bobc/bobc_hardware/Decapede/Decapede.jpg

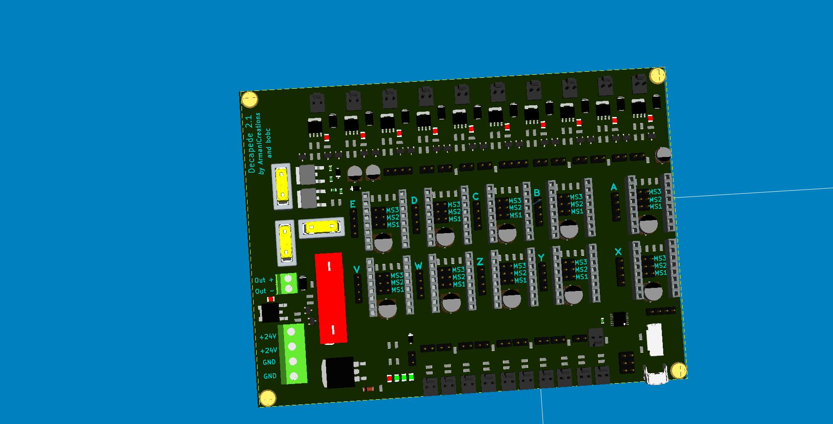
Decapede/Decapede.jpg
