bobc/bobc_hardware/CoreSam3x/CoreSam3x.png

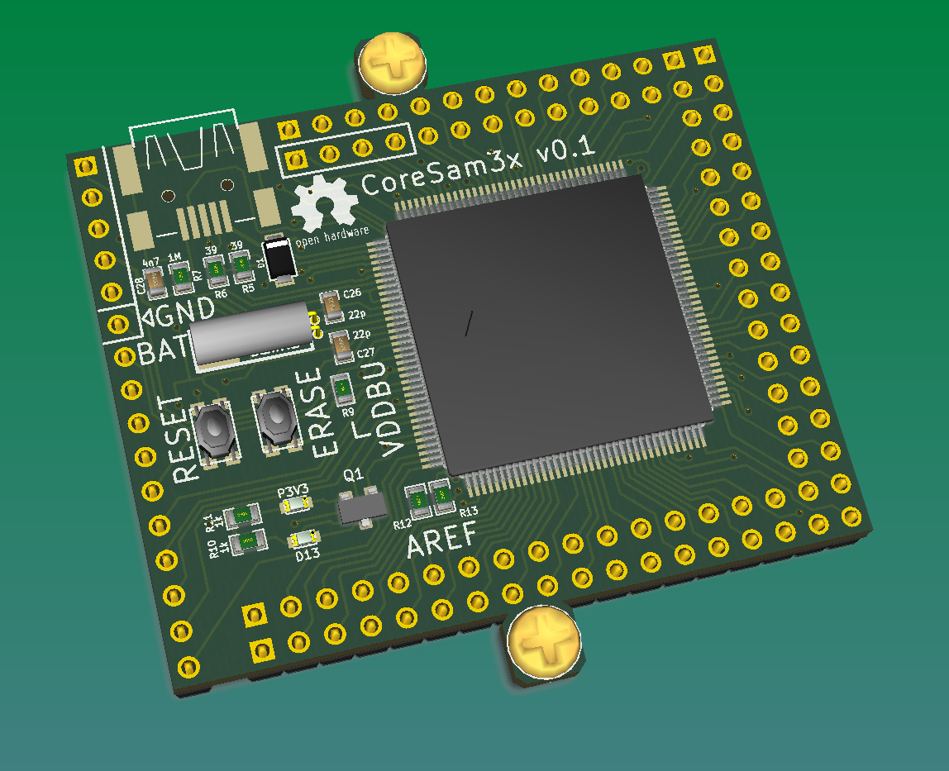
CoreSam3x/CoreSam3x.png
