bobc/bobc_hardware/Control Panel/control_panel.png

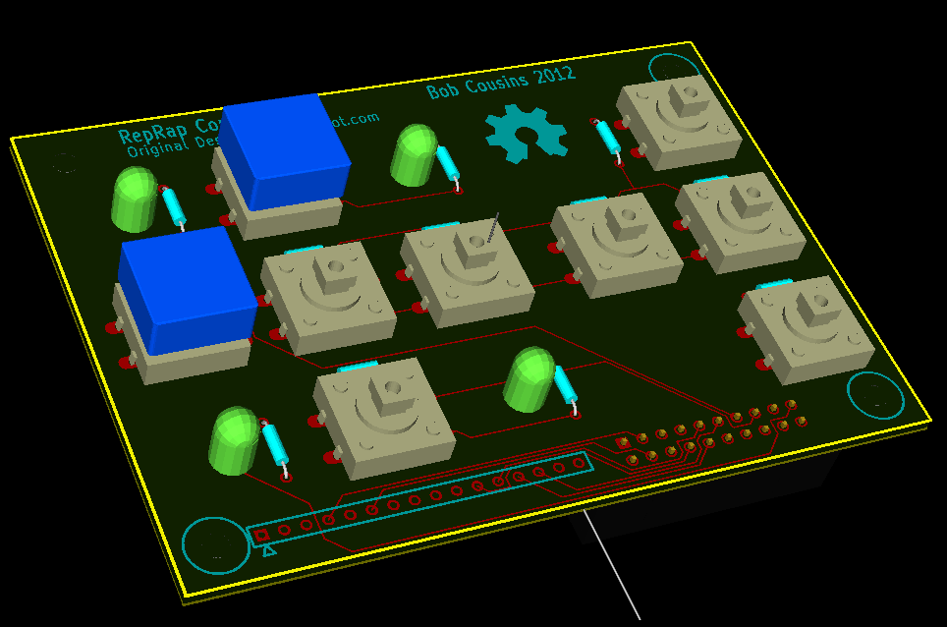
Control Panel/control_panel.png
