bobc/bobc_hardware/CoreSam3x/CoreSam3x_back.png

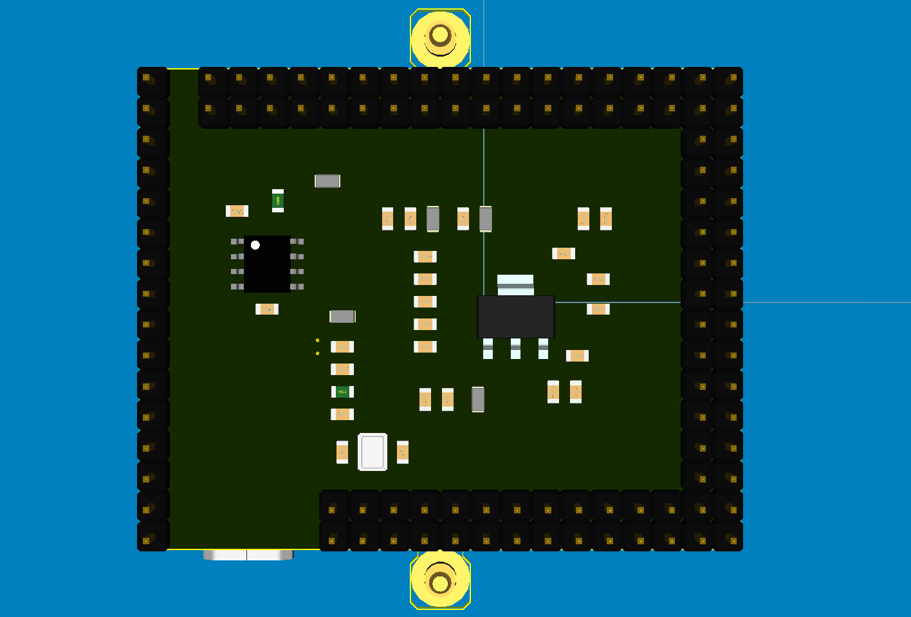
CoreSam3x/CoreSam3x_back.png
