bobc/bobc_hardware/CoreSam3x/CoreSam3x_top.png

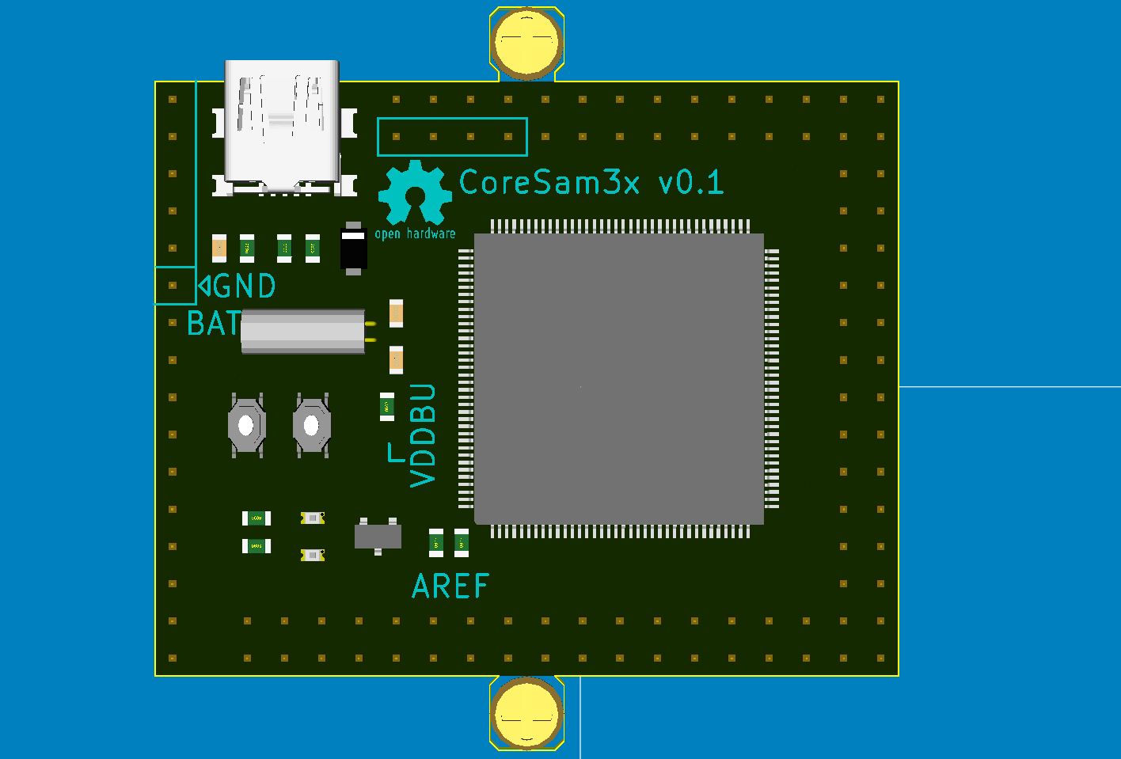
CoreSam3x/CoreSam3x_top.png
