bobc/bobc_hardware/Due-RIB/RIB_concept.png

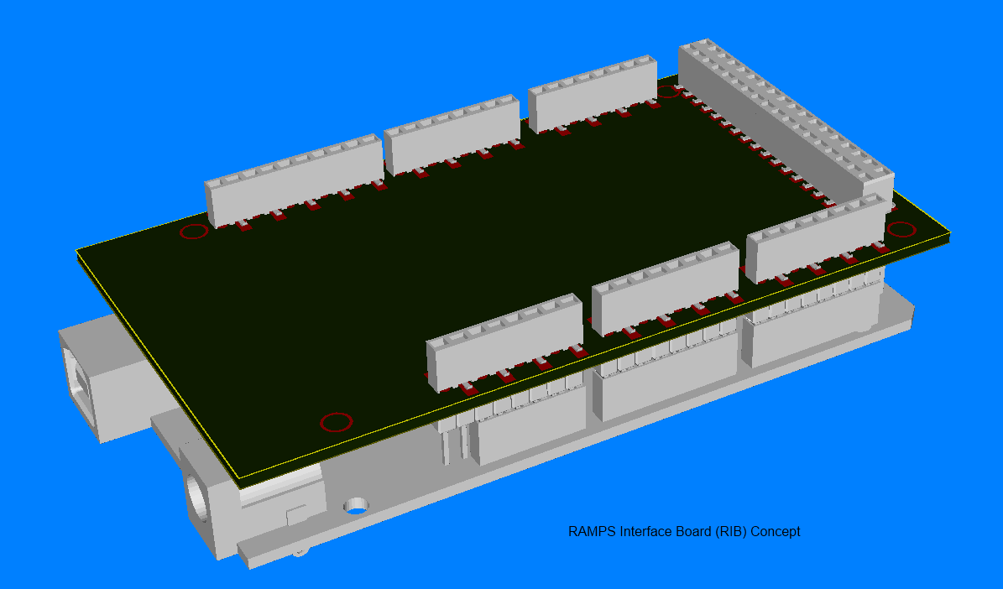
Due-RIB/RIB_concept.png
