bobc/bobc_hardware/matrix_clock_cc_4digit/matrix_clock.png

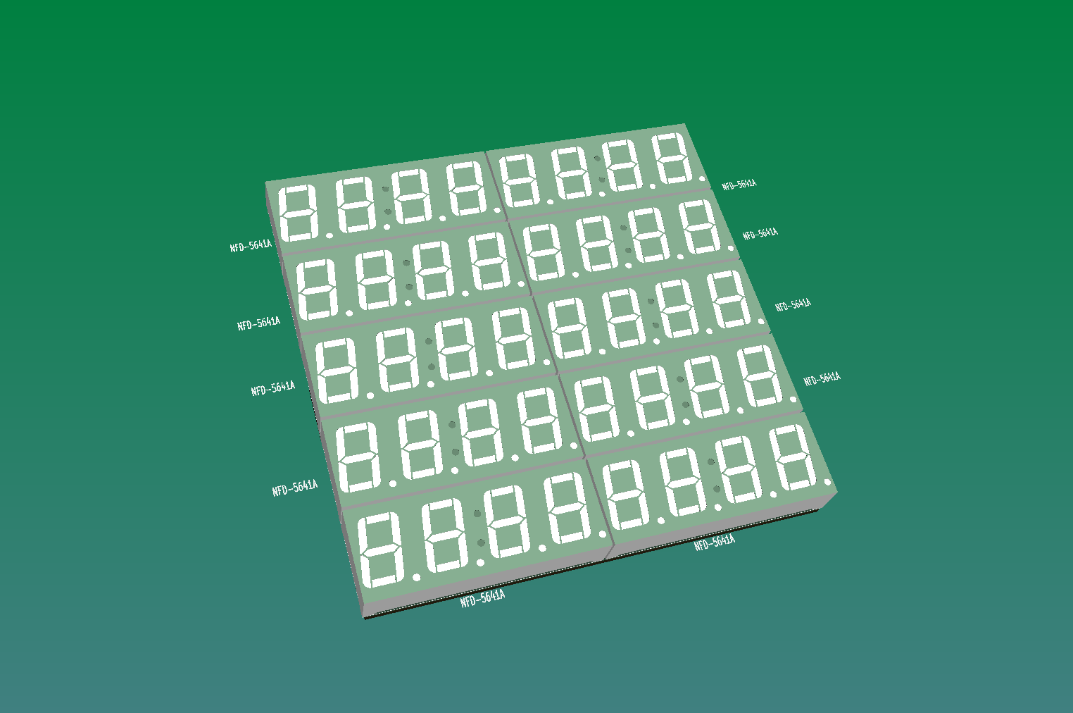
matrix_clock_cc_4digit/matrix_clock.png
