bobc/bobc_hardware/MS-F1/MS-F100-bottom.png

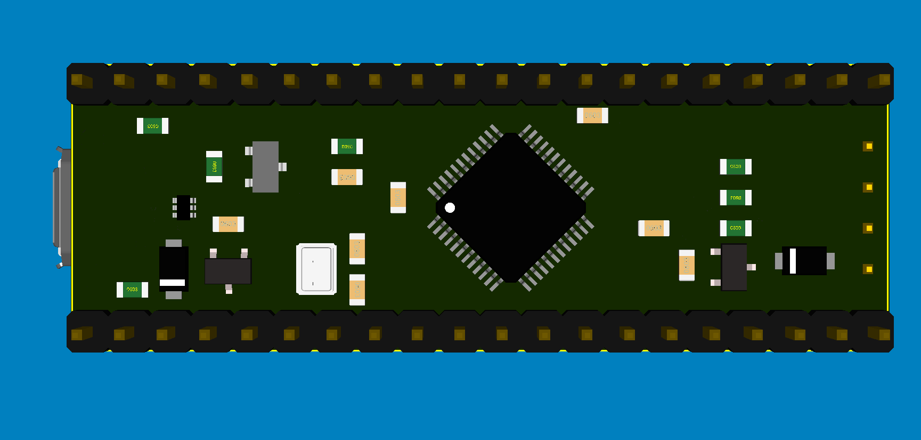
MS-F1/MS-F100-bottom.png
