bobc/bobc_hardware/MS-F1/MS-F100-top.png

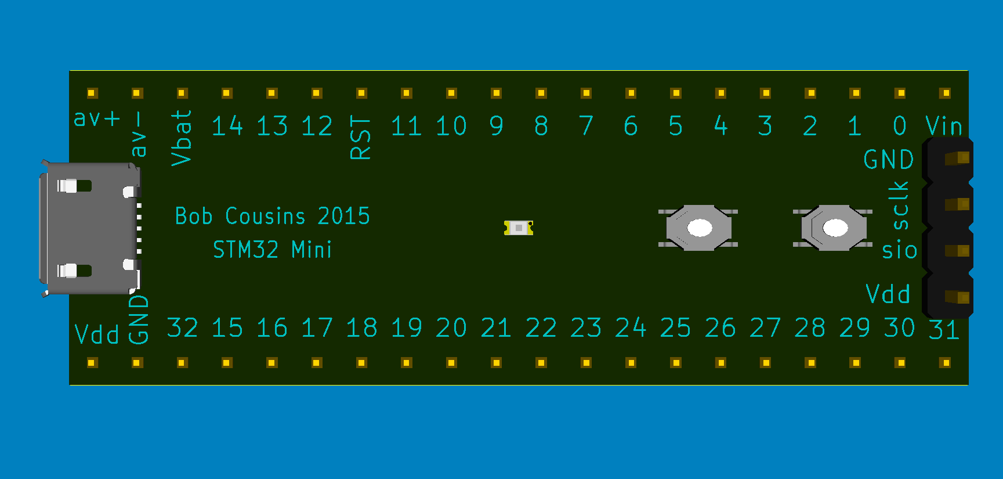
MS-F1/MS-F100-top.png
