bobc/bobc_hardware/RAMPS-FD-EXT/RAMPS-FD-EXT6.png

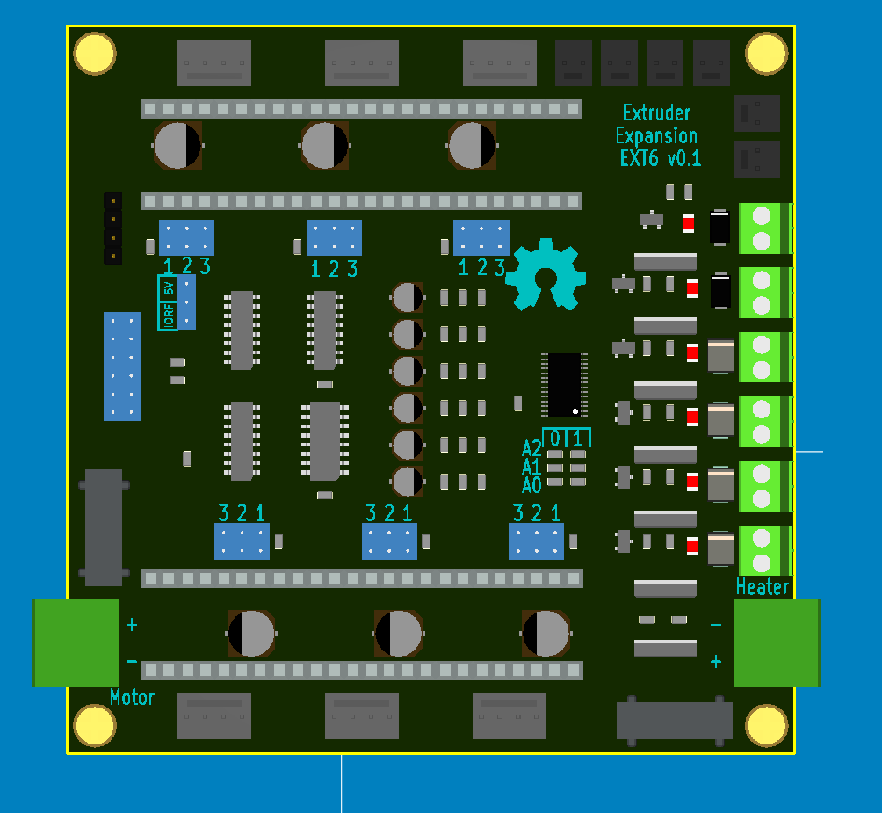
RAMPS-FD-EXT/RAMPS-FD-EXT6.png
