bobc/bobc_hardware/RAMPS-FD-EXT/RAMPS-FD-EXT.png

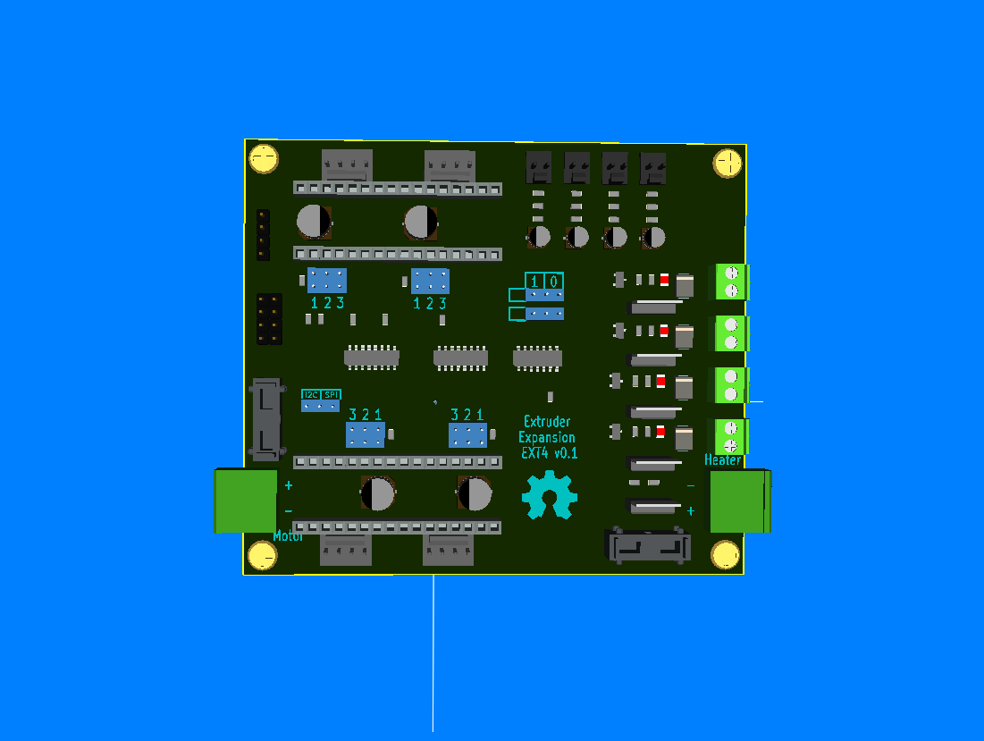
RAMPS-FD-EXT/RAMPS-FD-EXT.png
