bobc/bobc_hardware/RAMPS-FD/RAMPS-FD.png

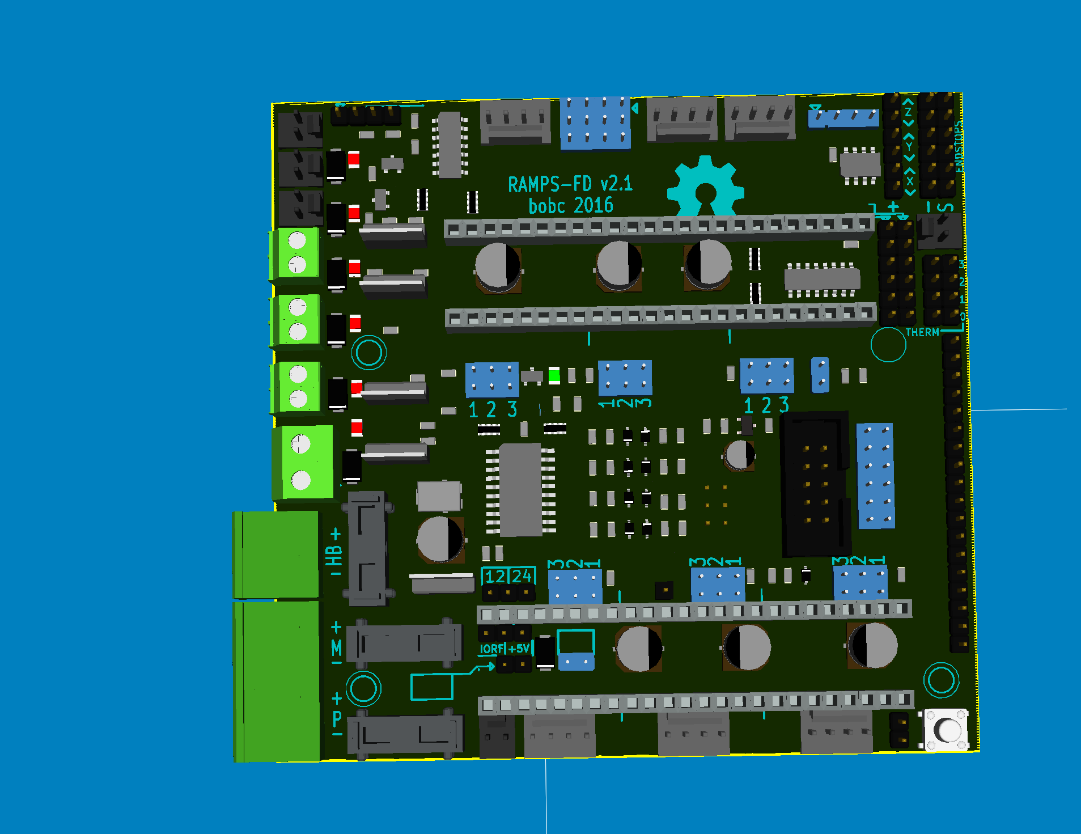
RAMPS-FD/RAMPS-FD.png
