bobc/bobc_hardware/sango-bob/sango-bob.png

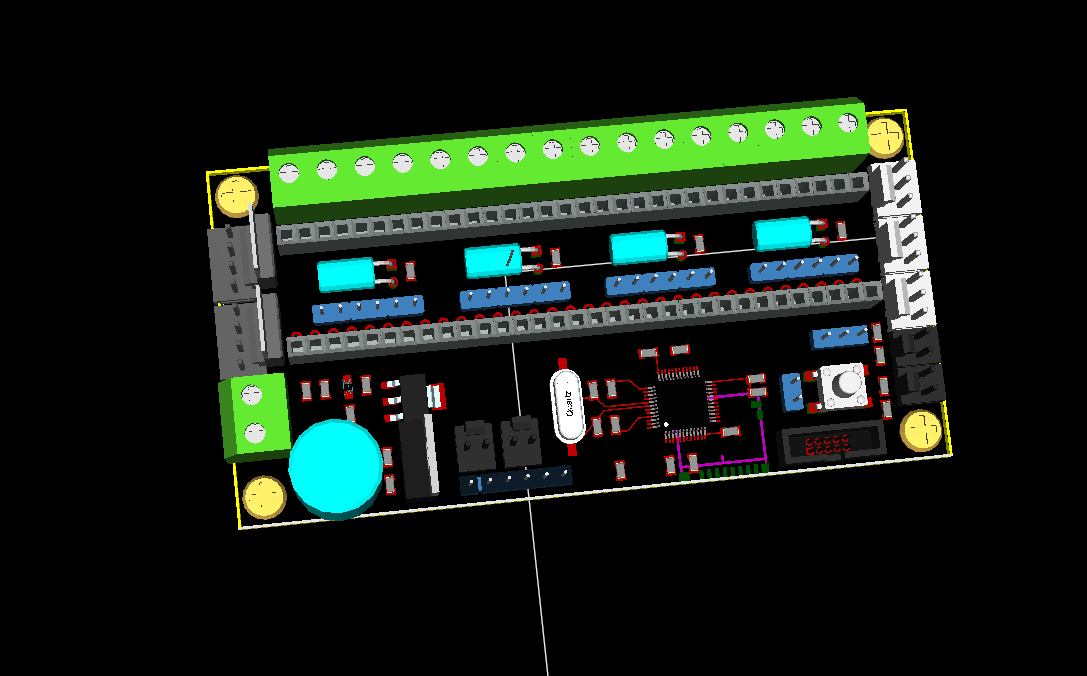
sango-bob/sango-bob.png
