bobc/bobc_hardware/stepstick-bc2/stepstick-bc2.png

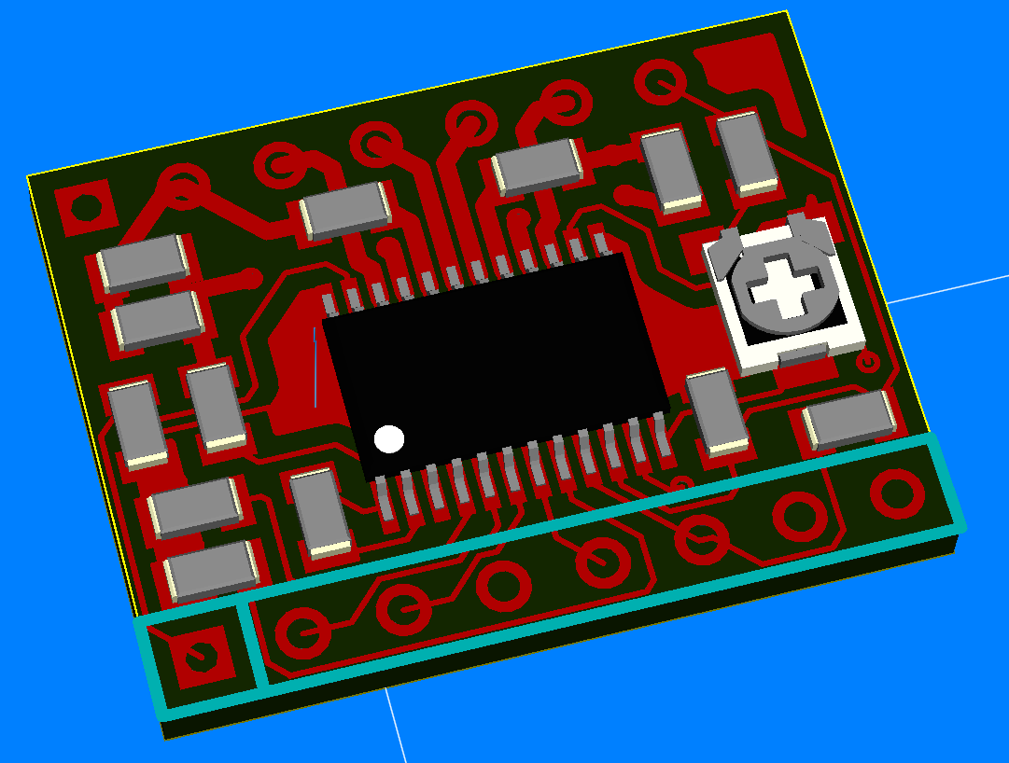
stepstick-bc2/stepstick-bc2.png
