bobc/bobc_hardware/CoreSam3x/CoreSam3x_BOM.ods

Id | Designator | Package | Quantity | Designation | Supplier and ref |  | Farnell | RS | Unit price (£) | Line total (£)
3 | C19,C4,C5,C10,C18,C17,C16,C12,C14,C15,C2,C8,C6,C7,C29 | SM0603_Capa | 15 | 0u1 | Kemet |  |  | 264-4630 | 0.022 | 0.330
5 | C21,C20,C23 | SM0603_Capa | 3 | 10p | Kemet |  |  | 264-4494 | 0.022 | 0.066
25 | C22 | SM0603_Capa | 1 | 0u01 | Kemet |  |  | 264-4595 | 0.022 | 0.022
6 | C24,C25 | SM0603_Capa | 2 | 10u | Murata |  |  | 723-5543 | 0.102 | 0.204
15 | C27,C26 | SM0603_Capa | 2 | 22p | Kemet |  |  | 264-4501 | 0.024 | 0.048
26 | C28 | SM0603_Capa | 1 | 4n7 | Kemet |  |  | 264-4589 | 0.022 | 0.022
4 | C3,C13,C1,C11 | SM0603_Capa | 4 | 4u7 | Kemet |  |  | 691-1164 | 0.048 | 0.192
20 | D1 | DO219AB | 1 | DIODE | Vishay | S07G-GS08 |  | 710-4556 | 0.076 | 0.076
29 | D2 | LED-0603 | 1 | D13 |  |  |  |  | 0.063 | 0.063
28 | D3 | LED-0603 | 1 | P3V3 |  |  |  |  | 0.063 | 0.063
16 | H1,H2 | HOLE_M2.5 | 2 | HOLE_RMC | na |  |  |  | 0.000 | 0.000
10 | L5,L3,L4,L1,L2 | SM0805 | 5 | 100Mhz | TDK | MMZ2012R300AT |  | 741-3157 | 0.033 | 0.165
8 | M1 | PCB_GREEN | 1 | PCB_GREEN_RMC |  |  |  |  | 1.000 | 1.000
32 | M2 | Logo_silk_OSHW_6x6mm | 1 | LOGO_OSHW | na |  |  |  | 0.000 | 0.000
30 | P1,P2 | PIN_ARRAY_12x1_RMC | 1 | PIN_ARRAY_12x2 | ebay |  |  |  | 0.500 | 0.500
27 | P3 | PIN_ARRAY_16x1_RMC | 1 | PIN_ARRAY_16x1 | ebay |  |  |  | 0.500 | 0.500
 | P8,P4,P5,P6 | PIN_ARRAY_16x1_RMC | 2 | PIN_ARRAY_16x2 | ebay |  |  |  | 0.750 | 1.500
22 | Q1 | SOT23GDS | 1 | BSS123 | Fairchild | BSS123 |  | 671-0321 | 0.109 | 0.109
21 | R10,R11 | SM0603_Resistor | 2 | 1k |  |  |  |  | 0.015 | 0.030
31 | R12,R13 | SM0603_Resistor | 2 | 0R |  |  |  |  | 0.015 | 0.030
2 | R4 | SM0603_Resistor | 1 | 6k8 |  |  |  |  | 0.015 | 0.015
14 | R5,R6 | SM0603_Resistor | 2 | 39R |  |  |  |  | 0.015 | 0.030
24 | R7 | SM0603_Resistor | 1 | 1M |  |  |  |  | 0.015 | 0.015
13 | R8 | SM0603_Resistor | 1 | 10k |  |  |  |  | 0.015 | 0.015
18 | R9 | SM0603 | 1 | 0R |  |  |  |  | 0.015 | 0.015
17 | S1 | SW_C&K_KMR4 | 1 | ERASE | C&K | KMR421NGLFS |  | 793-1605 | 0.250 | 0.250
19 | S2 | SW_C&K_KMR4 | 1 | RESET | C&K | KMR421NGLFS |  | 793-1605 | 0.250 | 0.250
9 | U1 | LQFP144 | 1 | ATSAM3X8E | Atmel | ATSAM3X8EA-AU |  | 769-2527 | 6.950 | 6.950
7 | U2 | SOT-223 | 1 | LM1117MP-3.3 | STMicroelectronics | LD1117S33TR |  | 714-0697 | 0.258 | 0.258
11 | U3 | CONN_MiniAB_SMT_RMC | 1 | USBCONN-HOSTCAPABLE | Molex | 67803-8020 |  | 720-6618 | 0.794 | 0.794
12 | U4 | SOIC-8 | 1 | SP2525A-1EN | Exar | SP2525A-1EN |  | 686-5430 | 0.456 | 0.456
1 | X1 | XTAL-3.2x2.5mm | 1 | CRYSTAL_4PIN | TXC | 7V-12.000MAHE-T |  | 753-7186 | 0.512 | 0.512
23 | X2 | crystal_tc-26_horiz | 1 | 32kHz | Fox Electronics | NC26LF-327 |  | 547-6979 | 0.299 | 0.299
 |  |  |  |  |  |  |  |  |  | 14.779
 |  |  |  |  |  | Based on qty 10+
 |  |  |  |  |  | Excludes VAT, shipping
