bobc/bobc_hardware/RAMPS-FD/RAMPS-FD_BOM.ods

Sheet: Sheet1
Designator | Package | Designation | Quantity | Digikey | RS
C204,C101,C205,C203,C202,C201,C206 | c_elec_6.3x7.7 | 100u 35V | 7 | 493-6420-1-ND | 725-8221
C301,C303,C302,C501 | c_elec_4x5.3 | 10u | 4 | 399-6664-1-ND | 537-0742
C102,C207,C305,C502,C503,C504,C505,C2,C1 | SM0805 | 100n 35V | 9 | 587-3364-1-ND | 648-0941
D101 | LED-0805_GREEN | LED GRN | 1 | 475-1410-1-ND | 466-3807
D203,D201,D202,D204,D901,D902 | LED-0805_RED | LED RED | 6 | 475-1415-1-ND | 497-4804
D102 | diode_do41 | 1N4004 | 1 | 1N4004-G | 628-9029
D301 |  | MBR0520 | 1 | MBR0520 | 739-0521
D103,D401,D404,D402,D403,D903,D904 | DO-214AC | ES1F | 7 | ES1FCT-ND | 670-8817
F101,F102,F103 | FUSE-MINI-AUTO |  | 3 | F065-ND | 360-7317
P105,P901,P902 | CONN_KK_2.54_2W |  | 3 | WM4200-ND | 679-5583
P204,P205,P206,P210,P212,P217 | CONN_KK_2.54_4W |  | 6 | WM4204-ND | 679-5596
P404 | mors_2p |  | 1 | 277-1263-ND | 189-5843
P101 | mstba_2,5/2-g-5,08 |  | 1 | 277-1106-ND | 189-6105
P107,P108 | Mstba_2,5/4-g-5,08 |  | 1 | 277-1108-ND | 189-6127
P103 | PIN_ARRAY single row 0.1” |  | 4 | S1012EC-40-ND | 547-3166
JP1 | PIN_ARRAY_X1 | 2
JP801 | PIN_ARRAY_X1 | 2
P302 | PIN_ARRAY_X1 | 2
K201 | PIN_ARRAY_X1 | 3
K202 | PIN_ARRAY_X1 | 3
K203 | PIN_ARRAY_X1 | 3
K204 | PIN_ARRAY_X1 | 3
K301 | PIN_ARRAY_X1 | 3
K302 | PIN_ARRAY_X1 | 3
K303 | PIN_ARRAY_X1 | 3
K304 | PIN_ARRAY_X1 | 3
K305 | PIN_ARRAY_X1 | 3
K306 | PIN_ARRAY_X1 | 3
P211 | PIN_ARRAY_X1 | 4
P213 | PIN_ARRAY_X1 | 18
P102 | PIN_ARRAY_X1 | 2
JP101 | PIN_ARRAY_X1 | 3
JP102 | PIN_ARRAY_X1 | 3
P2 | PIN_ARRAY_X1 | 4
P1 | PIN_ARRAY_X1 | 6
P216 | PIN_ARRAY_X1 | 6
 | PIN_ARRAY dual row 0.1” |  | 2 | 609-3494-ND | 547-3188
P203,P207,P208,P202,P201,P209 | pin_array_x2 | 18
P214 | pin_array_x2 | 5
P215 | pin_array_x2 | 6
P106 | pin_array_x2 | 3
P301 | pin_array_x2 | 4
P218,P403,P405 | RMC-pt_1,5-2-3,5-h |  | 3 | ED10546-ND | 707-5098
U201,U202,U203,U204,U205,U206 | POLOLU |  | 4 | S7022-ND | 767-9833
Q201,Q202,Q203,Q206 | TO-220AB_IRF2804_RMC | IRLB8743PBF | 4 | IRLB8743PBF-ND | 725-9325
Q204,Q205,Q501,Q502,Q901,Q902 | SOT23GDS | DMN2075U | 6 | DMN2075U-7DICT-ND | dmn2075
R101 | SM0805 | 150R | 1 | RMCF0805JT150RCT-ND | 721-6870
R210,R208,R207,R203,R202,R201,R304 | SM0805 | 100k | 7 | RMCF0805JT100KCT-ND | 223-0691
R212,R211,R2,R1 | SM0805 | NF
R214,R218,R510,R511 | SM0805 | 10k | 4 | RMCF0805JT10K0CT-ND | 740-9072
R221,R220,R219,R222,R905,R906 | SM0805 | 1k8 | 6 | RMCF0805JT1K80CT-ND | 223-0461
R303,R302,R301,R501,R305 | SM0805 | 4k7 | 5 | RMCF0805JT4K70CT-ND | 223-0528
R502,R503,R504,R505 | SM0805 | 22R | 4 | RMCF0805JT22R0CT-ND | 223-0203
RP1,RP3,RP2,RP801,RP802 | r_cat16-4 | 10k | 5 | CAT16-103J4LFCT-ND | 522-5412
SW101 | SW_6x6_MULTI | RESET | 1 | 450-1647-ND | 479-1441
U1 | SO14E | 74HC125 | 1 | MC74HC125ADGOS-ND | 113-0528
U2 | SO20L | 74HC244 | 1 | 568-1420-1-ND | 113-0168
U3 | LM78XXV | LM7812 | 1 | LM7812ACT-ND | 516-4834
U801 | SO16E | 74HC4050 | 1 | 568-1453-5-ND | 483-6544
Additional items
 | 2 way KK housing, 2.54mm
 | 4 way KK housing, 2.54mm
 | KK crimps
 | 2 way Molex housing 2.54mm
 | Molex crimps
 | 4 way plug, 5.08mm (optional) |  |  |  | 707-5405
 | 2 way plug, 5.08mm |  |  |  | 707-5391
P218 | 2 way plug, 3.5mm |  | 3 | ED10554-ND | 707-5032
 | 2 way jumpers
F103 | FUSE-MINI-AUTO | FUSE 15A | 1 | F992-ND | 563-570
F101,F102 | FUSE-MINI-AUTO | FUSE 10A | 2 | F991-ND | 563-485
 |  |  | 117 | 35

Sheet: Sheet2
7 | 493-6420-1-ND
4 | 399-6664-1-ND
9 | 587-3364-1-ND
1 | 475-1410-1-ND
6 | 475-1415-1-ND
1 | 1N4004-G
1 | MBR0520
7 | ES1FCT-ND
3 | F065-ND
3 | WM4200-ND
6 | WM4204-ND
1 | 277-1263-ND
1 | 277-1106-ND
1 | 277-1108-ND
4 | S1012EC-40-ND
1 | 609-3494-ND
3 | ED10546-ND
4 | S7022-ND
4 | IRLB8743PBF-ND
6 | DMN2075U-7DICT-ND
1 | RMCF0805JT150RCT-ND
7 | RMCF0805JT100KCT-ND
4 | RMCF0805JT10K0CT-ND
6 | RMCF0805JT1K80CT-ND
5 | RMCF0805JT4K70CT-ND
4 | RMCF0805JT22R0CT-ND
5 | CAT16-103J4LFCT-ND
1 | 450-1647-ND
1 | MC74HC125ADGOS-ND
1 | 568-1420-1-ND
1 | LM7812ACT-ND
1 | 568-1453-5-ND
3 | ED10554-ND
1 | F992-ND
2 | F991-ND
116 | 35
