bobc/bobc_hardware/sango-bob/sango-bom.ods

Sheet: Sheet1
C9 | 1000uF
C4 | 100nF
C13 | 100nF
C14 | 100nF
C15 | 100nF
C16 | 100nF
C17 | 100nF
C5 | 100uF
C6 | 100uF
C10 | 100uF
C11 | 100uF
C7 | 10uF
C8 | 10uF
C12 | 10uF
C18 | 10uF
C1 | 20pF
C2 | 20pF
C3 | 330nF
D1 | LED
JP1 | JUMP_MINI
JP2 | JUMP_MINI
JP3 | JUMP_MINI
JP4 | JUMP_MINI
JP5 | JUMP_MINI
JP6 | JUMP_MINI
JP7 | JUMP_MINI
JP8 | JUMP_MINI
JP9 | JUMP_MINI
JP10 | JUMP_MINI
JP11 | JUMP_MINI
JP12 | JUMP_MINI
JP13 | JUMP_MINI
K1 | CONN_3
K2 | CONN_3
K3 | CONN_3
K4 | CONN_3
P11 | 1PIN_TH
P12 | 1PIN_TH
P13 | 1PIN_TH
P14 | 1PIN_TH
P1 | CONN_2
P4 | CONN_2
P5 | CONN_2
P7 | CONN_2
P8 | CONN_2
P6 | CONN_4
P10 | CONN_4
P20 | CONN_6
P16 | MOT_E1
P2 | MOT_X
P3 | MOT_Y
P15 | MOT_Z
Q1 | MOSFET_N_RMC
Q2 | MOSFET_N_RMC
R13 | 510
R1 | 100k
R2 | 100k
R8 | 100k
R9 | 100k
R5 | 10k
R6 | 10k
R12 | 10k
R11 | 12k
R7 | 1k
R3 | 4k7
R4 | 4k7
R10 | NF
SW1 | RST
U4 | 1117
U1 | 7805
X1 | 8MHz
U8 | CONN_CORTEX_DEBUG
U9 | CONN_MICROSD
U6 | POLOLU-E1
U2 | POLOLU-X
U3 | POLOLU-Y
U5 | POLOLU-Z
U7 | STM32F100_48

Sheet: Sheet2
Id | Designator | Package | Quantity | Designation | Supplier and ref | Cost
23 | C5,C6,C10,C11 | C1V5H | 4 | 100uF | 684-1905 | 0.0800 | 0.320
24 | C9 | C2V10 | 1 | 1000uF | 684-1920 | 0.2320 | 0.232
25 | X1 | HC49-US_Minimized | 1 | 8MHz | 478-9347 | 0.4500 | 0.450
32 | P12,P14,P13,P11 | HOLE_M3 | 4 | 1PIN_TH | n/a | 0.0000 | 0.000
31 | D1 | LED-0805 | 1 | LED | 497-4804 (http://uk.rs-online.com/web/p/visible-led/4974804/) | 0.0700 | 0.070
15 | U1 | LM78XXV | 1 | 7805 | 516-5938 | 0.3960 | 0.396
37 | U9 | MICRO_SD_DM3D | 1 | CONN_MICROSD | 738-8809 (http://uk.rs-online.com/web/p/memory-card/7388809/) | 0.7800 | 0.780 |  | option
30 | P1 | PCB_SCREW_TERM_2 | 1 | CONN_2 | 710-0093 | 0.2700 | 0.270
28 | P16 | PCB_SCREW_TERM_4 | 4 | MOT_E1 | 710-0374 | 0.1250 | 0.500
26 | P2 | PCB_SCREW_TERM_4 | 1 | MOT_X |  |  | 0.000
27 | P3 | PCB_SCREW_TERM_4 | 1 | MOT_Y |  |  | 0.000
29 | P15 | PCB_SCREW_TERM_4 | 1 | MOT_Z |  |  | 0.000
12 | P5,P8,P4,P7 | PIN_ARRAY_2X1 | 4 | CONN_2 | 679-5583 | 0.0660 | 0.264
13 | JP1,JP2,JP3,JP4,JP5,JP6,JP7,JP8,JP9,JP10,JP12,JP11,JP13 | PIN_ARRAY_2X1 | 13 | JUMP_MINI | 547-3166 | 0.0244 | 0.317
11 | K4,K3,K2,K1 | PIN_ARRAY_3X1 | 4 | CONN_3 | 679-5587 (http://uk.rs-online.com/web/p/headers-pcb-receptacles/6795587/) | 0.0890 | 0.356
10 | P10,P6 | PIN_ARRAY_4x1 | 2 | CONN_4 | 679-5596 (http://uk.rs-online.com/web/p/headers-pcb-receptacles/6795596/) | 0.1250 | 0.250
22 | U8 | Pin_Array_5x2_1.27mm_RMC | 1 | CONN_CORTEX_DEBUG | 681-1184 (http://uk.rs-online.com/web/p/headers-pcb-receptacles/6811184/) | 0.6700 | 0.670 |  | option
14 | P20 | PIN_ARRAY-6X1 | 1 | CONN_6 |  | 0.0733 | 0.073
33 | U6 | POLOLU | 4 | POLOLU-E1 |  | 4.7300 |  | 18.92
36 | U2 | POLOLU | 1 | POLOLU-X |  |  |  | 0
35 | U3 | POLOLU | 1 | POLOLU-Y |  |  |  | 0
34 | U5 | POLOLU | 1 | POLOLU-Z |  |  |  | 0
 |  |  | 8 | 8 way 0.1” header | 488-1724 (http://uk.rs-online.com/web/p/headers-pcb-receptacles/4881724/) | 0.3830 | 3.064
16 | U7 | QFP48_0.5mm_7x7mm_SOT313_LPC1343 | 1 | STM32F051C8T6 | 761-8658 (http://uk.rs-online.com/web/p/microcontrollers/7618658/) | 1.7800 | 1.780
4 | R9,R2,R1,R8 | SM0805 | 4 | 100k | 721-7094 (http://uk.rs-online.com/web/p/surface-mount-fixed-resistors/7217094/) | 0.0900 | 0.360
8 | C4,C13,C14,C15,C16,C17 | SM0805 | 6 | 100nF | 648-0957 (http://uk.rs-online.com/web/p/ceramic-multilayer-capacitors/6480957/) | 0.1100 | 0.660
3 | R5,R6,R12 | SM0805 | 3 | 10k | 740-9072 | 0.0200 | 0.060
18 | C12,C7,C8,C18 | SM0805 | 4 | 10uF | 723-6017 (http://uk.rs-online.com/web/p/ceramic-multilayer-capacitors/7236017/) | 0.1020 | 0.408
20 | R11 | SM0805 | 1 | 12k | 223-0578 (http://uk.rs-online.com/web/p/surface-mount-fixed-resistors/2230578/) | 0.0200 | 0.020
7 | R7 | SM0805 | 1 | 1k | 223-0427 (http://uk.rs-online.com/web/p/surface-mount-fixed-resistors/2230427/) | 0.0200 | 0.020
6 | C1,C2 | SM0805 | 2 | 20pF | 698-3358 (http://uk.rs-online.com/web/p/ceramic-multilayer-capacitors/6983358/) | 0.1800 | 0.360
9 | C3 | SM0805 | 1 | 330nF | 723-6079 (http://uk.rs-online.com/web/p/ceramic-multilayer-capacitors/7236079/) | 0.1200 | 0.120
5 | R4,R3 | SM0805 | 2 | 4k7 | 223-0528 (http://uk.rs-online.com/web/p/surface-mount-fixed-resistors/2230528/) | 0.0200 | 0.040
21 | R13 | SM0805 | 1 | 510 | 679-1519 (http://uk.rs-online.com/web/p/surface-mount-fixed-resistors/6791519/) | 0.0200 | 0.020
19 | R10 | SM0805 | 1 | NF |  |  | 0.000
2 | U4 | SOT223 | 1 | 1117 | 661-6257 (http://uk.rs-online.com/web/p/low-dropout-voltage-regulators/6616257/) | 0.2100 | 0.210
17 | SW1 | SW_6x6_MULTI | 1 | RST | 686-6907 (http://uk.rs-online.com/web/p/tactile-switches/6866907/) | 0.2300 | 0.230
1 | Q1,Q2 | TO-220AB_IRF2804_RMC | 2 | STP36NF06 (http://uk.rs-online.com/web/p/mosfet-transistors/4862262/) | 486-2262 (http://uk.rs-online.com/web/p/mosfet-transistors/4862262/) | 0.6600 | 1.320
 |  |  | 1 | PCB |  |  | 1.600
 |  |  |  |  |  | £ | 15.2205 | 18.92 | 34.1405
 |  |  |  |  |  | $ | 24.46 | 30.40 | 54.86
 |  | 1.60689
 |  |  |  |  | 679-5596 | 0.125

Sheet: Sheet3
1 | "RV1" | "TRIM-EVM3Y-RMC" | 1 | "10k" | 731-2883 (http://uk.rs-online.com/web/p/trimmer-resistors/7312883/) | 0.416 | 0.416
2 | "C1,C2" | "SM0805" | 2 | "0.22uF" | 648-0884 (http://uk.rs-online.com/web/p/ceramic-multilayer-capacitors/6480884/) | 0.135 | 0.270
3 | "R6,R5" | "SM0805" | 2 | "0.2" | 721-5577 | 0.144 | 0.288
4 | "R4" | "SM0805" | 1 | "10k" | 740-9224 (http://uk.rs-online.com/web/p/surface-mount-fixed-resistors/7409224/) | 0.030 | 0.030
5 | "R3,R2" | "SM0805" | 2 | "100k" | 740-9075 (http://uk.rs-online.com/web/p/surface-mount-fixed-resistors/7409075/) | 0.030 | 0.060
6 | "R1" | "SM0805" | 1 | "20k" | 721-7047 (http://uk.rs-online.com/web/p/surface-mount-fixed-resistors/7217047/) | 0.030 | 0.030
7 | "C7,C6,C5,C4" | "SM0805" | 4 | "0.1uF" | 264-4416 (http://uk.rs-online.com/web/p/ceramic-multilayer-capacitors/2644416/) | 0.090 | 0.360 | 264-4416
8 | "C3" | "SM0805" | 1 | "4.7uF" | 749-2153 (http://uk.rs-online.com/web/p/ceramic-multilayer-capacitors/7492153/) | 0.098 | 0.098 | 723-6041 (http://uk.rs-online.com/web/p/ceramic-multilayer-capacitors/7236041/)
9 | "P2,P1" | "SIL-8" | 2 | "CONN_8" | 488-1724 (http://uk.rs-online.com/web/p/headers-pcb-receptacles/4881724/) | 0.383 | 0.766
10 | "U1" | "tssop-24-pad" | 1 | "A4985-LP" | 724-8713 | 2.410 | 2.410 | A4982 = 2.86
11 | "R7" | "JUMP_MINI_RMC" | 1 | "0R"
 |  |  | For quantity = 10 |  |  |  | 4.728
 |  |  |  |  | 721-5394 (http://uk.rs-online.com/web/p/surface-mount-fixed-resistors/7215394/)
 |  |  |  |  | 740-9145 (http://uk.rs-online.com/web/p/surface-mount-fixed-resistors/7409145/)

Sheet: Sheet4
Id | Designator | Package | Quantity | Designation | Supplier and ref
1 | R1,R4,R7 | SM0805 | 3 | 4k7 |  | 0.090 | 0.270
2 | C1,C10,C9,C8,C7 | SM0805 | 5 | 100nF | 264-4416 (http://uk.rs-online.com/web/p/ceramic-multilayer-capacitors/2644416/) | 0.030 | 0.150
3 | R2,R3 | SM0805 | 2 | 2k2 |  | 0.090 | 0.180
4 | P1 | SIL-8 | 1 | CONN_8 |  |  | 0.000
5 | P3 | SIL-6 | 1 | ICSP |  |  | 0.000
6 | P4 | SIL-6 | 1 | CONN_6 |  |  | 0.000
7 | U4 | Multiwatt15 | 1 | L298 | 403295 | 1.700 | 1.700 | 2.66
8 | P5,P6,P7,P2 | SIL-2 | 4 | CONN_2 |  |  | 0.000
9 | R8 | SM0402 | 1 | 0R |  | 0.000 | 0.000
10 | U1 | SO20L | 1 | 16F1507 |  | 0.740 | 0.740
11 | D1,D2,D3,D4,D5,D6,D7,D8 | SM0805 | 8 | DIODESCH | 698-7029 | 0.077 | 0.616
12 | JP1 | PIN_ARRAY_2X1 | 1 | JUMP_MINI |  |  | 0.000
13 | R5,R6 | SM2512 | 2 | 0R24 | 683-6603 | 0.438 | 0.876
14 | R9 | SM0805 | 1 | 1k |  | 0.090 | 0.090
15 | D9 | sod123 | 1 | 3V | 751-3733 | 0.029 | 0.029
 | Heatsink |  |  |  |  | 0.500
 |  |  |  |  |  |  | 4.651
 |  |  |  |  | 721-5577
 |  |  |  |  | 724-0309 | 0.261
