bobc/bobc_hardware/(threads)

Thread 28 (2015-10-28):

DXF file for RAMPS-FD board

YasuoSuto, 2015-10-28:
Hi,
I'm Yasuo Suto.
I'll try to use RAMPS-FD for delta type 3D printer.
So, my mechanic colleague request the DXF file of RAMPS-FD in order to design the box of the board set (Aruduino due + RAMPS-FD).
I had gotten the garbar data, but I don't have DXF exchage tool which this garber data format.
If you have DXF file, please send it to me or upload the site.
My e-mail address is below.
y-sutou@techno7.co.jp

Best regards,
Yas

YasuoSuto, 2015-10-28:
If you don't have DXF file, can i have the drawing of this board which can see the board size and hight.
Best regards,
Yas

bobc, 2016-04-24:
I don't have DXF files for previous versions, but I will try to add a DXF in future.

mkeyno, 2016-05-12:
hi @bobc , I saw your activities on Due board modification is long ago , I was wondering whether have any plan to pursuit what you started on Due shield for CNC

Thread 29 (2017-01-16):

Ramps-FD: I like buy empty pcb

pityuka3d, 2017-01-16:
It would like to be built up one 3d printer using your panel (REMPS-FD) this will be the third machine what I prepare. Unfortunately home manufacturing too thin the lines on the mucus sheet. I can buy an empty pcb from you possibly, or a full-fledged one?
I'm sorry, but my English not the best one.
Thanks
Istvan

boelle, 2018-05-30:
one year late answer, but the best i think is to ask a place like oshpark to make a board from the files published

Thread 30 (2017-02-03):

RAMPS-FD: LM7812 gets very hot

fullTalgoRythm, 2017-02-03:
When running @24v with JP102 -VSEL pins 1-2 selected I found that the 7812 is getting very hot. I could actually smell it even with a fan running. I believe this would be a fairly typical problem when trying to drop 12v over a linear regulator like this one. I know there are a number of workarounds and personally I replaced mine with a cheap buck converter (LM2596). I can see it is still spec'd so I thought maybe you could investigate some alternatives. Myself I wouldn't mind a separate input for board power / hotend & fans and then just supply my own power (I did briefly feed 12v in via pin 2 of JP102 but it was a messy solution). It's probably not what most others would want but would make a nice option.

vido89, 2017-11-02:
The only safe version of Ramps-FD is the V2.A, issued in February 2014 so Im assuming that you are using V1 REV A

Thread 32 (2018-03-11):

GERBER, Schematic and BOM do not match

Kondziol, 2018-03-11:
Hello,

I'm trying to do the RAMPS FD board for myself from scratch, and I encountered incompatibilities in the files. e.g the diagram has 220 ohm resistors that are not in the BOM. Please inform me if schematic and garber are correct and only BOM is not complete?

I already have a ready board and I do not know whether to solder it.

Best regards

blacslam, 2018-04-12:
Hi,
I`m not bobc, but from what i now (photos from the internet from other people who made ramps-fd) schematic and gerbers are ok, and only BOM file is obsolete. So you need to use something like Eagle software and generate a new bom. main difference is resistors, schottky diode, series of IC (now its ACT not HC).
So i hope you didnt buy all components from BOM.

Thread 33 (2018-05-30):

5V drivers logic

rafaljot, 2018-05-30:
I have S109 drivers based on TB67S109AFTG. They need vcc=5V.
May I set VLOG JP101 to 3-2, (FD_5V) with Due ?

bobc, 2018-05-30:
> May I set VLOG JP101 to 3-2, (FD_5V) with Due ?

No, do not do that, it may damage your Due. Only use JP101 pins 2-3 if you have a 5V baseboard like Arduino Mega AND the Mega is an old version that does not supply 5V on IOREF.

> They need vcc=5V.

Really? According to the TB67S109A datasheet, VCC is an output from the TB67S109A's internal regulator.

I don't know what modules you have, but according to https://www.aliexpress.com/store/product/4pcs-Lot-3D-Printer-Stepstick-S109-Stepper-Motor-Driver-Compatible-with-57-Stepper-Motor/1757194_32809825741.html the modules will work with 3.3V logic.

If you have those modules, they should work with Due at 3.3V.

rafaljot, 2018-05-30:
Thank you!
Yes I have this one. It works with 5V,  with Mega. in my Velleman Vertex K8400. With FD it looks like only EN works and ignores STEP/DIR.
BTW: not bed solutions for 2.5amps motors, for extruder.

bobc, 2018-05-30:
The usual problem with Due is the pulse width is much shorter than AVR, because of the faster CPU. Allegro A4988 etc drivers can cope with short (1us) pulse width, but other drivers need a longer pulse, According to data sheet for 'S109 the minimum pulse is 10us. With whatever firmware you are using, try increasing the pulse width on the STEP signal.

Thread 34 (2018-05-30):

Update... would it make sense?

boelle, 2018-05-30:
as per subject would it make sense to update Ramps FD ? are there any improvements that could be made?

boelle, 2018-05-30:
Well the problem with RADDS is that that its not open source so you cant check it yourself and it cost an arm+leg as only the people behind them sell it. So i would not count it.... of course its an option and then again my toes are making knots on themselfes

There are of course boards like duet and smoothie, one has onboard stuff and the other has not been updated in a while, and so far firmware like marlin and repetier have not been ported to run with it

I think the negative feedback is due to china took the first versions and just made a pile of them without reading the warnings, as a results there are still a big amount in circulation that only gives the board a bad name.  I still think that ramps-fd has its place but due to the above there is a lot to fight against

btw... when i opened the files in kicad it said that the special lib was missing. is that one you made up or can i download that somewhere?

boelle, 2018-05-30:
just had a look around and yeah most sellers are still selling rev 1 a and we can thank geeetech for all the negative press :-(

i also looked if any of the forks have been updated and that was not the case

i want to see if i can make improve it, but that missing lib (special) is bugging me.

if i ignore it there are quite a bit on the schematic that are not connected. not sure if that is related to the missing lib

any chance you have the lib and maybe also a BOM ?

bobc, 2018-05-30:
It's a no win situation, retain control like RADDS but without FOSS, or go FOSS and lose control to Chinese cloners like RAMPS-FD, Smoothieboard etc. Meanwhile users just buy the cheapest and then complain about lack of support...

From the little feedback I get, there are not many pressing updates to make (apart from add loads of features for zero cost :) ) I guess the two things are the temperature inputs and power supplies. If I had the knowledge, I would add buffers to protect the ADCs, and switched mode power supplies. I think there would also need to be an officially supported LCD control board, that seems pretty standard now.

special.lib is a standard KiCad library that was removed, it is not needed by RAMPS-FD so you can ignore the error. You will need to "rescue" components, because the standard libraries changed.

The two forks were being sold on OSHPark etc, I had to prod them to publish source files... kinda sad that even FOSS supporters don't follow the GPL! Hard to complain about the Chinese not following the rules if we don't ...

boelle, 2018-05-30:
oki thanks for the explaination... will try and see if i can manage the rescue after some sleep :-D

But yeah, GPL goes both ways and you cant blame others if you dont comply yourself

Do you have a BOM also ? no rush but it would help if i go ahead and want to make a board for my next printer. sourcing parts  can be a pain :-)

rafaljot, 2018-05-31:
I have several boards, Duet wifi, RAMPSs 1.4, 1.5, 1.6, MKS, vellman boards,  RAMPS-FD v1 and 2.1
I like the RAMS-FD 2.1 the most. The best versatile shield for Due in my opinion.

What I could want more?
- support for steppers with SPI control, sensorless homing
- better support for 2 x PTC100 instead terminators. and just simple 4.7K for bed.

boelle, 2018-05-31:
but i guess we can sum up to this so far:

add buffers to protect the ADCs, and switched mode power supplies
if not on board allready an SPI connector
CS pins for the stepper drivers
either PT100 addon or on board

rafaljot, 2018-05-31:
Yes, it easy to add SPI but some modern board has more elegant solutions. BTW: Its time to design new stepstick standard....

one guy from Poland has an interesting idea for 12V section. Standard, chip DC-DC step-down mounted over on board.
https://reprapy.pl/download/file.php?id=8036&mode=view
https://reprapy.pl/download/file.php?id=8081&mode=view

src: https://reprapy.pl/viewtopic.php?f=19&t=2533&hilit=due3dom

boelle, 2018-05-31:
"one guy from Poland has an interesting idea for 12V section. Standard, chip DC-DC step-down mounted over on board."

that is what @bobc suggested, but yeah maybe modules are more easy to integrate

yes where did you buy the ramps fd 2.1?

rafaljot, 2018-05-31:
I answered above
https://reprapy.pl/download/file.php?id=8082&mode=view

look at MS1,MS2,MS3,MS4/SPI configuration

bobc, 2018-05-31:
Just for info, RAMPS-FD moved to its own repo, https://github.com/bobc/RAMPS-FD/tree/dev
I think I didn't update the BOM because I didn't really finalise the design.

The reason for having 12V and 24V was because some people wanted to run motors at 24V, but also  and fans, LED strips at 12V. There are lots of combinations, it would be a lot simpler to have all 12V or 24V.
I did think about using a separate DC-DC module, but there is no standard.

boelle, 2018-05-31:
hehehe, @rafaljot game me think link on facebook and i just finished adjust all the 3d stuff. its nice to have some eyecandy :-D

the 2.2 version had far less rescue to do

a partial BOM would also be usefull

if you dont mind i could make a google sheet with shop links etc.

how it looks without any mods.... if anything i would change the 3d model for the shield connectors so it  does not include the mega/due board but just the pin headers

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

Antscran, 2018-05-31:
Hi, Juts been following this thread and this current discussion, so hope you don't mind me adding a comment.  It would be great to see the RAMPS-FD revisited and couldn't agree more with your comment Boelle.
> Well the problem with RADDS is that that its not open source so you cant check it yourself and it cost an arm+leg as only the people behind them sell it.

I have done some design work before and would also help with any prototyping costs if there is enough support for the idea.
Cheers,Ant

boelle, 2018-05-31:
Q... how do i edit a WRL file? i want to edit the wrl for the due shield so it only have the pins under the rams fd board...

i tried freecad but failed

bobc, 2018-05-31:
Hmm, it seems I have several local changes that I haven't pushed to github. I can probably find time tomorrow to push the latest changes.

I tried getting a quote from Macrofab for 10 off assembled boards, it was around $1200 for 10 boards, which is about 4x the price RAMPS-FD found on ebay. There are some cheaper services based in China, but I didn't get any quotes.

boelle, 2018-05-31:
i could imagine that getting them made outside china will cost quite a bit more

No rush on the last changes, i think the biggest job if anything would be to convince people that the board has a place.

if you have a partial BOM that would be usefull too

boelle, 2018-05-31:
i have started the "painfull" process of making a BOM. I decided to split it up in small chunks that follows the schematic

https://docs.google.com/spreadsheets/d/1RLnmdB46gqgr1EFkkU6c9ktHnhKonsIwyvMgGwauXlQ/edit?usp=sharing

for now everyone can comment on the sheet but no edits

should we be so damm lucky that people gets interested and we need to get more organized etc those permissions can be changed :-D

rafaljot, 2018-06-01:
@bobc ask  this men from China ( @yyf2009,  sylyyf2009 at hotmail com ) as I understand he was interested in producing RAMPS-FD 2.2 and final list price I got was much lower then $1200 per 10.
They talked about it in this thread https://github.com/MarlinFirmware/Marlin/issues/9484
I have two pieces FD2.1 from him, they look better then average China production, definitely better terminals for instance.

boelle, 2018-06-01:
Ideal it should be us telling the man from china precise what parts we want on the board and what brand each part should have so we know 100% that its the right parts for the job

and there might be small changes to the board also

would say its a bit to early for big production runs.

for that kind of thing we still need to convince many people that Ramps FD is not "junk" etc.

yyf2009, 2018-06-01:
@boelle @bobc  I already have V2.2 pcb, but I haven't assembled yet. I don't know who needs it. For the V2.1 board, I want to say that I have produced a batch. If you need, you can contact me. Can also produce any board

boelle, 2018-06-01:
@yyf2009 since V2.2 is alsmost the same as V2.1 we can compare prices... what did the assembled V2.1 cost?

i started up this thread as i think Ramps FD has its place, its just a shame that Geetech took the first versions that where not safe and flooded the market. Everyone things Ramps FD is a BAD board.

We need to do this right and use time to go over every little detail so that everything is checked and rechecked

I have nothing against if the boards are made in china, as long we have  some control over what parts goes on the board. Of course that will also dictate the price

boelle, 2018-06-01:
and also remember that V2.2 is not 100% complete yet

@bobc still wants some features added to it

- add buffers to protect the ADCs, and switched mode power supplies
- if  not on board allready an SPI connector
- CS  pins for the stepper drivers
- either PT100 addon or on board

no 2 and 3 is for Trinamic Drivers. if its to much trouble we just need to make sure that there are SPI pins there. it could be the SPI connector in the middle that connects to the DUE. We simply just use a stacking header so that we have a socket on the back side and pins on the top side

rafaljot, 2018-06-01:
I wonder if CFG1-3 jumpers are still needed.

boelle, 2018-06-01:
we could make them an optional, ie. we dont solder them but we leave the holes in the board

so if end user want to use old steppers they can do that

but i should have a BOM ready by the end of day... or at least a partial one so we can start to fill in the important thing like maker and model of parts

rafaljot, 2018-06-01:
but if you want to remove jumpers you need to add solderjumpers

boelle, 2018-06-01:
not in this case,

user just buy the jumpers and solder them on to the board

i guess what you mean with solderjumpers is that we change the holes to pads so user can make a bridge between pads with a blob of solder

but if we change holes to pads the user cant solder in normal jumpers

i think its best to just leave CFG1-3 as they are. and i think @bobc will say i'm correct when he gets back

boelle, 2018-06-01:
What component supplier woulld be the best?

Mouser? RS Components?

We need one that is world wide and that also sells to private individual. Both Mouser and RS Components do that

boelle, 2018-06-01:
Benefit with mouser is that we can create a shopping list and share that public so if some people want to solder themselfes we can just give them the board and the link...

bobc, 2018-06-01:
For the BOM, I think https://github.com/bobc/bobc_hardware/blob/master/RAMPS-FD/RAMPS-FD_BOM.ods would be a good start.
Resistor values are not critical, except those in the thermistor circuit. SMD resistors are mostly 1% anyway.
LEDs current is not important.
In theory, RAMPS-FD could run with 5V logic, so to be fully compliant EEPROM should be 3.3V-5V.

Generally, Digikey part numbers are quite universal.

boelle, 2018-06-01:
Thanks :-D

i did go with mouser and would say i'm 75% through if not more

think i will get the BOM done tonight and would be good to get as many as possible to look at it

bobc, 2018-06-01:
For the switching 12V power, I was thinking of a module like https://uk.rs-online.com/web/p/switching-regulators/1619073/. It's pin compatible with LM7812, and only requires a little more board space.

I have no problem building my own boards, but I couldn't build boards for other people. So I was looking at assembly houses for making prototypes or small runs for interested people. It turns out I did get a quote from Itead, $957 for 10 boards assembled. I would need to add shipping, import duties and VAT (20%) just to get them to me.

boelle, 2018-06-01:
i also thought of those modules, i saw a guy use them to replace the voltage reg's in an old C64, worked fine for him and not even an scope could tell much difference

that price is crazy, that is why i'm messing arround with a BOM to see where the price for parts will end, if to high it would impossible to get others interest...

dinner time here, will get the BOM done and then repost link for review. i might have picked stupid expensive parts or the wrong ones

Antscran, 2018-06-01:
@bobc just curious the price you were quoted was that just for the SMD components on 1 side of the PCB?  Figure costs could be reduced if any through hole components, headers etc were soldered on by the user.

For me buying it in a semi complete kit form like this would be an option, some SMD components would not be an issue but this is not for all.

bobc, 2018-06-01:
> that price is crazy

Not really, but of course "it depends". For small q's, an SMPS would probably cost me near £2, so actually a module like that is much simpler and smaller, unless I am making 1000 quantity. But then if I was in Shenzen, I could make it for maybe 50p and still sell on ebay for £1 incl shipping.

>  if to high it would impossible to get others interest...

That is #1 problem I face (and Smoothie, RepRapPro etc). I can make it good, or cheap , but not both. People always prefer cheap. In fact they will buy the cheap board from China then expect I give them free lifetime support because I designed it :) I've kinda moved to the position where if people want cheap, I don't care about them because I could only do that if I lived in Shenzen.

bobc, 2018-06-01:
>  just curious the price you were quoted was that just for the SMD components on 1 side of the PCB? Figure costs could be reduced if any through hole components, headers etc were soldered on by the user.

All components. Unfortunately there is an infinite range of users requests from part kit to built and tested. Horrible logistics. Kits would actually cost more because of the time to kit out parts.

Oh yeah, I forgot to add cost of testing to sale price :)

bobc, 2018-06-01:
So what type of Trinamic modules are people using? There are these on ebay https://www.ebay.co.uk/itm/TMC-2130-2100-2208-Stepstick-Stepper-Motor-Driver-Module-Heat-Sink-fr-3D-Printer/282760855753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, originally designed by Waterott I think.
It looks like it would be quite easy to support those with just a few extra resistors and still be compatible with classic Pololus.

bobc, 2018-06-01:
> Is it problem to make additional/optional pads for capacitors on opposite side?

It's not easy, because the routing of power tracks is quite cramped.

A possibility is to increase board size, that would generally give more room and improve the layout.

bobc, 2018-06-01:
I've modified the stepper circuit to allow for Trinamic modules, it adds 2 resistors

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

However, to make it work, I also need to add 3 jumpers to optionally connect SPI bus to all the modules, or add 3 resistors to each stepper module. Otherwise, adding a microstep jumper will stop the SPI working...

boelle, 2018-06-01:
> So what type of Trinamic modules are people using
I think its mostly 2130 and 2208, the latter can handle more current and have a new version of stealthchop

boelle, 2018-06-01:
> However, to make it work, I also need to add 3 jumpers to optionally connect SPI bus to all the modules,

and each modules also would need a CS line, it would require a person that is good at routing tracks :-)

boelle, 2018-06-01:
>  In fact they will buy the cheap board from China then expect I give them free lifetime support because I designed it

hmm.... that is not fair. as i understand it you and the people working on it at the time did put a very clear warning that is was not ready yet.

boelle, 2018-06-01:
Made it to the end of the BOM and have used the one you linked to where i was in doubt

Q's:

- is C4 the same as C3? i assume yes but assumptions can sometimes be fatal :-D
- U4 the 5V regulator is now mentioned anywhere, how many amps should it supply?
- L1 is not mentioned anywhere, from the kicad files i assume its an ferrite bead, will any that fits the footprint do the trick?
- C301 should be a c_elec_4x5.3 according to the BOM, but the board say 0603, voltage is not mentioned, should it be a 16v ?
- c1001 is not mentioned in the BOM but from the board i found that its a c_elec_4x5.3, should it also be a 16V?
- R211 is marked as NF, does the mean not fitted?
- C601 is a 0603 on the board, is that also a 16V?

boelle, 2018-06-01:
My version of the BOM with only parts from mouser and only just the numbers that is needed for one board comes out to 65€

The screw terminals is not included as they where only rated for 12A and the bed do 16A
Fuse holders are spec'ed at 15A so might just do the trick

boelle, 2018-06-01:
The BOM:

https://docs.google.com/spreadsheets/d/1RLnmdB46gqgr1EFkkU6c9ktHnhKonsIwyvMgGwauXlQ/edit?usp=sharing

hope it makes sense

will recheck to see if i screwed up on a footprint etc, what could be interesting is if we can get it cheaper and still only buy just what is needed for one board

bobc, 2018-06-01:
I got €328 for complete BOM quantity 10 at mouser(uk) ... there is a decent price break at x10 but that is quite a difference.

The EEPROM should be < €1, e.g. https://www.mouser.co.uk/ProductDetail/511-M24512-RMN6TP

OSHPark is shockingly expensive compared to Chinese sources. I usually get boards from Itead.

boelle, 2018-06-01:
hehe, i agree on oshpark, but they where the only i knew could take the kicad pcb file directly like they do with eagle files

Do you think we can get the parts much cheaper if only going for 1 board at a time? and just the usual crazy thought, how many boards do you think would be needed in a batch before it can compete with the  unsafe version allready on sale?

bobc, 2018-06-01:
> Do you think we can get the parts much cheaper if only going for 1 board at a time?

For things like pin strips/header I buy them in bulk off ebay then cut to size. That's ok for DIY, but not for volume manufacture. I also buy smaller connectors off ebay, the quality is good enough. For the main high current power connectors I get from RS, Digikey etc. For resistors,caps,LEDs etc I buy 50 or 100 but I use them in other projects.

There are basically two ways to reduce the unit cost; build a LOT of units or build it in China. At about x1000 the volume discount reduces the BOM cost to about 50%. Manufacturers like Geetech will be buying full reels from local market at wholesale prices, plus they have cheap labor costs. The company I worked for prices parts in x10,000 quantity, and they weren't really a high volume manufacturer. They get parts from distributors like Arrow or direct from manufacturer.
To get near to ebay/aliexpress RAMPS-FD prices is basically impossible if manufactured in small quantity, or in the West. I guess a company like Olimex could make it for about 2x ebay price.

bobc, 2018-06-01:
I changed the fuse holders to https://www.mouser.co.uk/ProductDetail/Keystone-Electronics/3568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, they are slightly cheaper than the Littelfuse.

boelle, 2018-06-01:
and most important they are better rated, i was a bit worried that the 12A was not enough for things like the bed

bobc, 2018-06-01:
I looked into the current ratings quite a lot. Current ratings are a little fuzzy. e.g. for the fuse holder it has 3 ratings, UL;20A, UR;15A, CSA:10A. They use different test scenarios and come up with different ratings. Those will have some margin built in. Current ratings are thermal ratings, if the component has free movement of air around it will have a higher effective rating than if packed next to others in a closed box.
The advantage of branded parts is that you can be sure the part really is made to that rating, so provided you stay within 20% or so it should be fine. OTOH, the chinese knockoffs will rate parts at 15A but they are only good for half that.
Note though that Molex etc do the same type of connector with different ratings (due to the type of plastic used). It is tempting to pick a cheaper version but it might have a lower rating.

For those type of connectors, 15A is around the max, to go higher would need a larger connector. 16A seems high for heat bed, thats nearly 200W. At that point it's a whole lot better to use 24V.

yyf2009, 2018-06-02:
@boelle  FD V2.1 about  $21/pcs

boelle, 2018-06-02:
@bobc about the amps, it was me that messed up a bit, the mk42 heat bed is only 12V but ~0.8 ohms so its ~180W, i just remembered it as more than that. Not sure if it would be ok to drive the same bed with 24V

strange enough orballoprinting.com also do a clone of the mk52 bed ( the one with magnetic steel sheets ) and that one should be a 24v one, but their picture say 12V, not sure why

well time for me to get my printer running... getting close to where i want things

final thought, would a V2.2 at arrund the 22 $ mark be more a competitor ? of course we would still need to retain control of the parts used etc

boelle, 2018-06-04:
@yyf2009 would it make sense for you to sell the V2.2 instead once the design is finalised? or do you have to many boards in stock

rafaljot, 2018-06-04:
Does it make sense to reconnect power source for heaters and join with the bed ?
It is easy tu buy 24V heat bed, 24V 30,40W cartridges. Good fans are 12V only, like Sunon Maglev MF50151VX-A99, Noctua NF-A4x20.

Using 24V Power Supply + Step-down 12V 2-2Amp I can make this configuration.
Or 24V bed and heaters, 12 step-down, 30+ step-up for motors. etc.

yyf2009, 2018-06-04:
@boelle    There are 10 pcb v2.2, I have not yet started to assemble, if you complete the design, I can produce, and sell them

boelle, 2018-06-04:
@yyf2009 please dont start to assemble them. @bobc have not finished the pcb design

yyf2009, 2018-06-04:
@boelle Do I need to wait for a new design file? , how long it will take?

boelle, 2018-06-04:
@yyf2009 i dont know how long it will take for @bobc to finish and release V2.2

if you look here: https://github.com/bobc/RAMPS-FD/tree/dev

it clearly says that nothing is ready for release yet, so the 10 boards you have is a waste

where did you get your v2.2 design files from?

yyf2009, 2018-06-04:
@boelle from bobc

boelle, 2018-06-04:
but @bobc has not relased the files yet

do you have a link to where you got them?

yyf2009, 2018-06-04:
https://github.com/bobc/RAMPS-FD/tree/dev/RAMPS-FD

boelle, 2018-06-04:
@yyf2009

you have not read this file: https://github.com/bobc/RAMPS-FD/blob/dev/README.md

bobc, 2018-06-04:
Sorry, I forgot to update the readme when I last worked on the dev version.

I don't have any plan to update 2.2 in the foreseeable future, so the current dev version is as good as any. Of course, now that people are building "2.2" even though it has not been released or even finished (deja vu), I would have to call the next iteration 2.3...

boelle, 2018-06-04:
@bobc i just told our friend from china that updates could happen at that just because the files are there it does not mean they are good for production

ie i wanted to prevent that we have a repeat of what a other well know china company did with the first unsafe version

bobc, 2018-06-06:
What do people think of https://reprap.org/wiki/RD3D/1.0 ?

boelle, 2018-06-06:
looking, it smells a bit like the source is your board

bobc, 2018-06-06:
It's based on RAMPS 1.4.2 which was done by German RepRap. It probably works out cheaper than RAMPS-FD.

boelle, 2018-06-06:
the thing i'm concerned about is if the board layout is done right when it comes to current etc. and that analog stuff is isolated from the digital so noise does not go from one side to the other

and then if the prober parts are used

bobc, 2018-06-06:
There is also https://github.com/dvjcodec/Due3Dom, which is the Polish board mentioned earlier, but it is not Open Source. But there might be some ideas there, the layout is much cleaner but the board is quite big...

tig33r, 2018-06-06:
There is also DUE3DOM mini and DUE3DOM LE. As far as I know all three boards has source on github.

bobc, 2018-06-06:
"Has source" is not the same as "Open Source"! It's only Open Source if it has an open source license, and CC-BY-NC is not Open Source.

I didn't find a DUE3DOM LE on github.

boelle, 2018-06-06:
@bobc what is your own stand on the RD3D board?

bobc, 2018-06-07:
RD3D has a few features more than RAMPS-FD, e.g. onboard SD and support for SPI steppers, otherwise it seems similar. The designer seems to have ignored RAMPS-FD, not sure why. The board was costed at $15/100 (Chinese production), but little activity for a while.

boelle, 2018-06-07:
hmm... i could live without the SD and SPI, but also i'm not scared soldering wires on the adapter for the display etc

but if you at some point add that to v2.2 or 2.3 i would go for that and assemble a board myself

with all the work and experience that have been put in to Ramps FD it would be a shame to throw it out  the window

boelle, 2018-06-11:
Just a thought that hit me last night...

i know there might be a price difference, but would the Teensy 3.6 be a better board than the due?

boelle, 2018-06-11:
have played a bit with the thought on the schematics... since Teensy is 3.3v only a few things can be removed.

I started out with the power schematic, does this look about right?

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

boelle, 2018-06-11:
I wonder for the VCC rail, what is the draw on that? the Teensy have 250 mA on its 3.3V output
if the draw is below that we could simply make the VCC rail use that

boelle, 2018-06-12:
@bobc would it be easy for you to adjust the design to fit on the Teensy? i have given it some more thought and i think it could be an great option.

Sadly i lack the skills to do this 100% on my own

bobc, 2018-06-12:
I wouldn't favour Teensy as they are not Open Source. Anyway, they don't really have enough pins.

boelle, 2018-06-12:
oh well.... the lack of pins makes the difference

do you have any work not pushed to github? i'm going to finish my hybercube next month and want to use Ramps FD and need to plan a bit ahead so i can order parts etc

boelle, 2018-06-14:
@bobc

did you make the changes to allow for tmc2130? if so are they pushed to github so we all can have a look?

i will spend the day going over the BOM i made up and start prep work to order parts. I will order enough parts for at least 3 boards so i have spares, but my plan is to make 2 boards so i can fit them on both my machines

bobc, 2018-06-16:
> do you have any work not pushed to github?

I started a change to make the aux connectors plug directly to an LCD panel instead of needing an adapter board, but I don't have time to finish it.

> did you make the changes to allow for tmc2130? if so are they pushed to github so we all can have a look?

I updated the schematic to add some jumpers and pull up resistors on SLEEP/RESET. I added the resistors to the pcb and routing the traces, but I did not place the jumpers, it would take a complete re-routing to fit them in, probably need to increase board size. I noticed a smarter way to do the jumpers from another project, but again I don't have time to do any of that.

It seems in some places TMC2130 are not regarded highly, I have never used them so couldn't give an opinion.

boelle, 2018-06-16:
The problem with 2130 is that they run more hot. And  they do require 24V to be silent. Some people dont know that they can feed them 24V by removing the Vmot pin and connect it to an 24V source

and then of course there is the lot of misinformation and china knockoff's that dont help it either.

If it was me i would go for the TMC2208 instead, it runs cooler and can handle more current, but it requires 2 serial lines. But maybe 2 serial lines are more easy to do than SPI.

So what you have pushed so far on https://github.com/bobc/RAMPS-FD/tree/dev/RAMPS-FD seems to be ok for me, i dont mind running a few "bodge" wires to make it work as it can be done quite nicely if i take my time

craftoscar, 2018-06-17:
@boelle
@bobc
so to this day is the branch of main (v2.1/V2.2?) or dev (v2.2/2.3?) are ready to use?
I would like to find a pre-build RAMPS-FD v2.1 form @yyf2009, but the shipping cost is too irrational.
so I'm trying to find other alternatives, it's good to see you guys are here thu.

boelle, 2018-06-17:
@craftoscar

no @bobc has not released v 2.2 as ready for production, not sure about v 2.1

craftoscar, 2018-06-17:
I am shure @yyf2009 had some v2.1 ver.B in his hand. and I welling to purchese it excpt for the shipping fees
I notice that a guy in [Poland](https://www.elektroda.pl/rtvforum/topic3455800.html#17184419) are selling? v2.2 PCBs

by pic it caps 6 MOS so that probbly had onbord 5V MOS intergated.
like @bobc mentioned in post years ago in his vision in Ver 2.3

by the soure in [https://github.com/bobc/RAMPS-FD/tree/dev/RAMPS-FD](https://github.com/bobc/RAMPS-FD/tree/dev/RAMPS-FD)
visit in June 18 here (GMT+8) in Taiwan

shows the mark on PCB is v2.3 now

For alternative I like to make one for myself thats a bit confusing

I need to know witch one are clear to go

if any one want to get together to mess produce the PCBs I would like to join!

the reson why took my here is that I just fried my MKS Gen L in test
My intention is
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
