bobc/bobc_hardware/Decapede/schematic-original.pdf

# Jump4

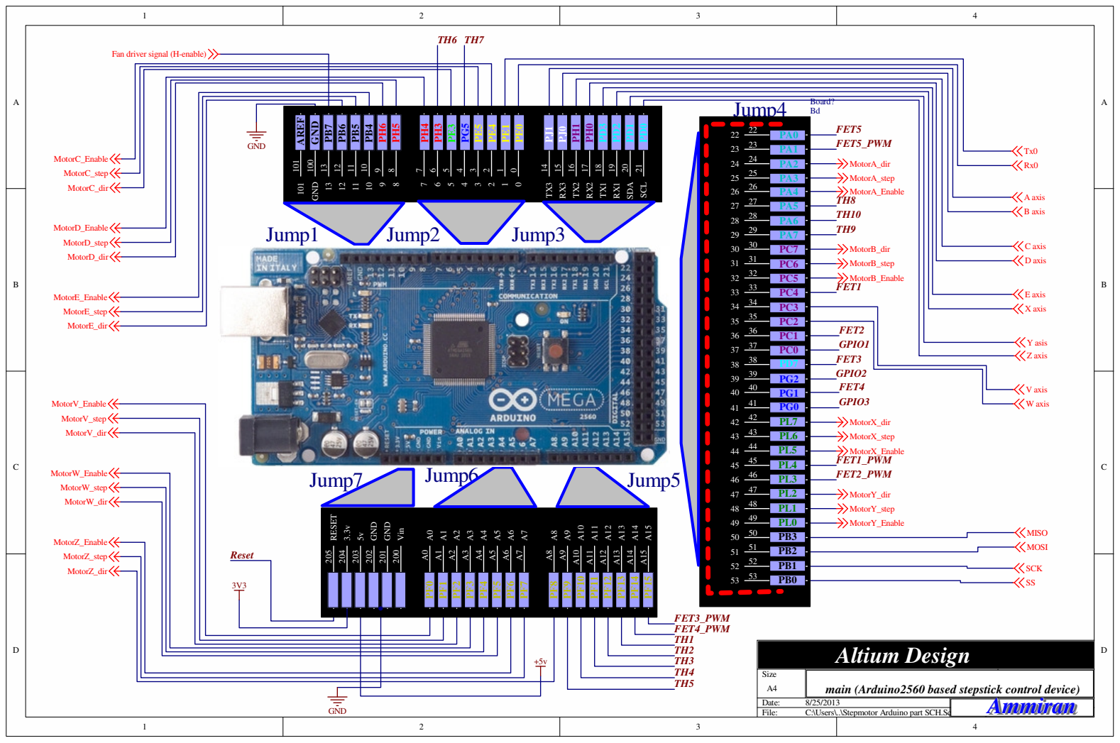
[picture p15: page 1]
Title; Size; Number; Revision; Date:; Sheet of; File:; C:\Users\..\Stepmotor Arduino part SCH.SchDoc Drawn By:; MotorA_Enable; MotorA_dir; MotorA_step; MotorB_Enable; MotorB_dir; MotorB_step; MotorC_Enable; MotorC_dir; MotorC_step; MotorD_Enable; MotorD_dir; MotorD_step; MotorE_Enable; MotorE_dir; MotorE_step; MotorX_Enable; MotorX_dir; MotorX_step; MotorY_Enable; MotorY_dir; MotorY_step; MotorV_Enable; MotorV_dir; MotorV_step; MotorW_Enable; MotorW_dir; MotorW_step; MotorZ_Enable; MotorZ_dir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

Fan driver signal (H-enable)

main (Arduino2560 based stepstick control device)

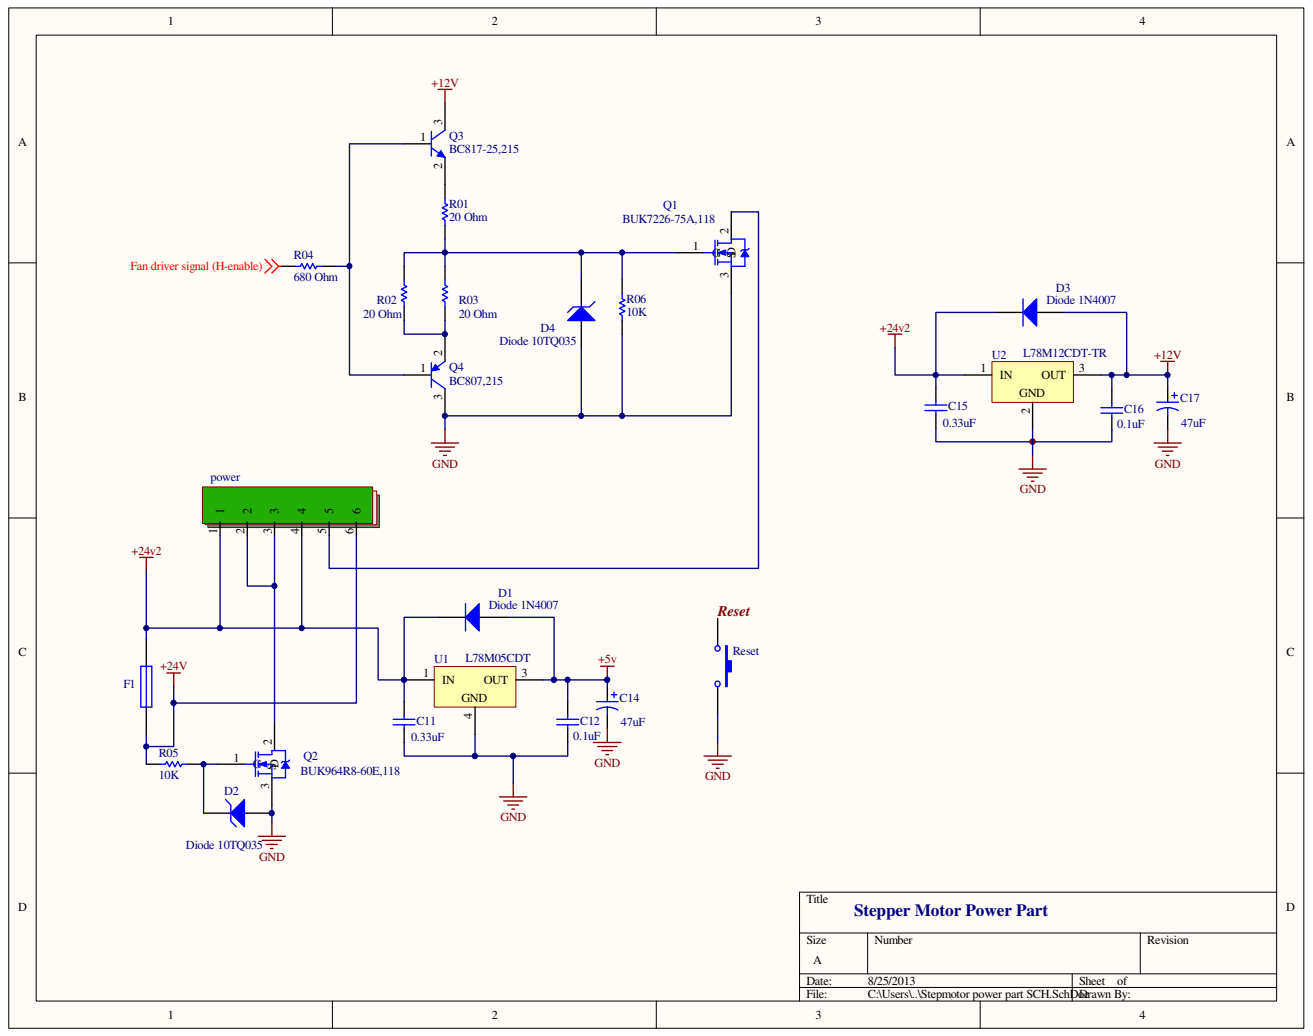
[picture p16: page 2]

Fan driver signal (H-enable)

Stepper Motor Power Part

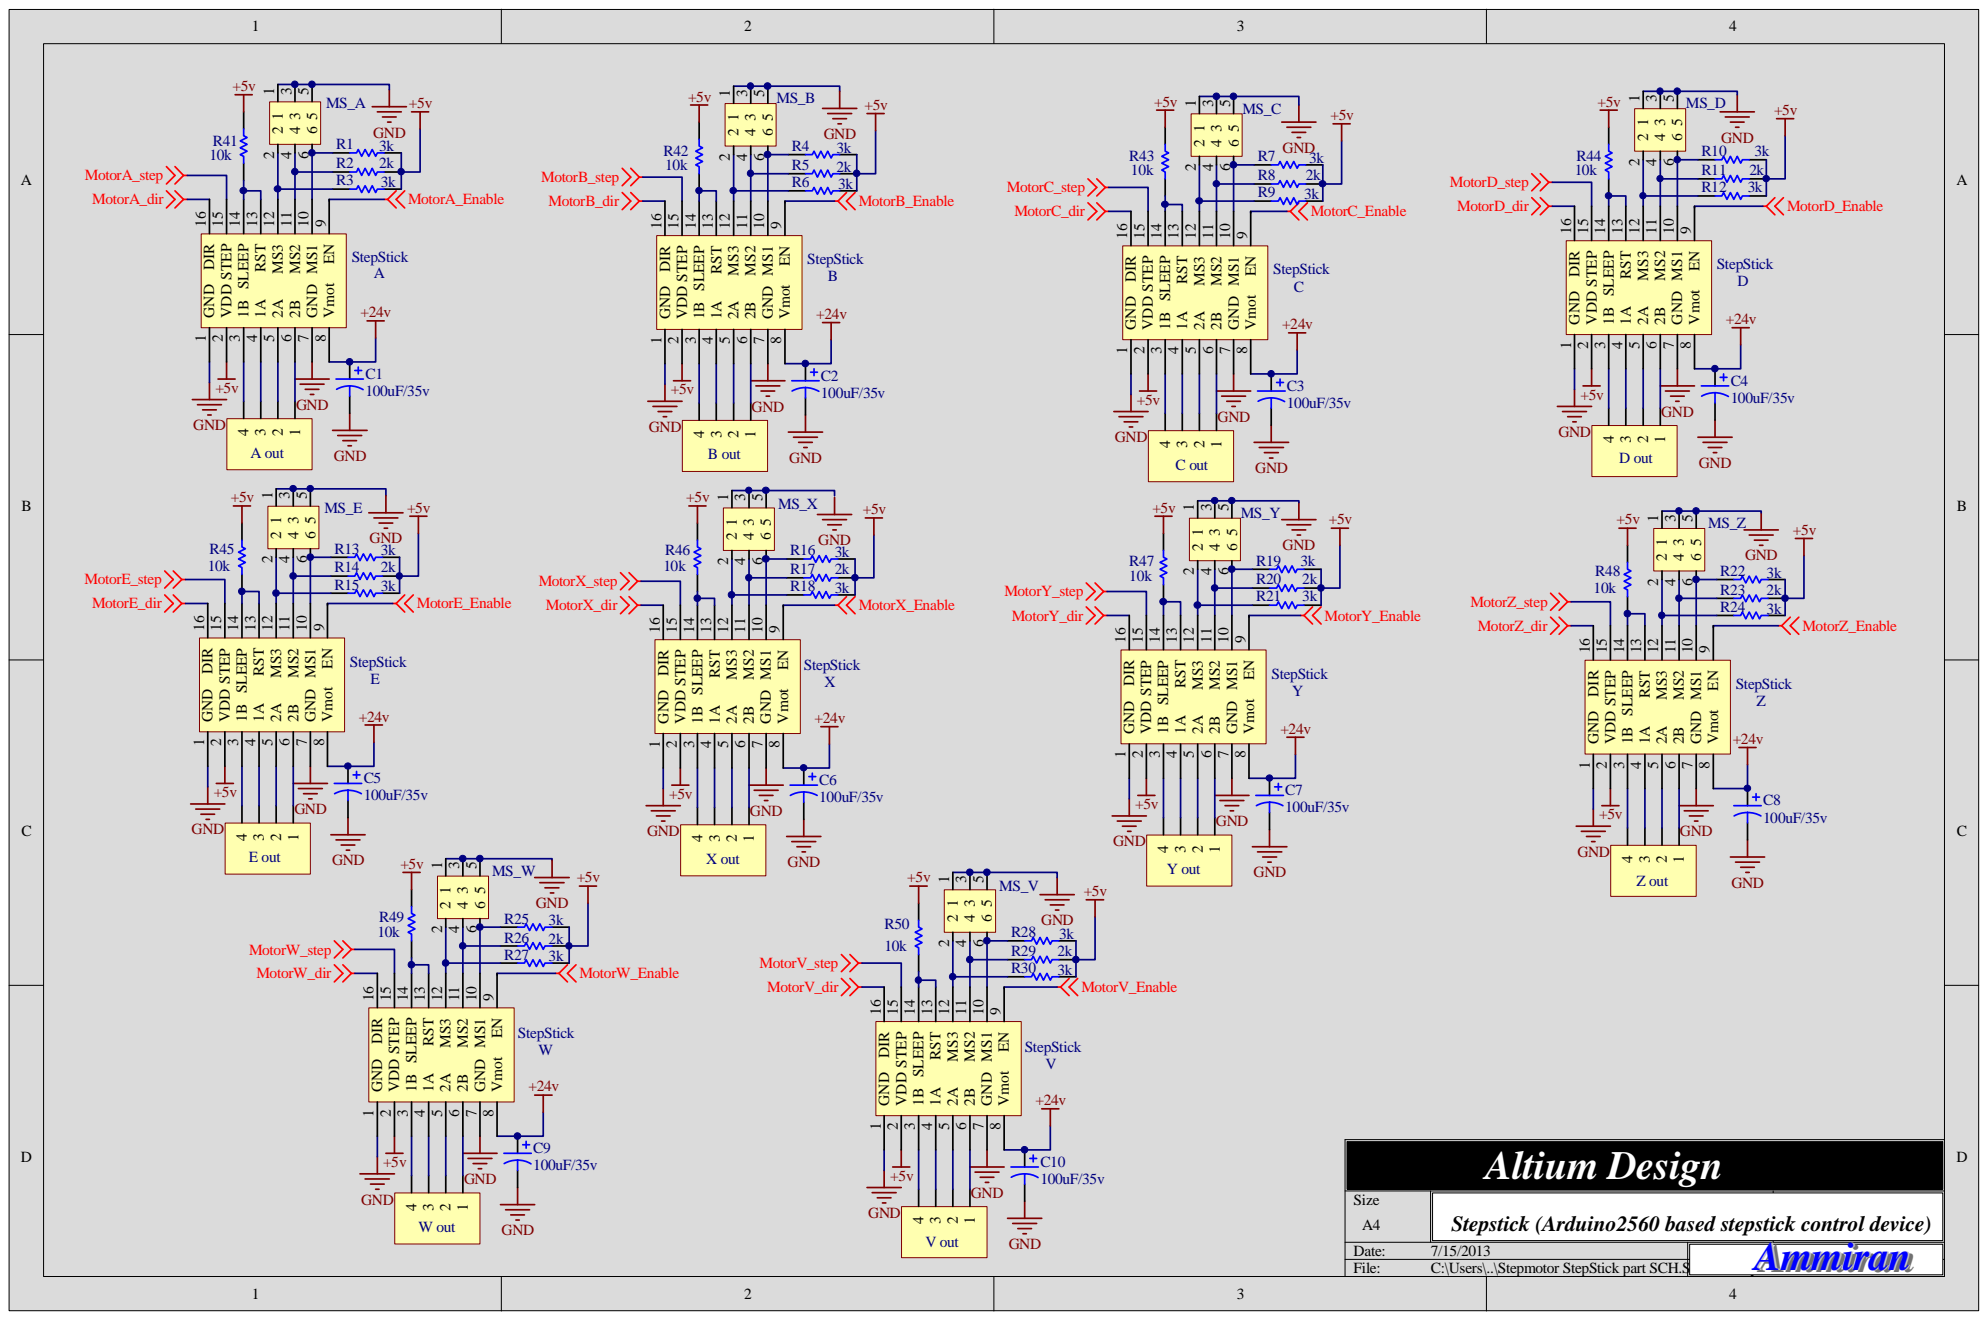
[picture p17: page 3]

Stepstick (Arduino2560 based stepstick control device)

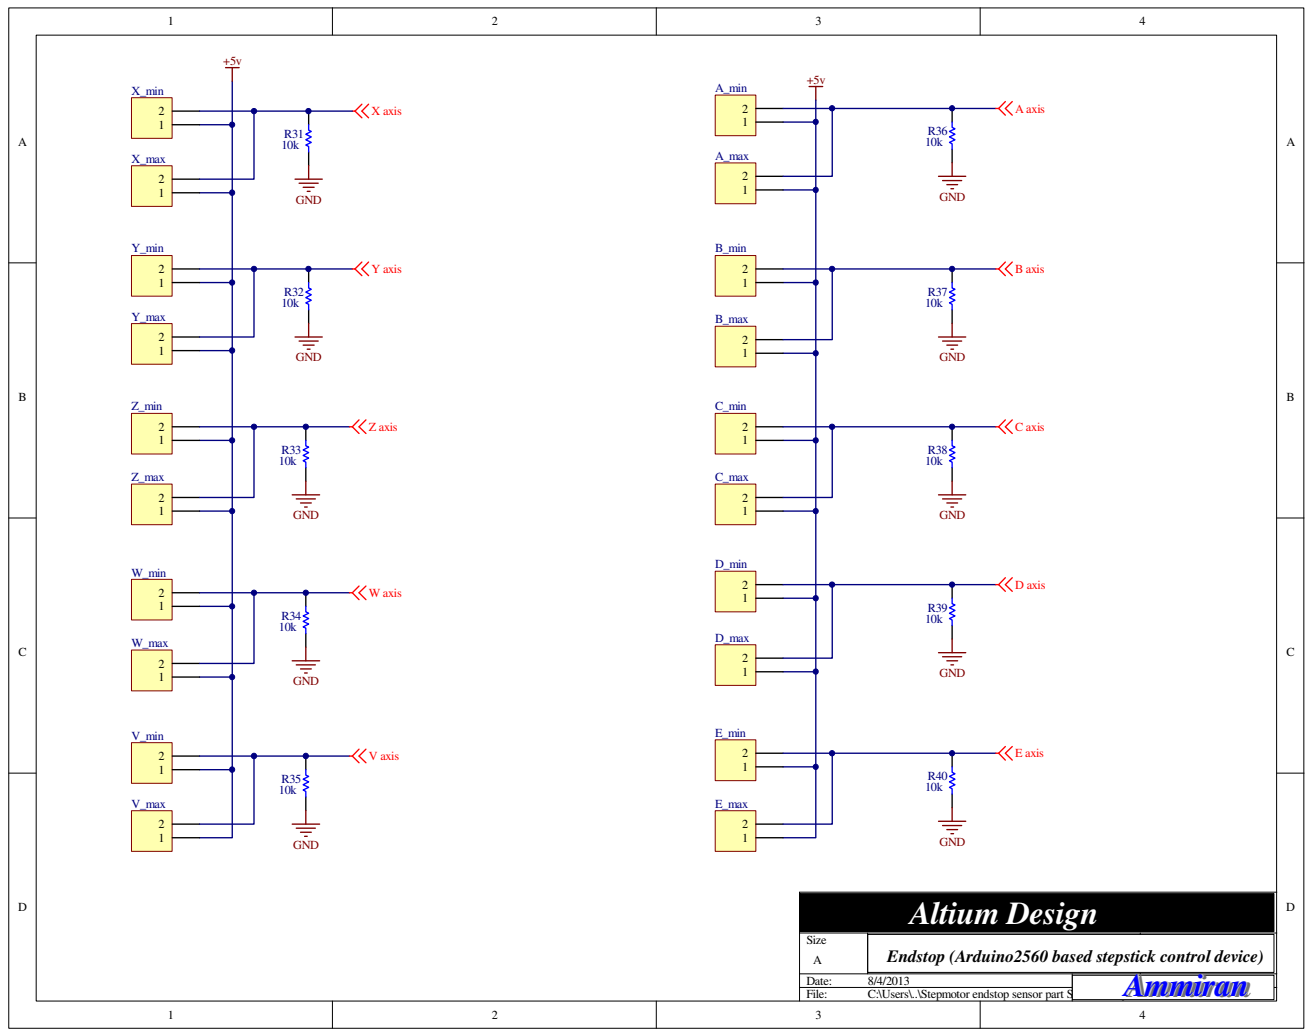
[picture p18: page 4]

Endstop (Arduino2560 based stepstick control device)

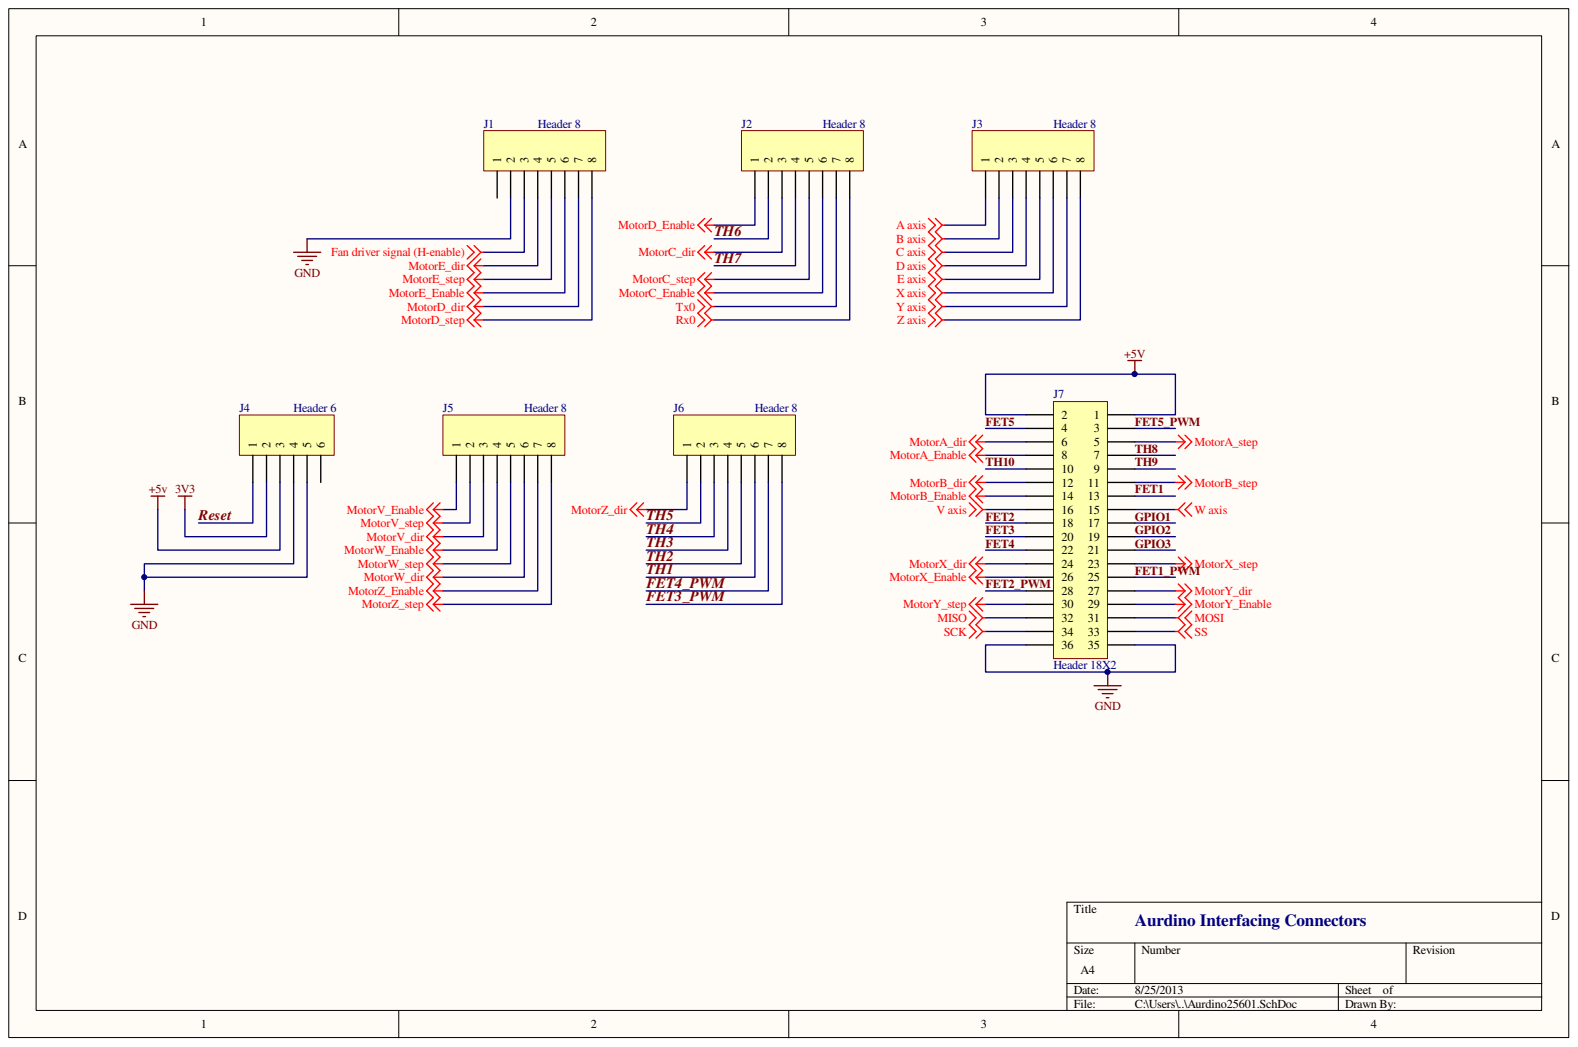
[picture p19: page 5]
Title; Size; Number; Revision; Date:; Sheet of; File:; C:\Users\..\Aurdino25601.SchDoc; Drawn By:; Header 8; MotorD_Enable; MotorD_dir MotorD_step; MotorE_Enable; MotorE_dir MotorE_step GND; MotorC_dir; MotorC_Enable; MotorC_step; B axis; D axis; X axis; Z axis; Y axis; E axis; C axis; A axis; Reset; GND; MotorV_Enable; MotorV_dir; MotorV_step; MotorW_Enable; MotorW_dir; MotorW_step; MotorZ_Enable; MotorZ_dir; MotorZ_step; FET3_PWM; FET4_PWM; MotorA_Enable; MotorA_dir; MotorA_step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

Fan driver signal (H-enable)

Aurdino Interfacing Connectors

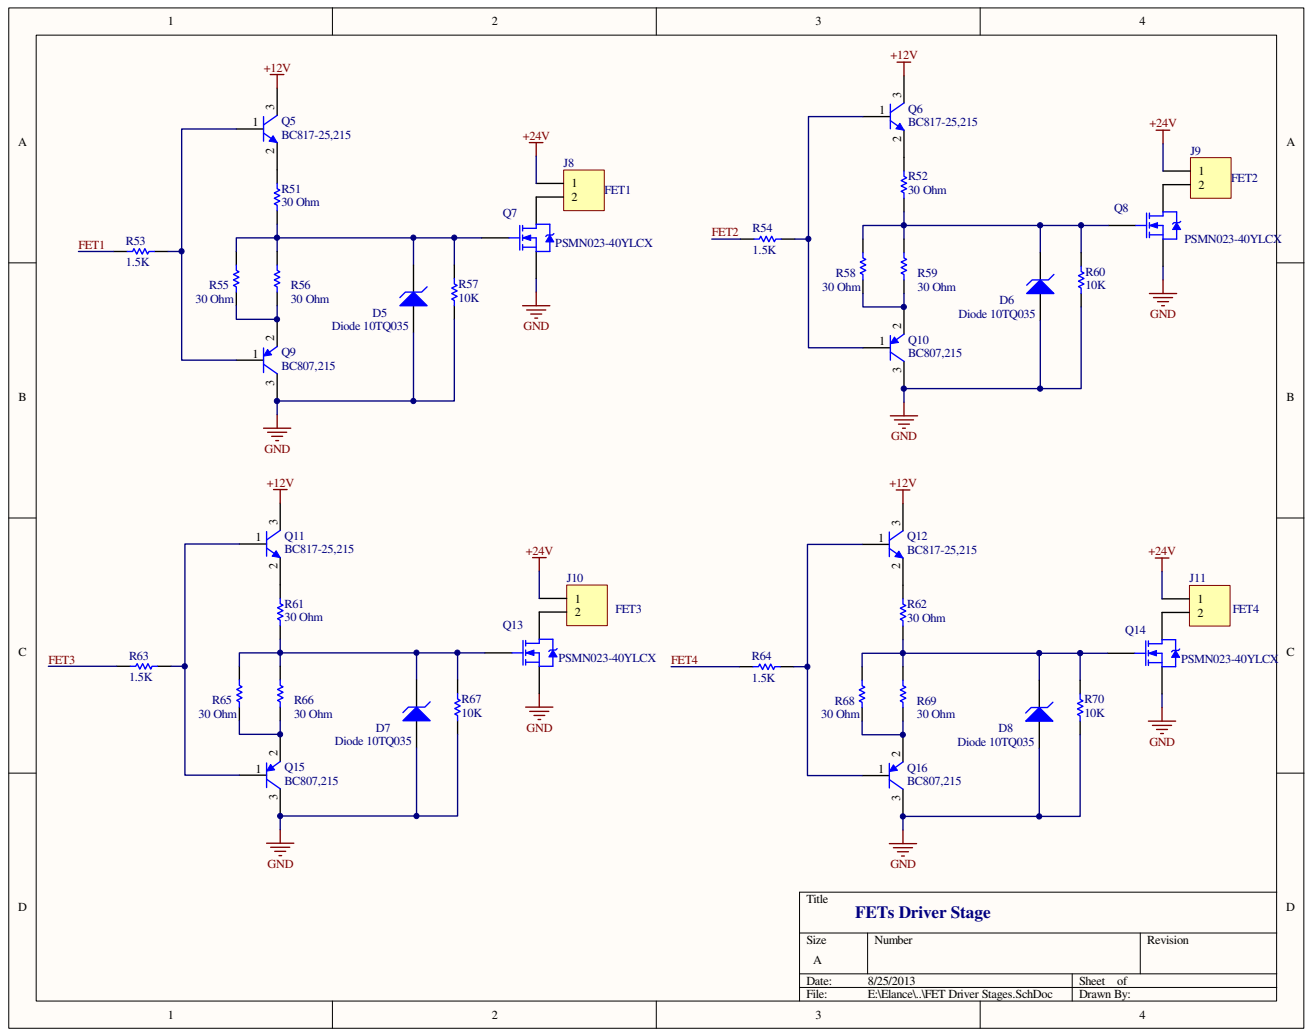
[picture p20: page 6]

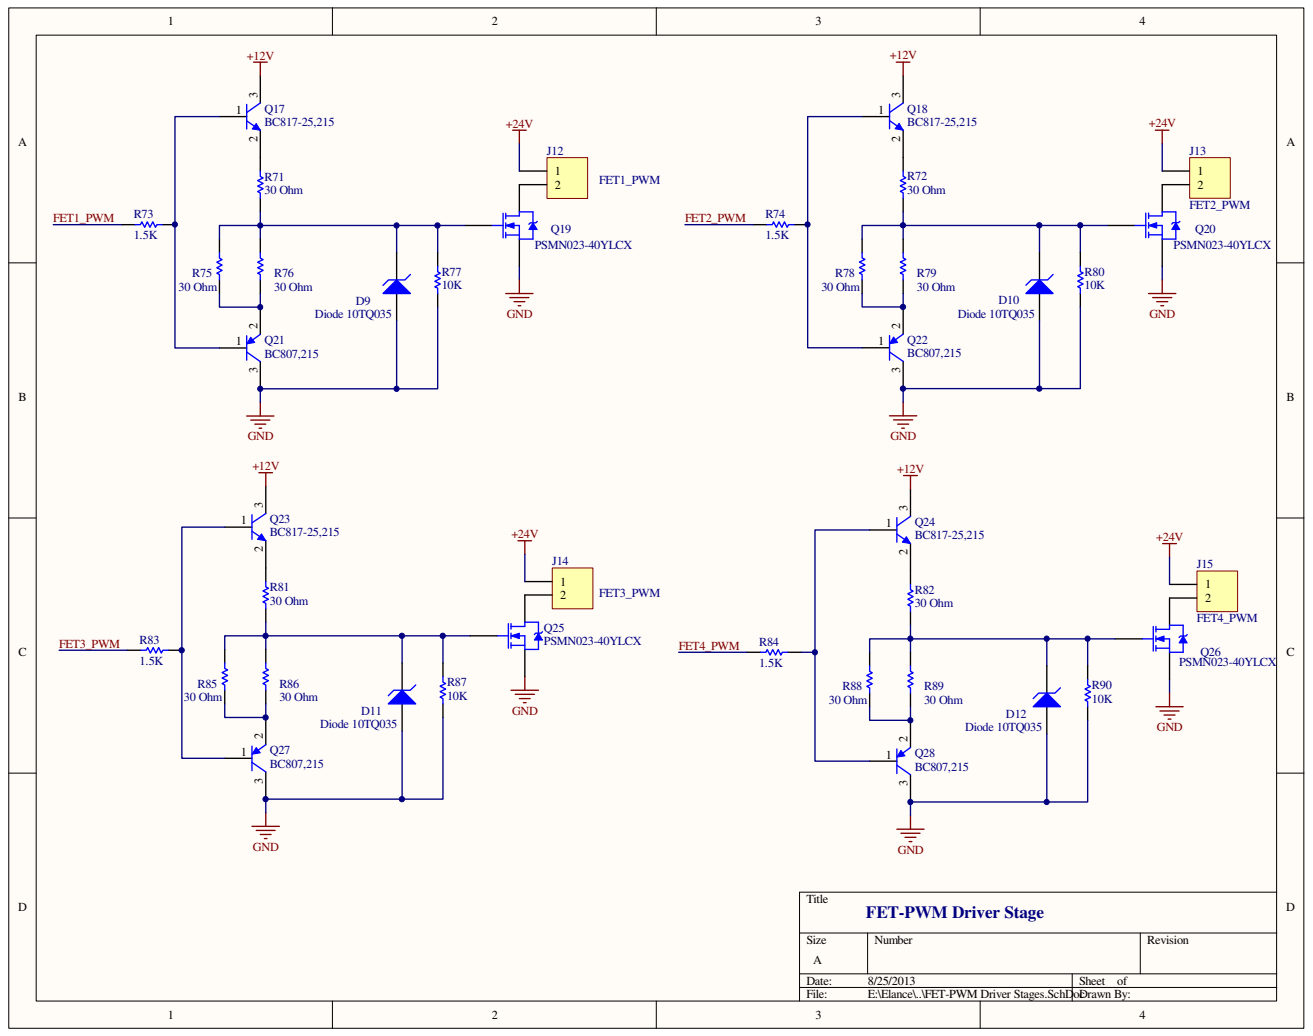
[picture p21: page 7]

FET-PWM Driver Stage

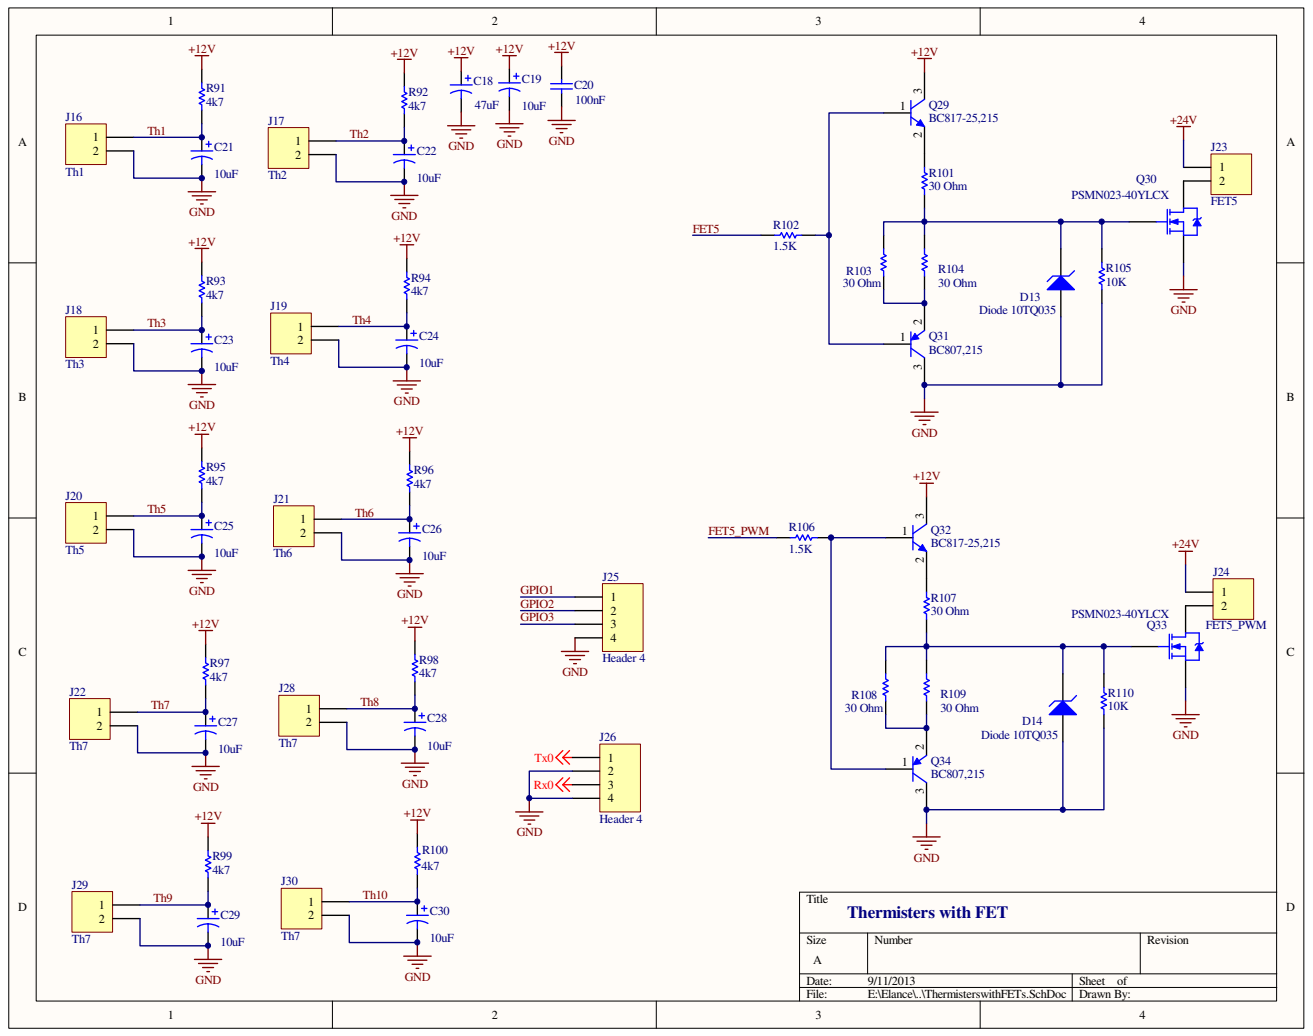
[picture p22: page 8]

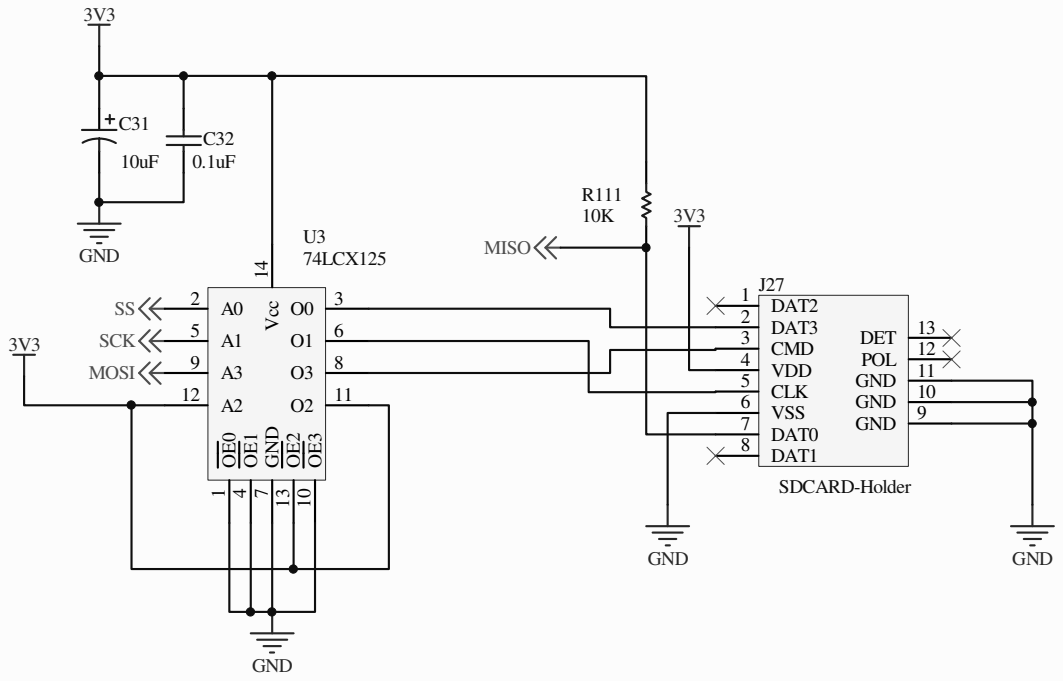
[picture p23: page 9]
Title; Size; Number; Revision; File:; E:\Elance\..\SDCard.SchDoc; Drawn By:; GND; MOSI; MISO; SCK; Vcc; U3 74LCX125; DAT2 1 DAT3 2 CMD 3 VDD 4 CLK 5 VSS 6 DAT0 7 DAT1 8; SDCARD-Holder

GND 9 GND 10 GND 11 POL 12 DET 13

SD CARD Interface
