bobc/bobc_hardware/MS-F1/Schematic.pdf

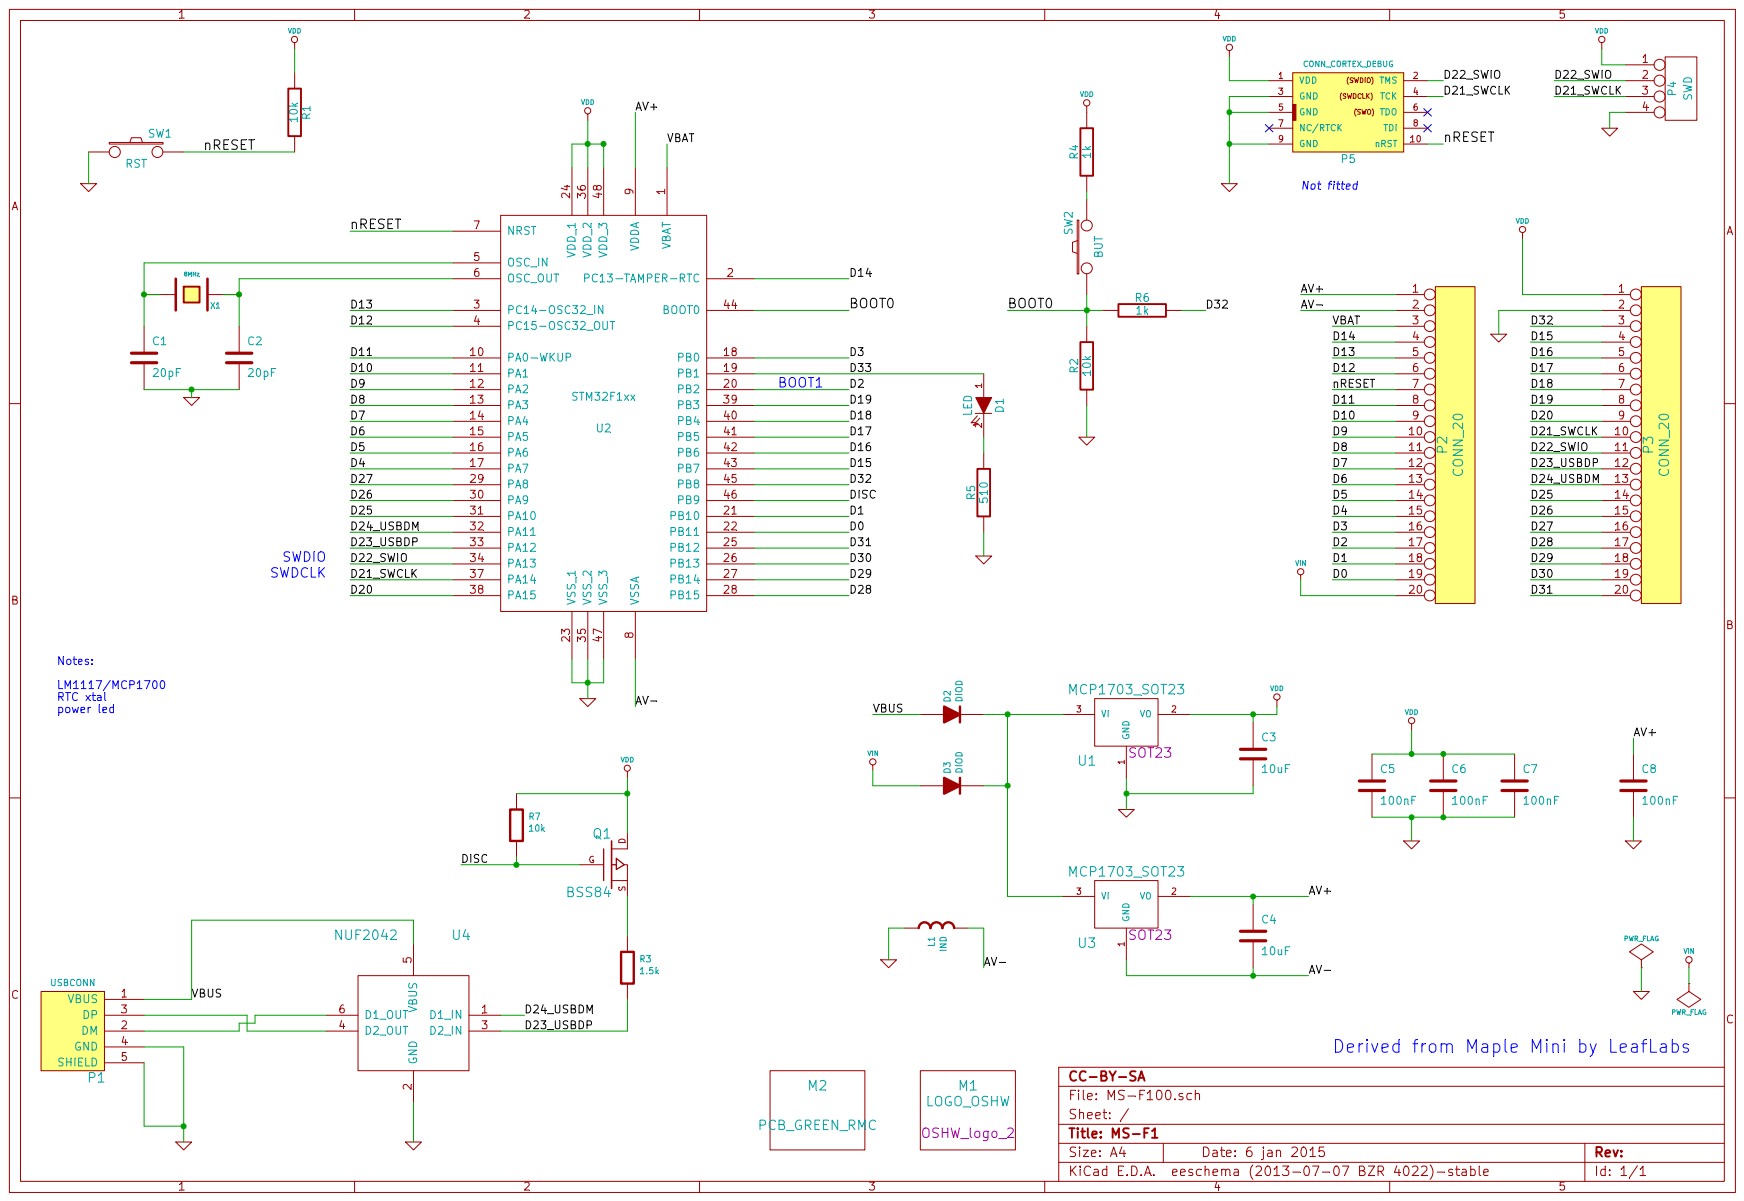
[picture p34: page 1]
