bobc/bobc_hardware/RAMPS-FD-EXT/EXT4-Schematic.pdf

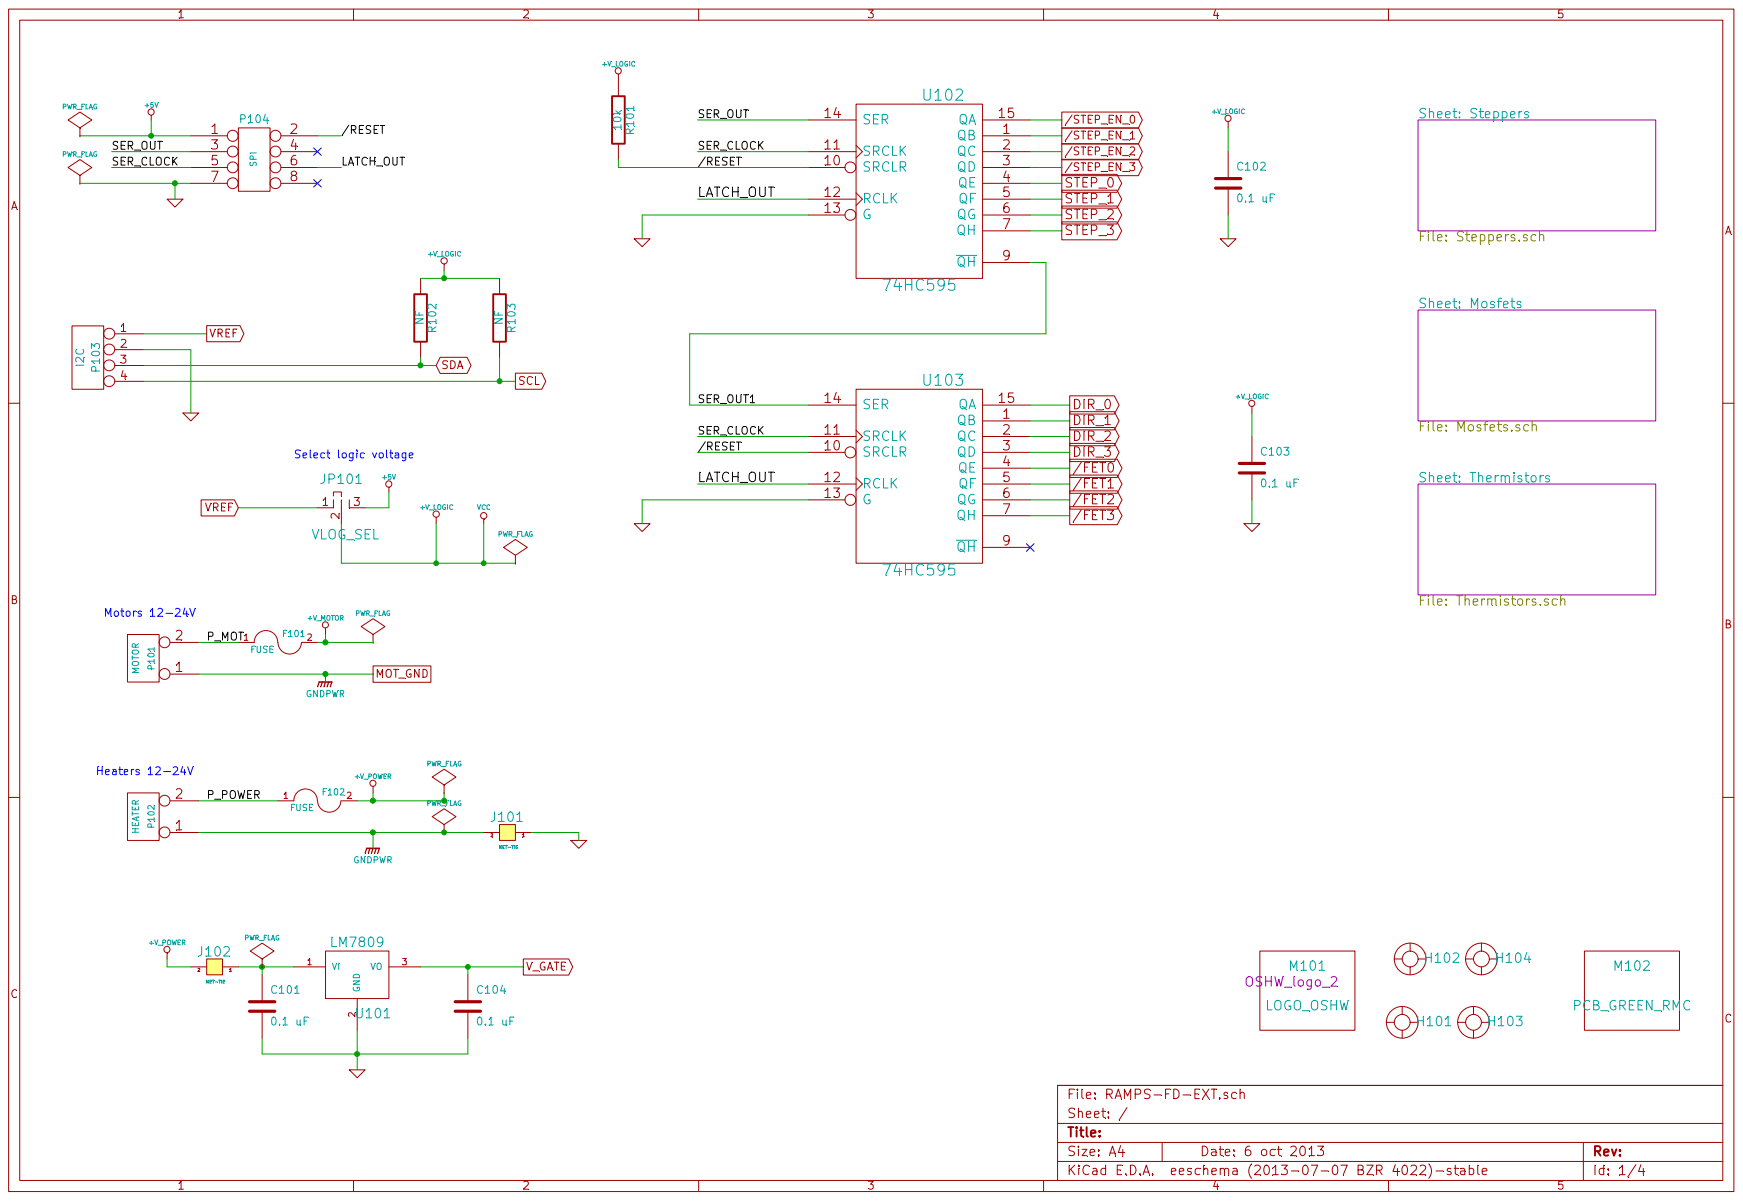
[picture p56: page 1]

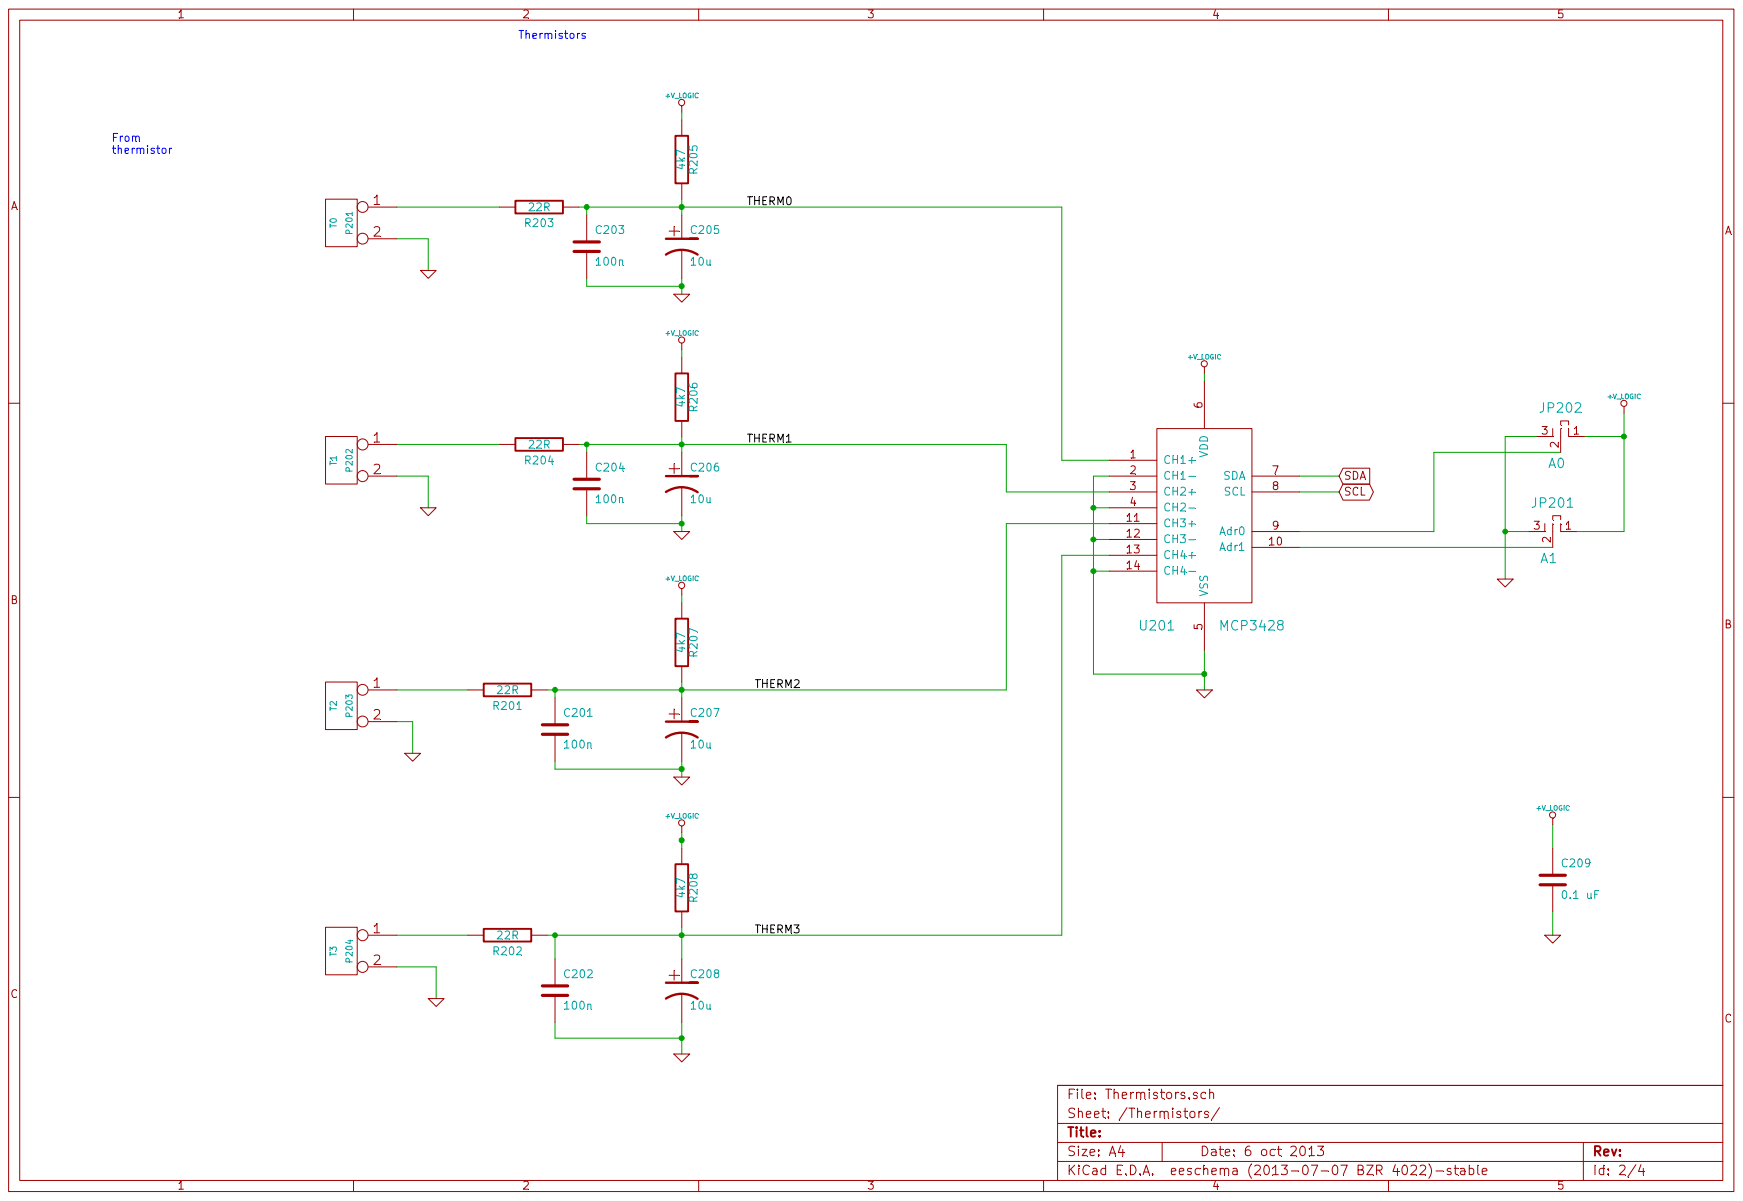
[picture p57: page 2]

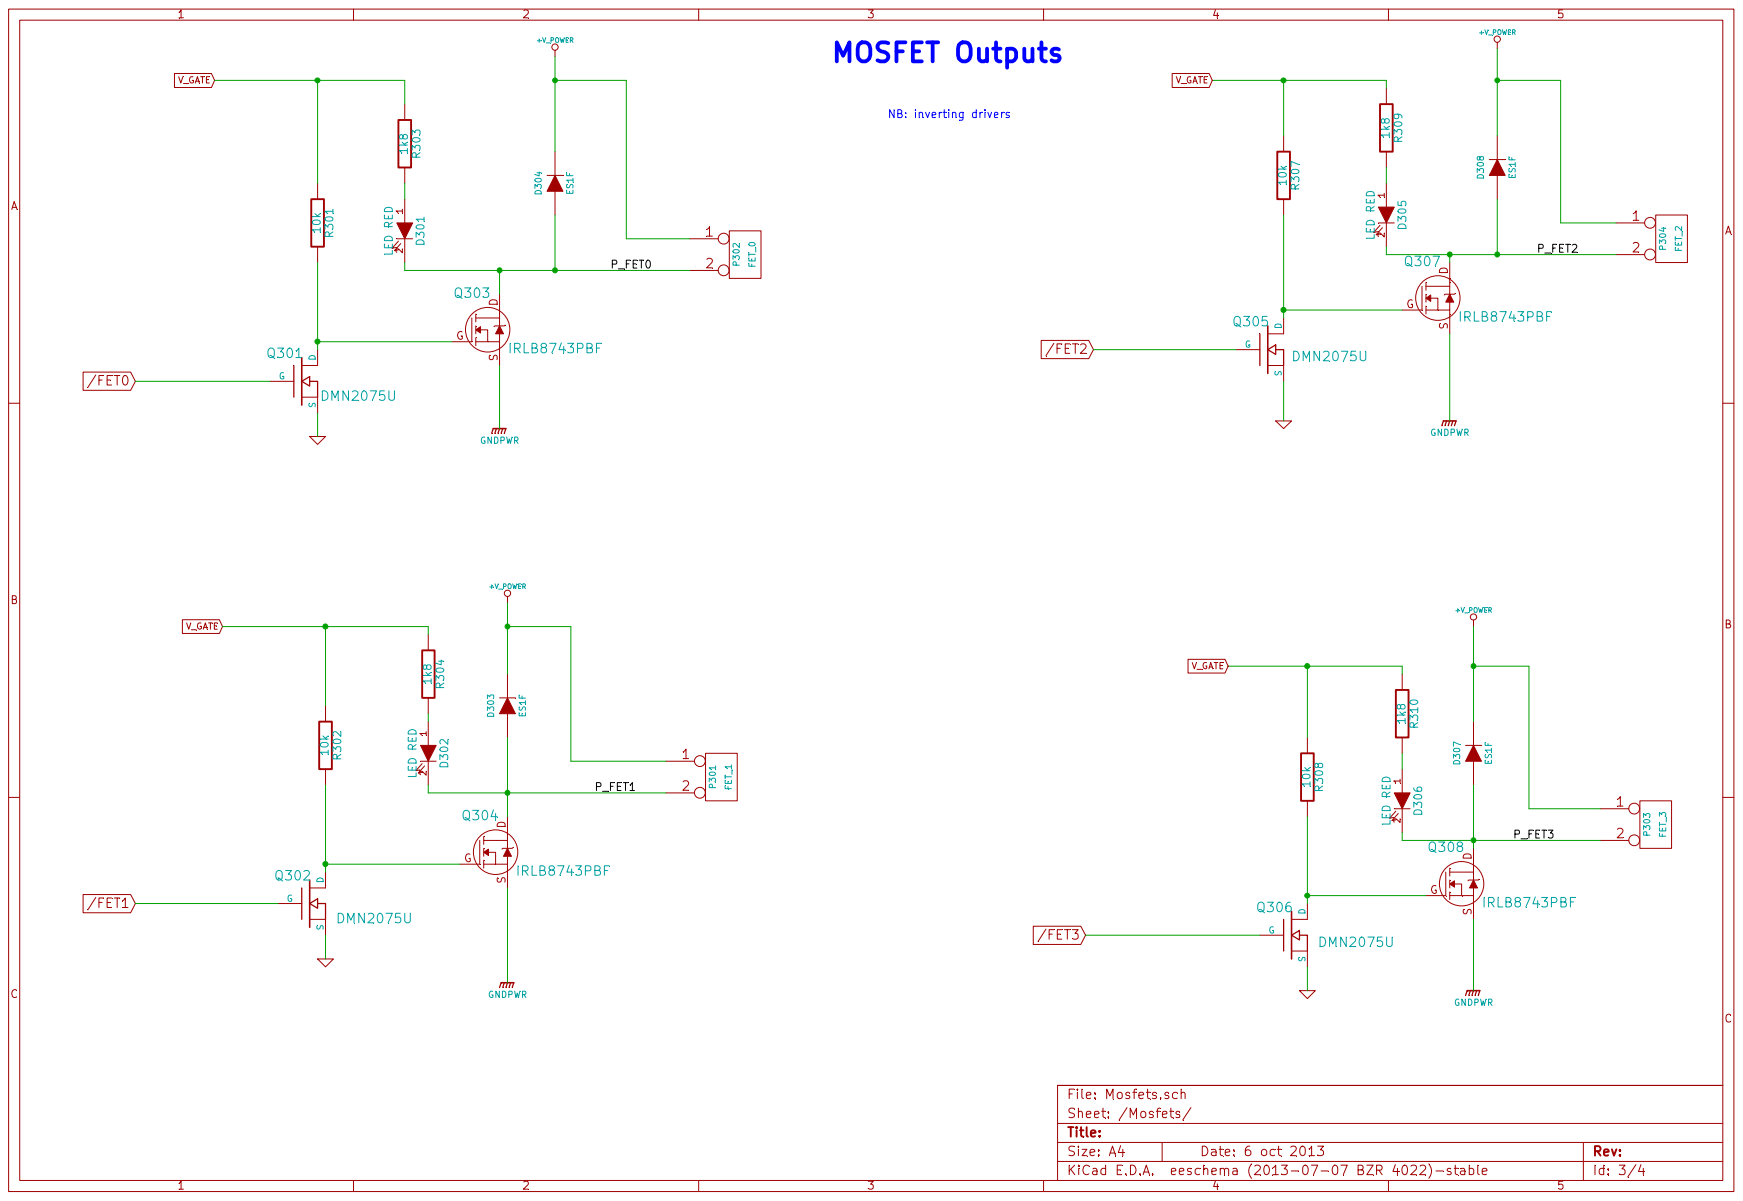
[picture p58: page 3]

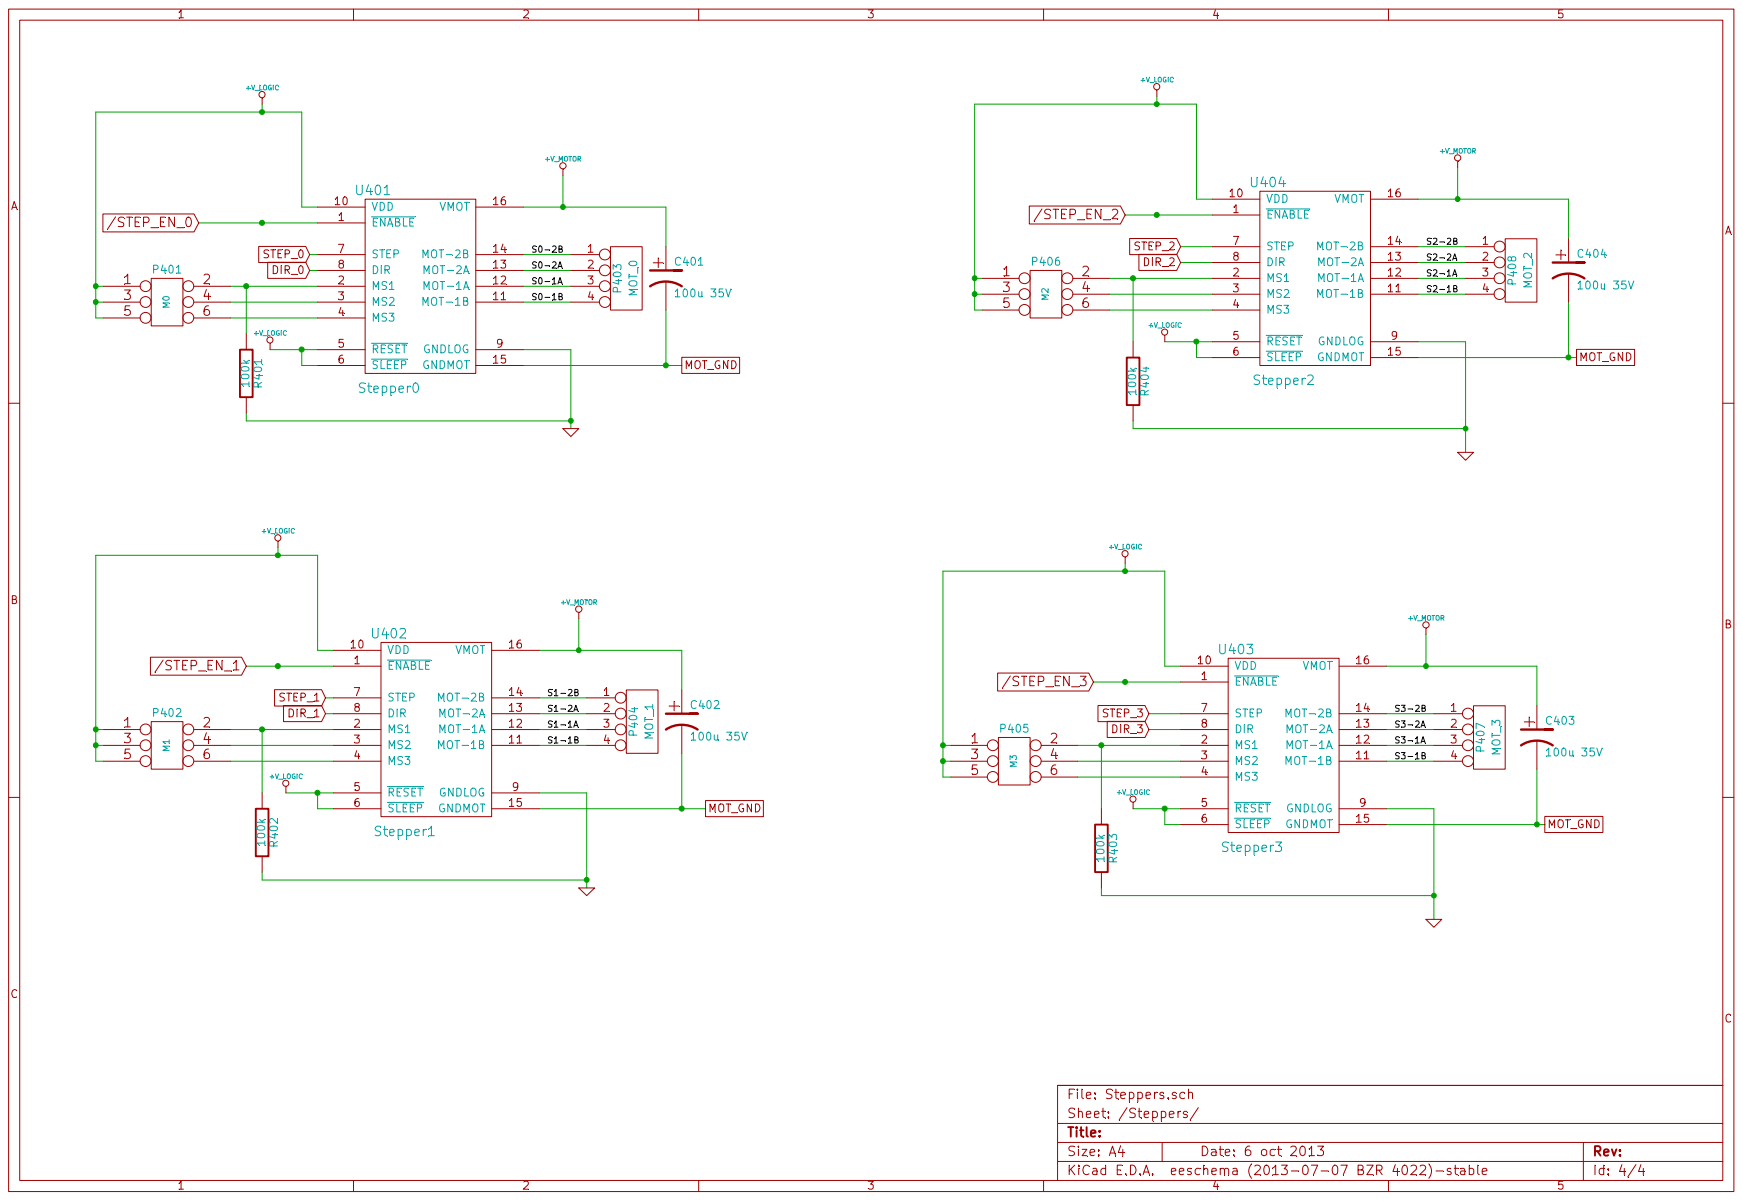
[picture p59: page 4]
