bobc/bobc_hardware/LCD-panel-adapter-FD/LCD-panel-adapter-FD-Schematic.pdf

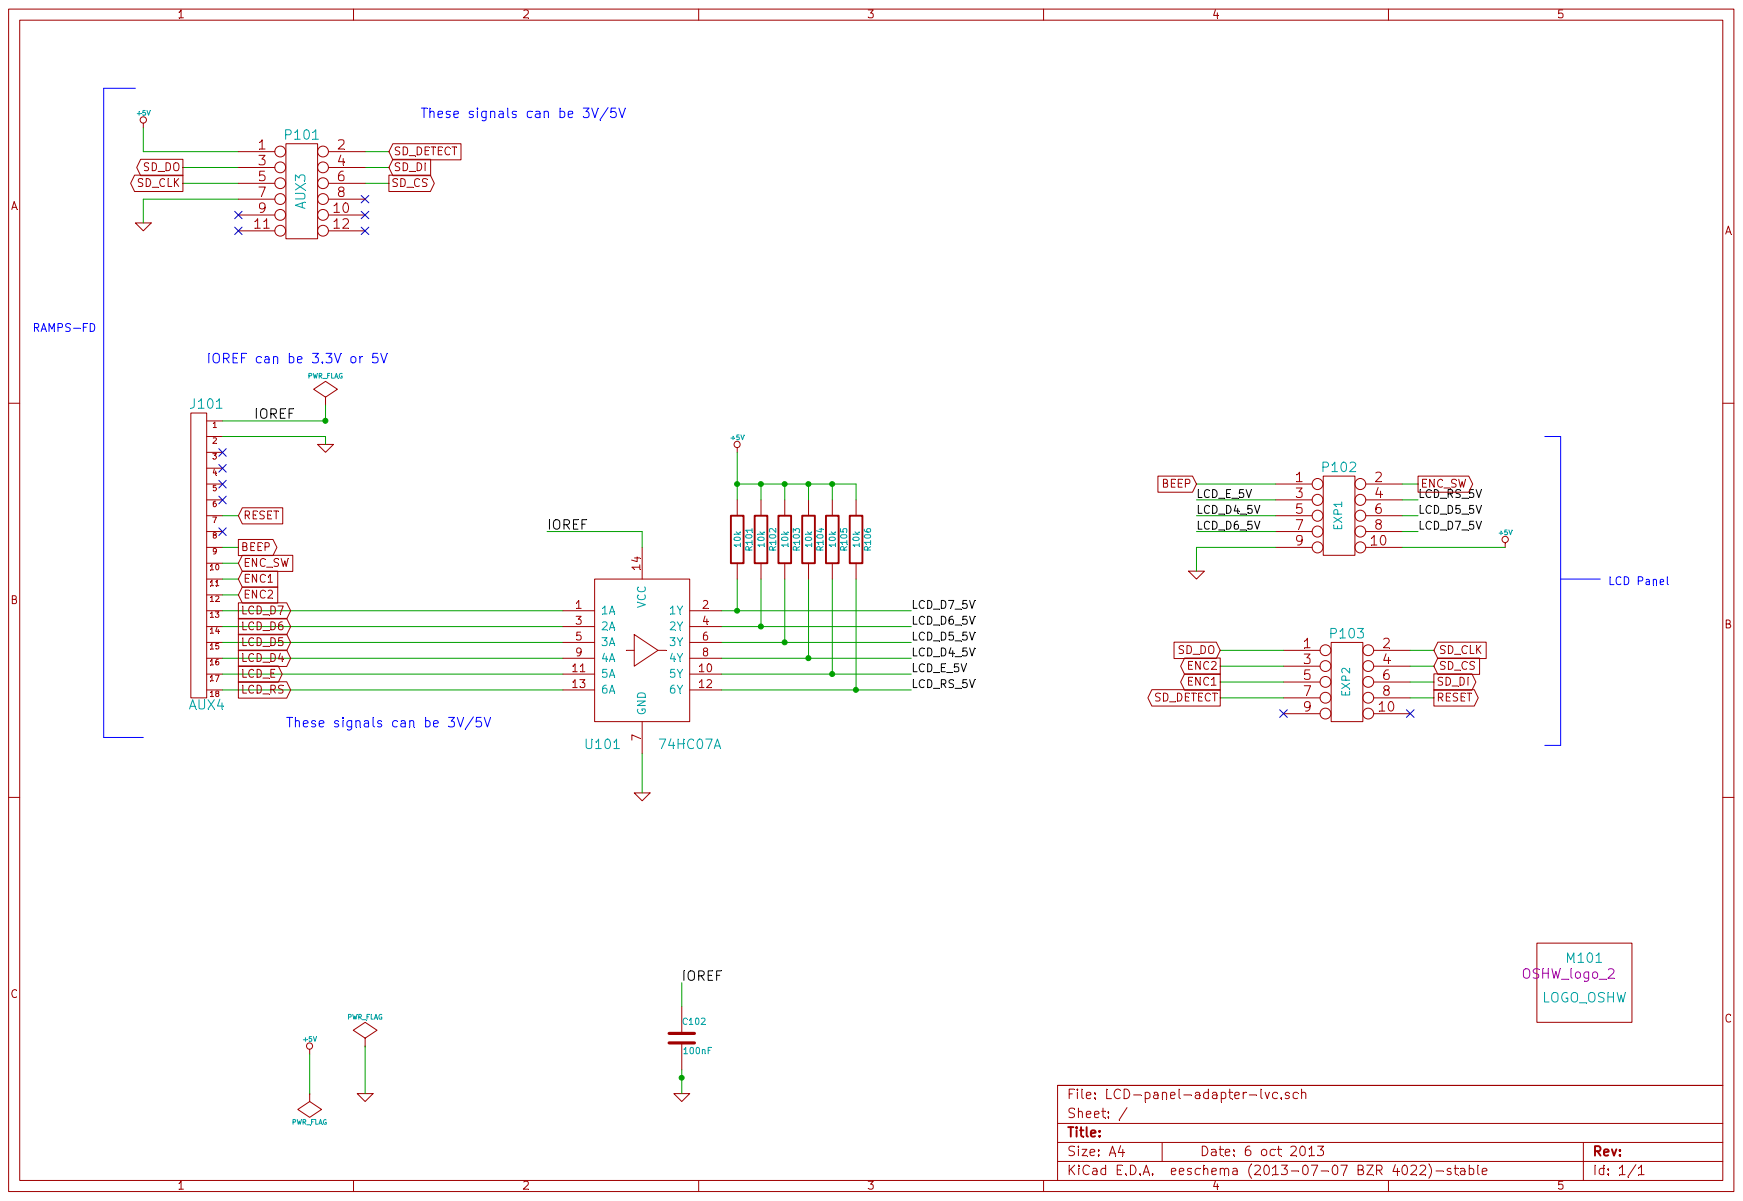
[picture p60: page 1]
