bobc/bobc_hardware/Due-RIB/RIB-Schematic.pdf

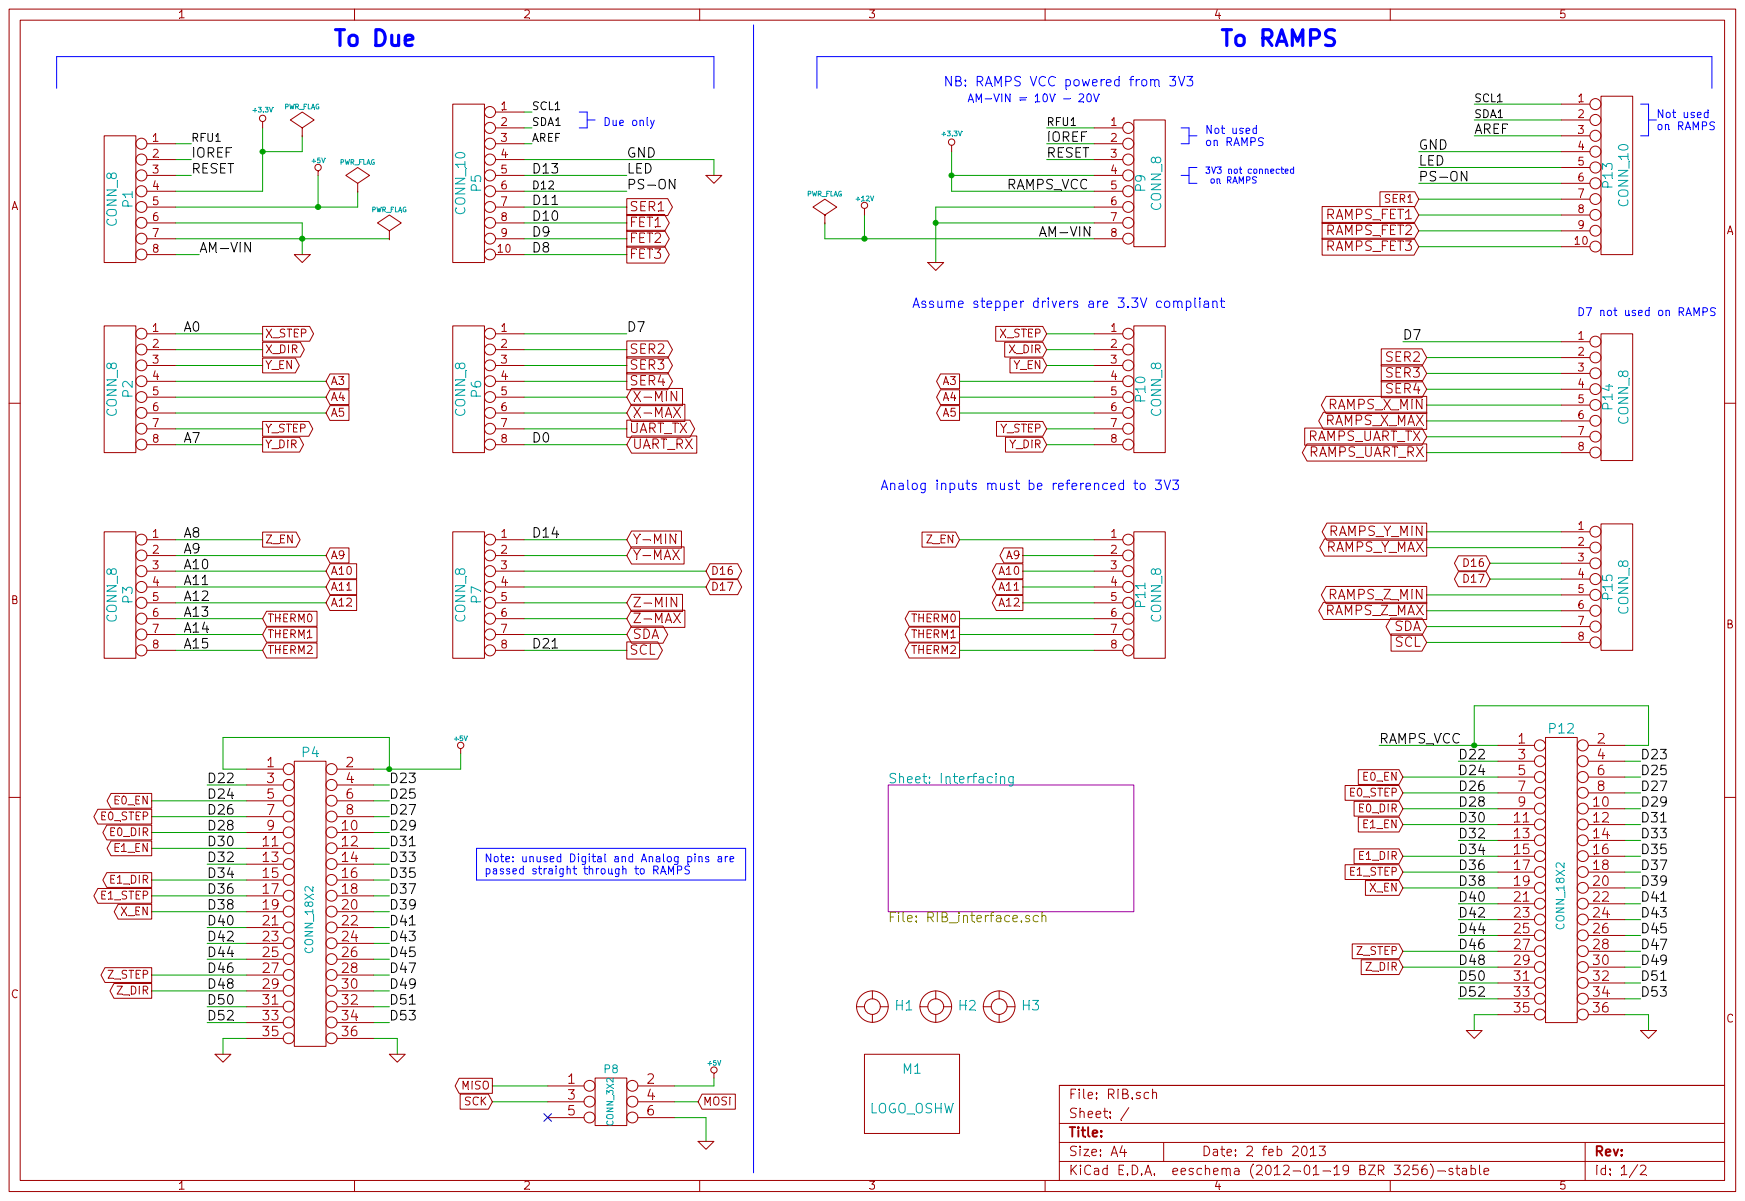
[picture p61: page 1]

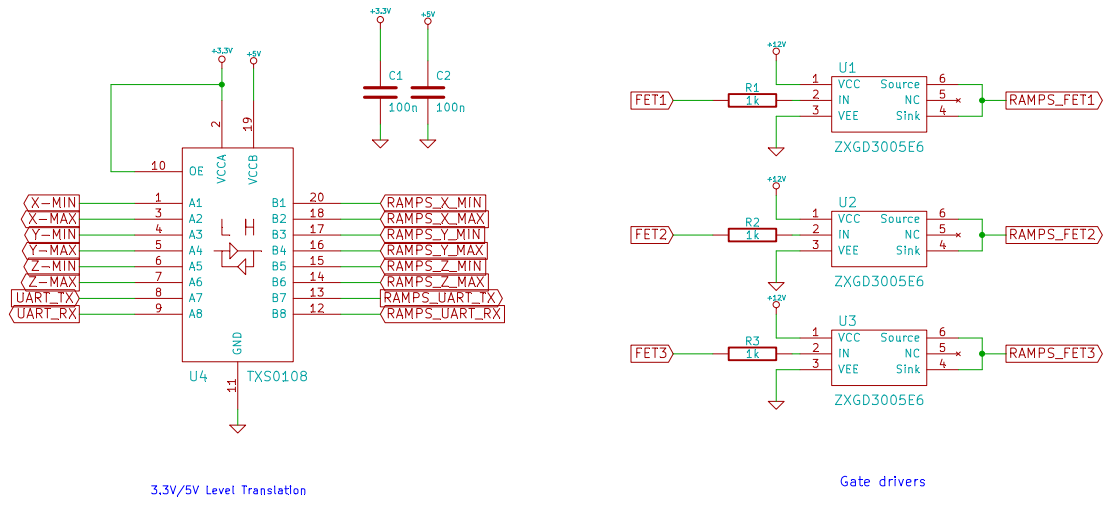
[picture p62: page 2]
