bobc/bobc_hardware/MicropendousX-1343/MicropendousX-1343 Schematic.pdf

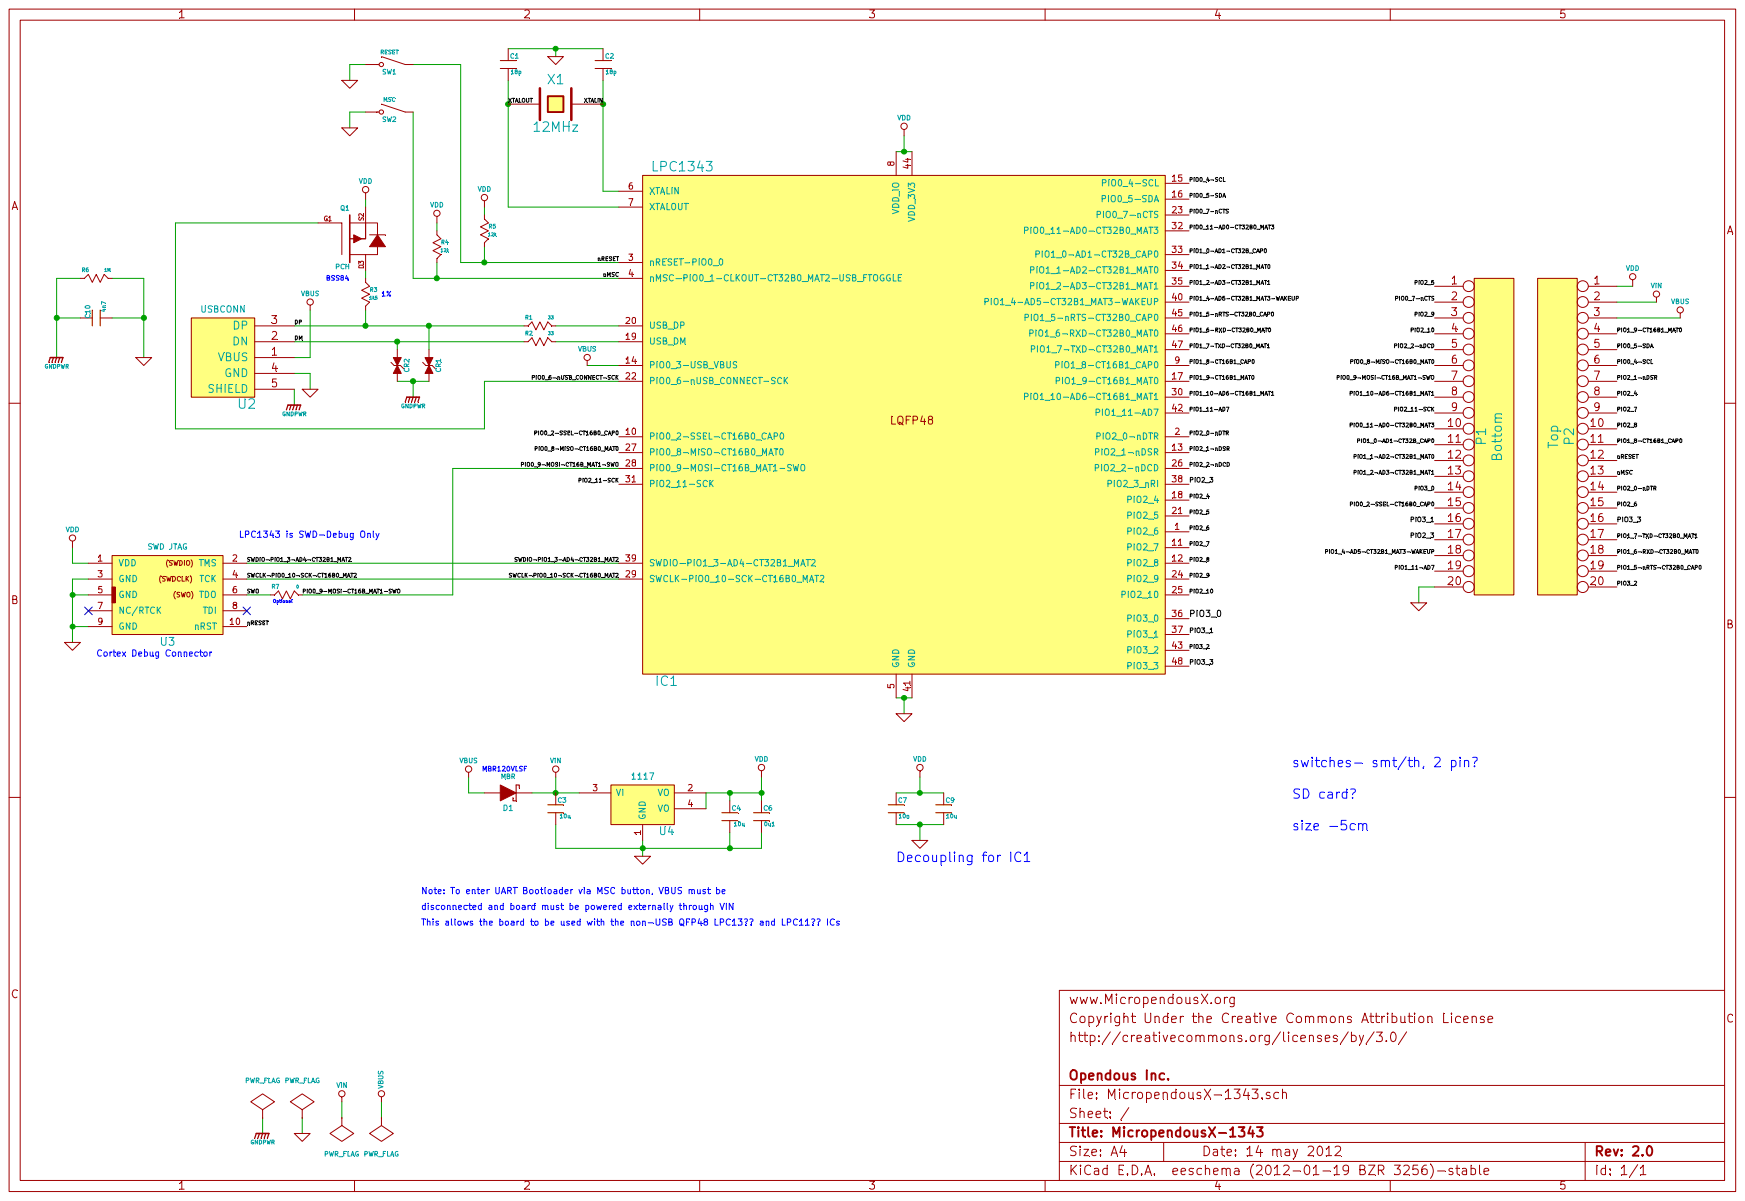
[picture p63: page 1]
