bobc/bobc_hardware/matrix_clock_cc_4digit/matrix_clock.pdf

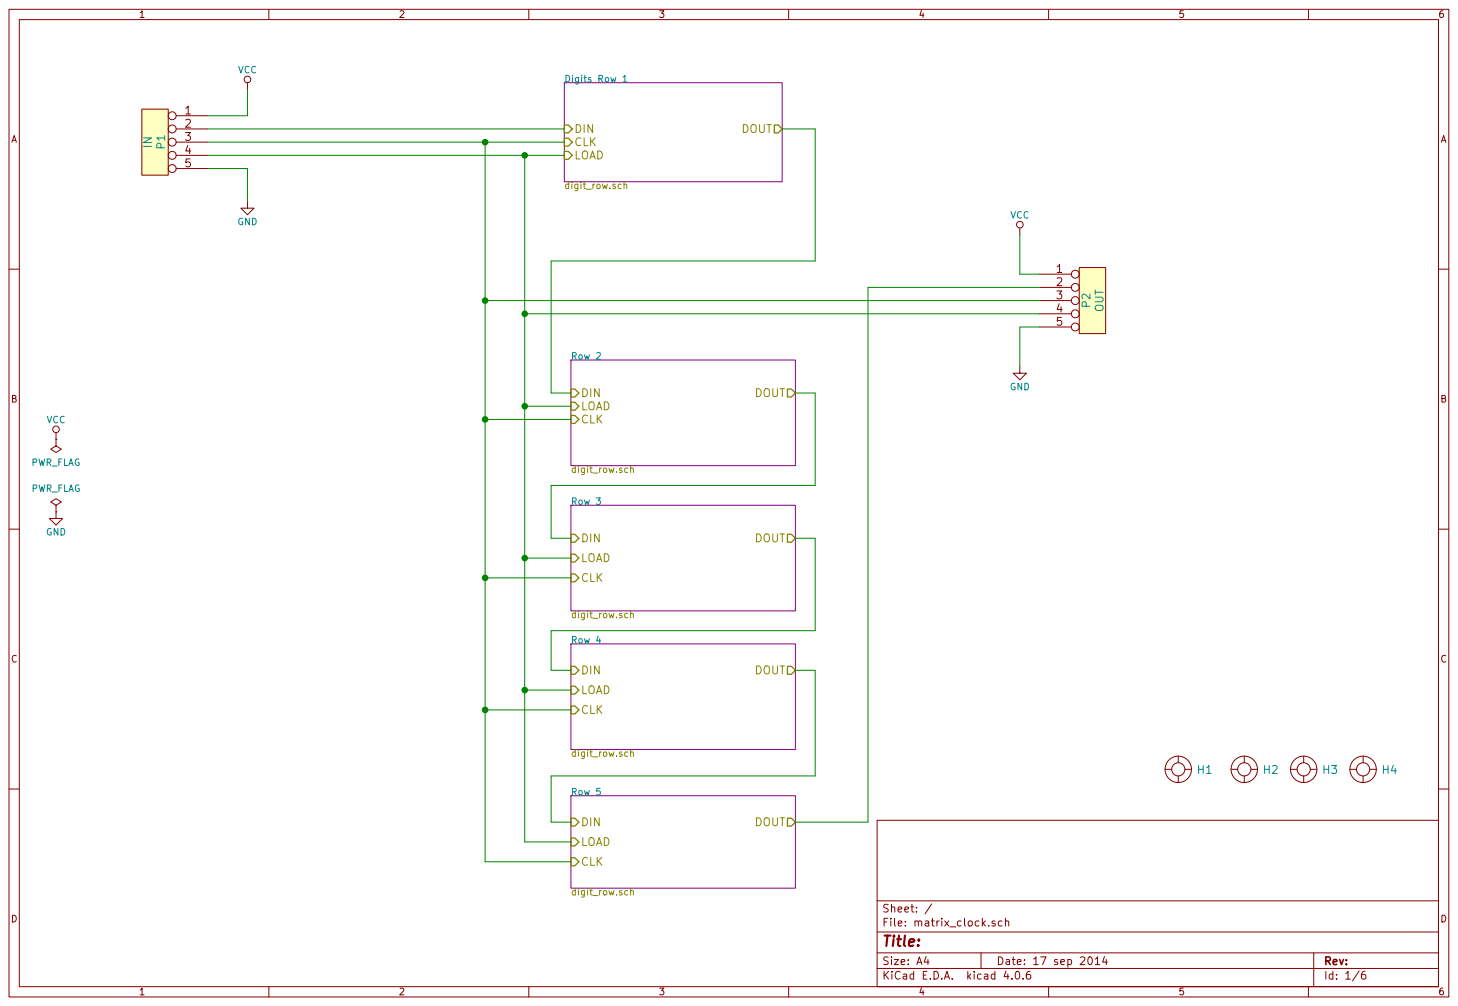
[picture p64: page 1]

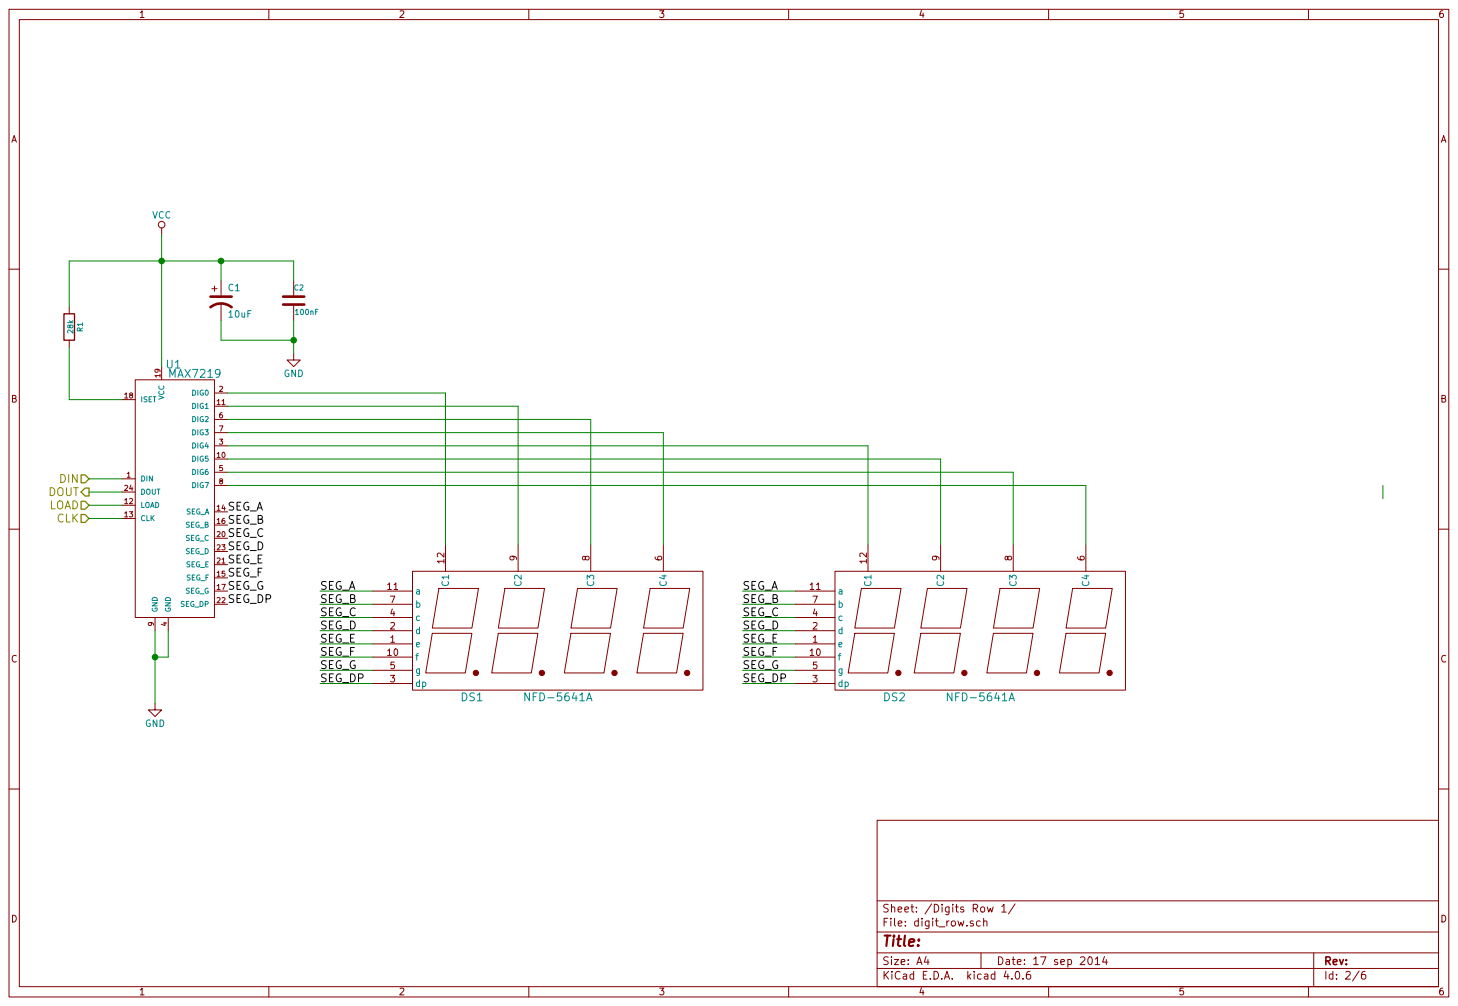
[picture p65: page 2]

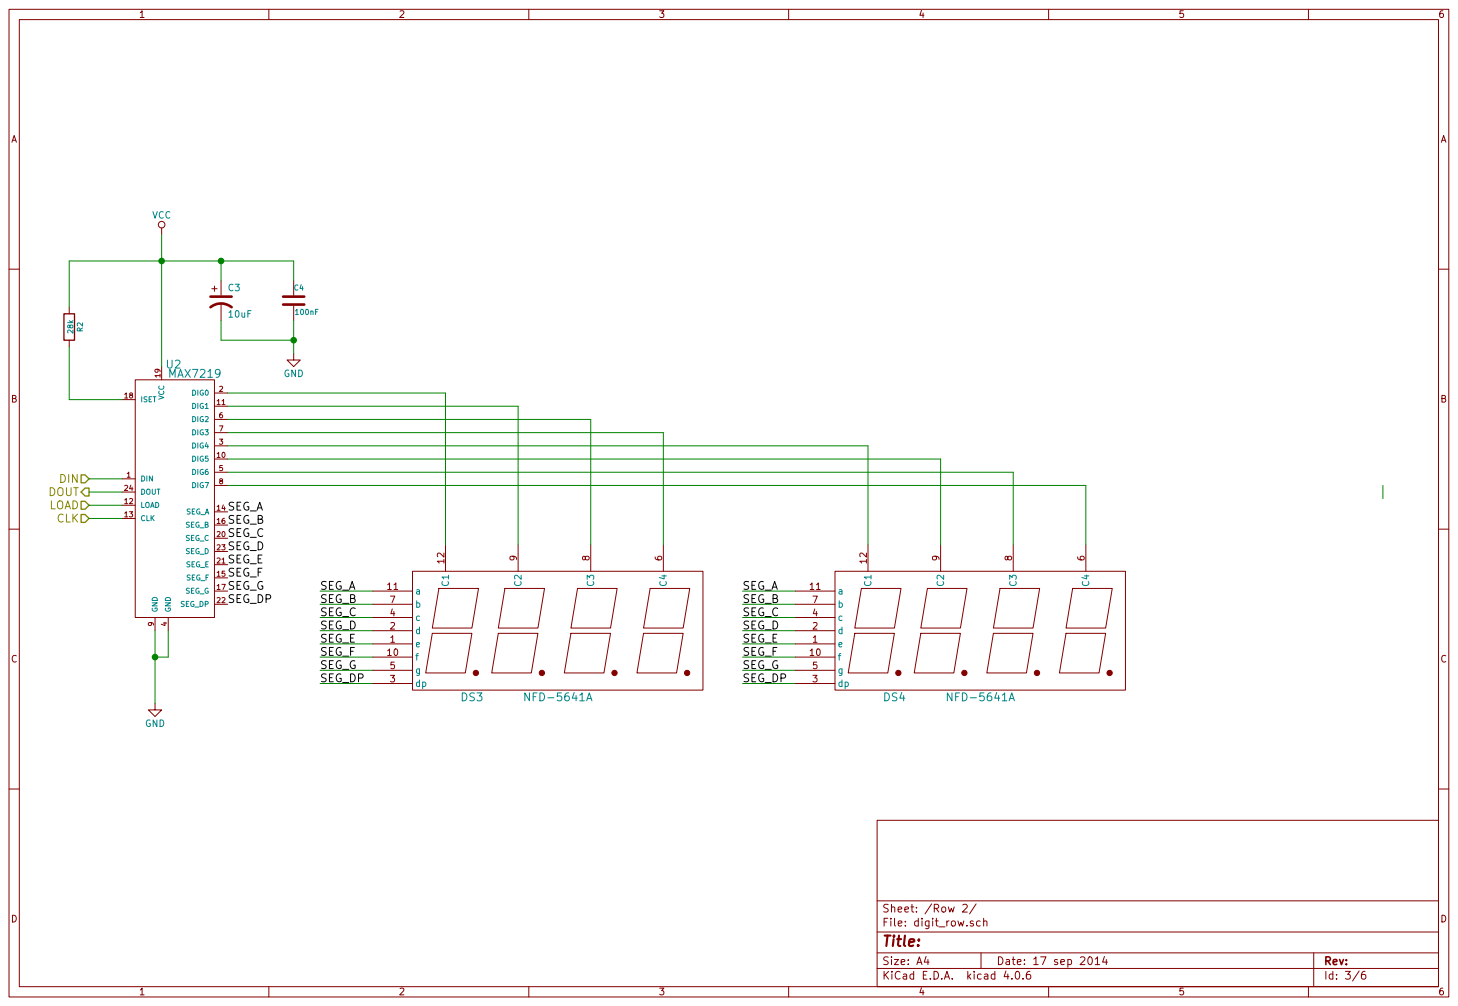
[picture p66: page 3]

File: digit_row.sch Sheet: /Row 2/
Id: 3/6 Title:

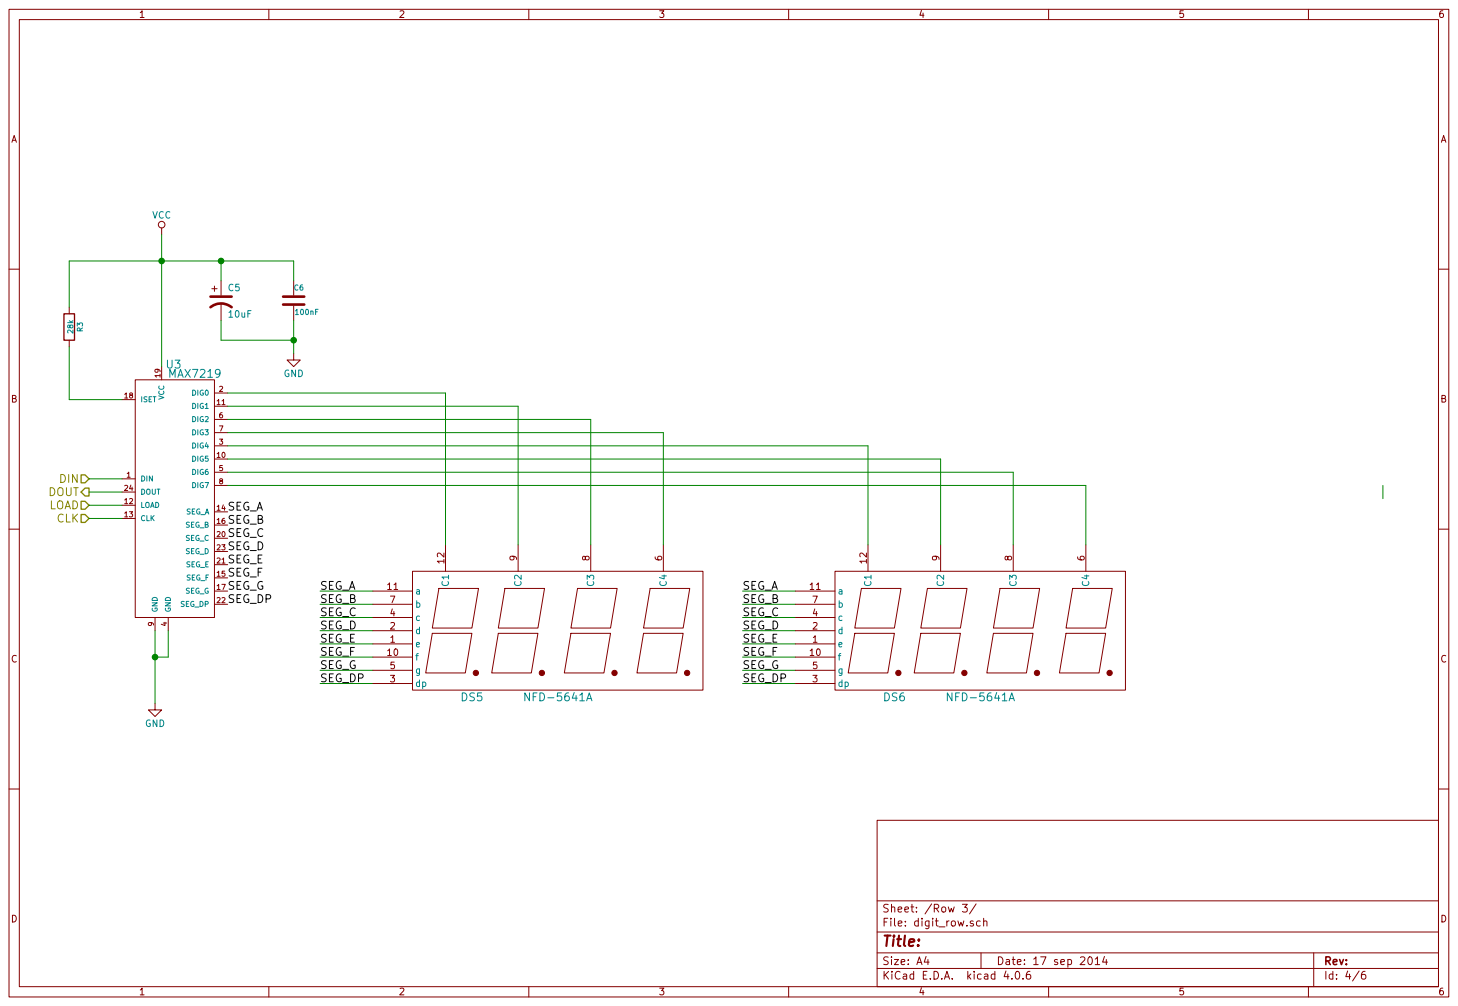
[picture p67: page 4]

File: digit_row.sch Sheet: /Row 3/
Id: 4/6 Title:

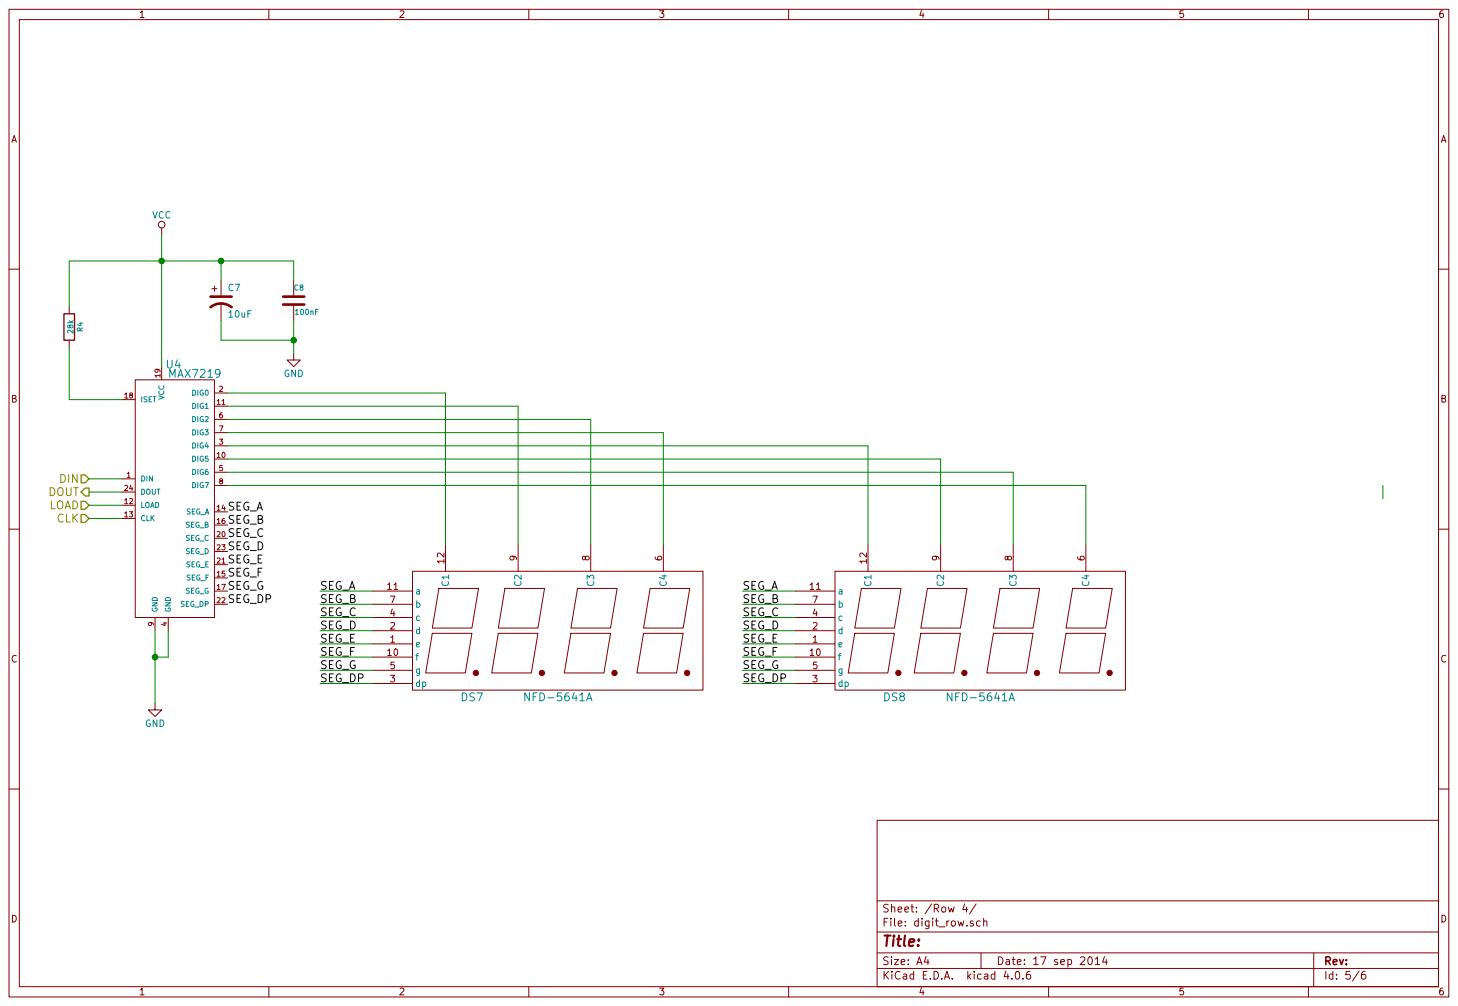
[picture p68: page 5]

File: digit_row.sch Sheet: /Row 4/
Id: 5/6 Title:

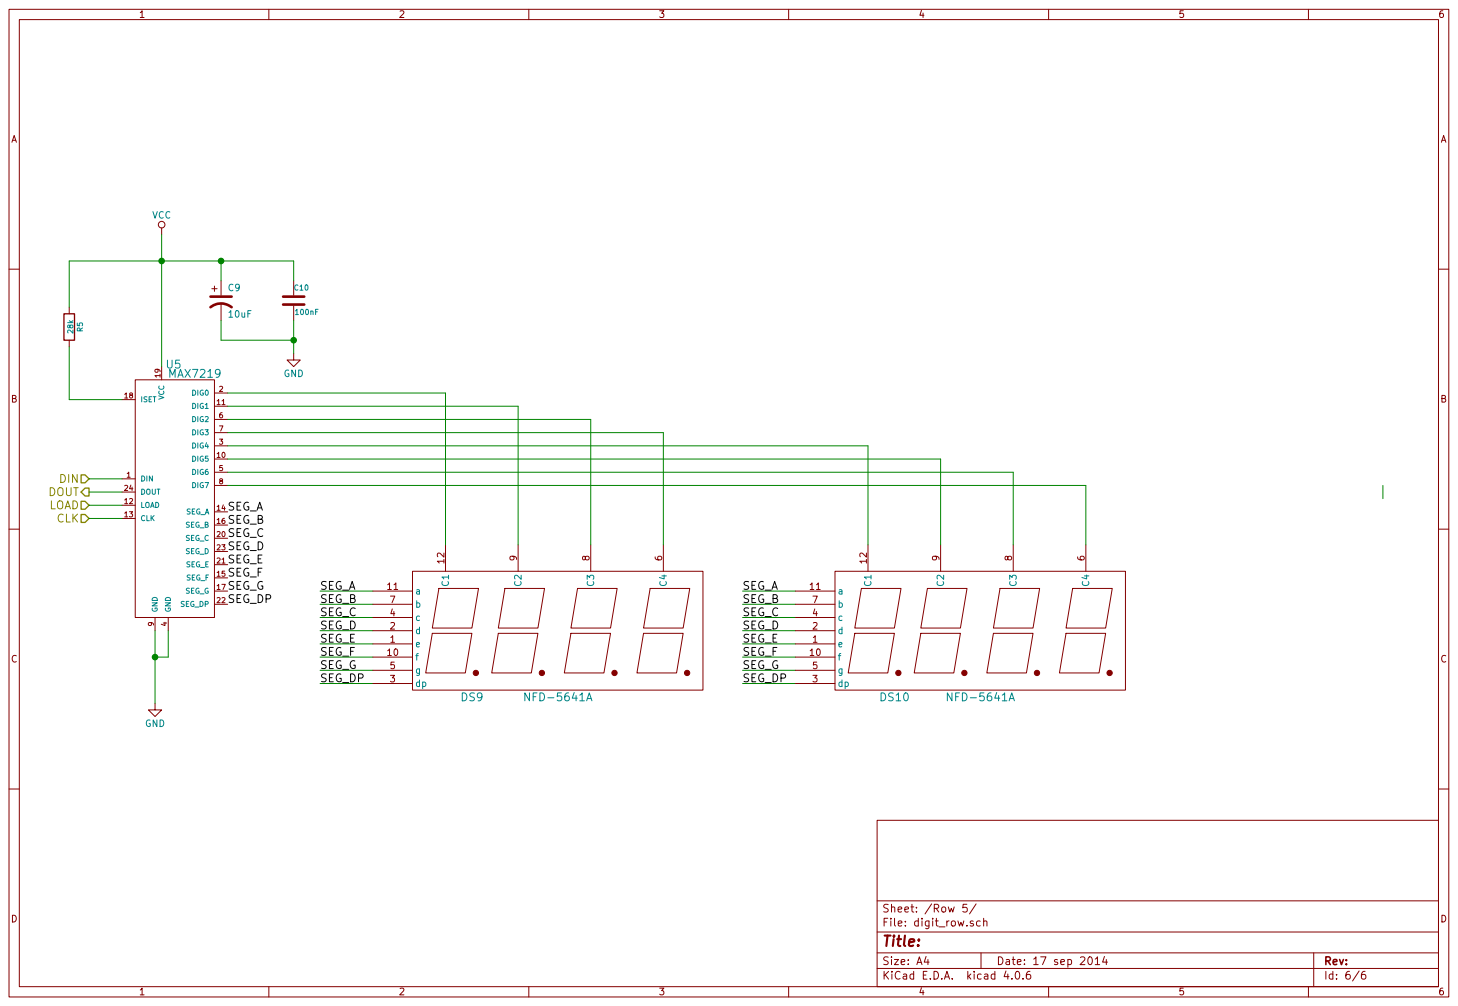
[picture p69: page 6]

File: digit_row.sch Sheet: /Row 5/
Id: 6/6 Title:
