bobc/bobc_hardware/RRP-LCD-Panel/RRP-LCD-Panel-Adapter-RAMPS.pdf

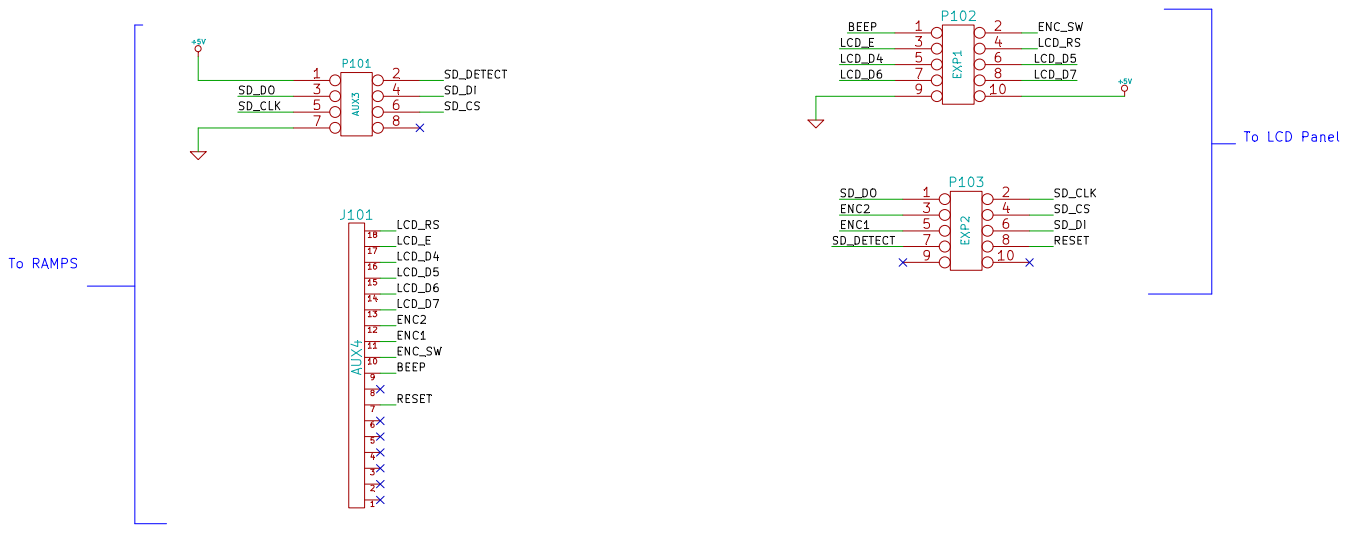
[picture p70: page 1]
