bobc/bobc_hardware/RRP-LCD-Panel/RRP-LCD-Panel.pdf

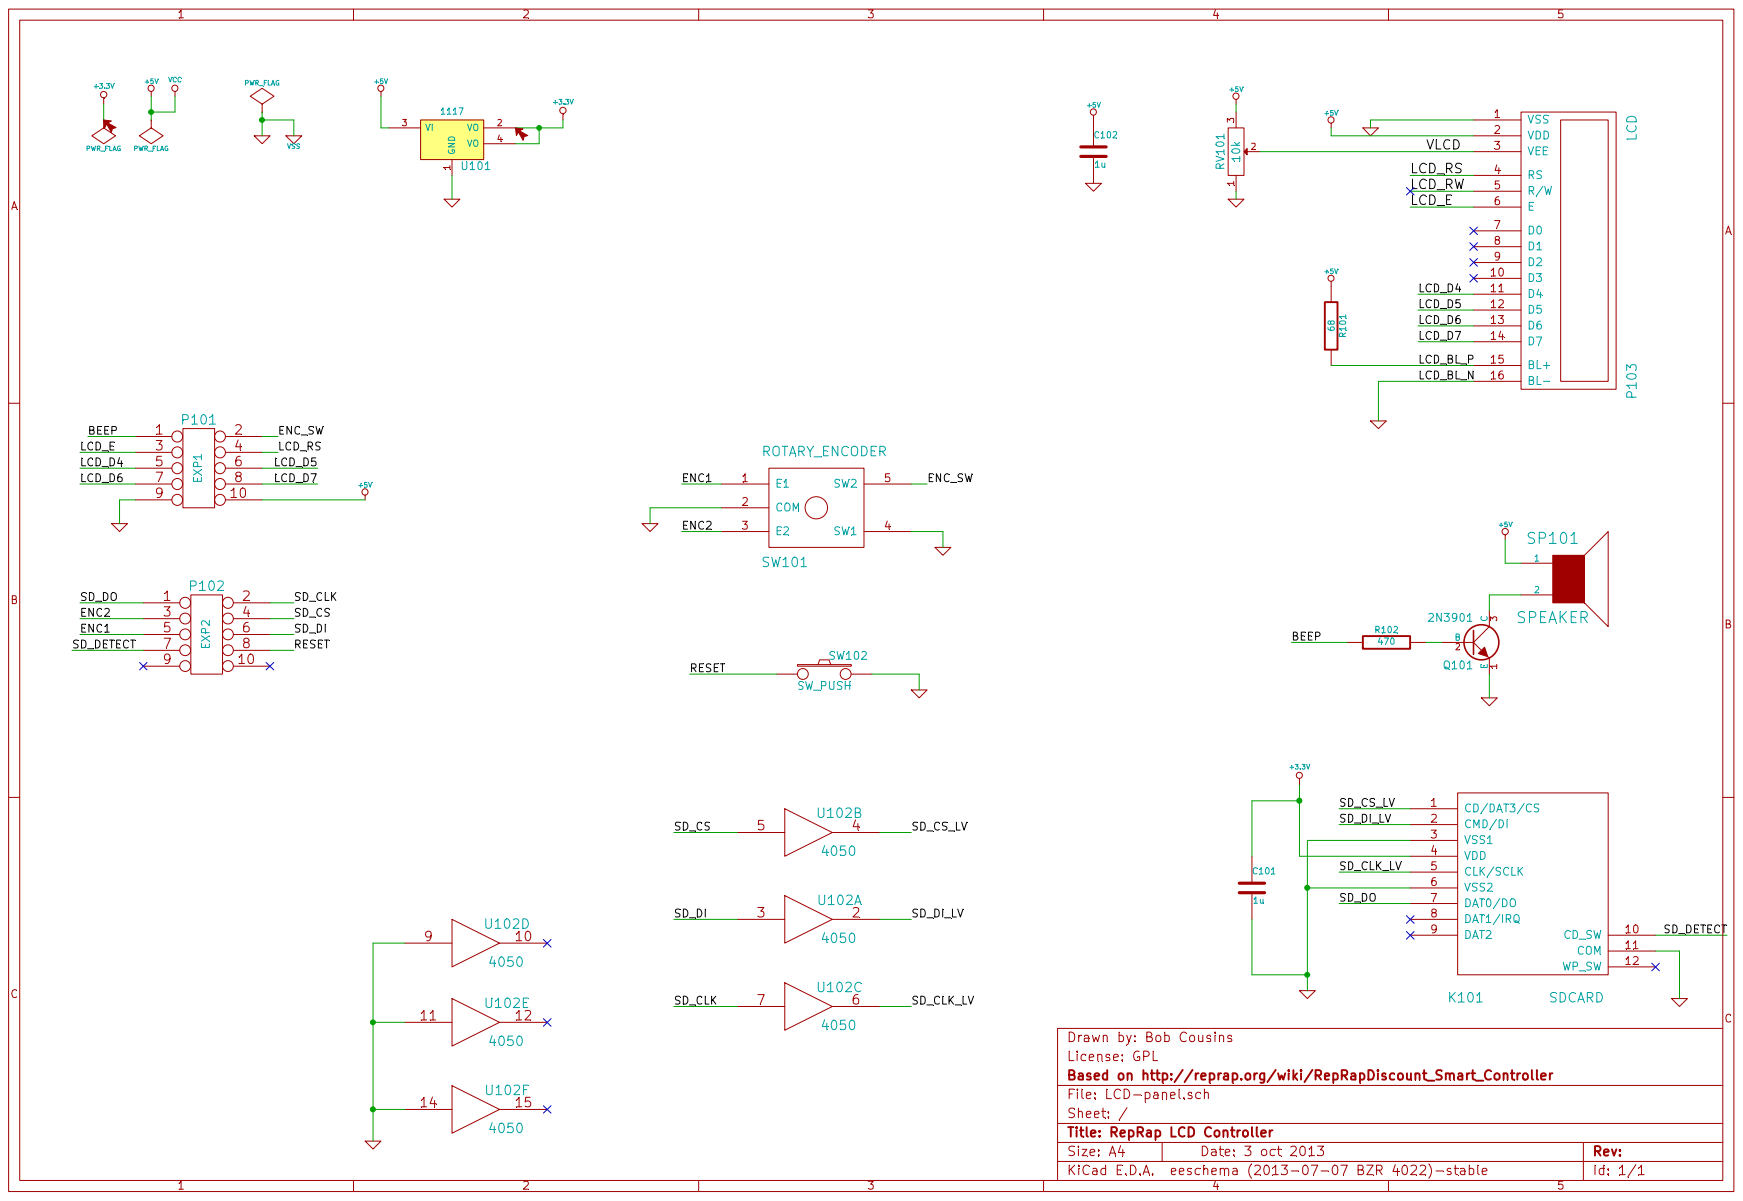
[picture p71: page 1]
