bobc/bobc_hardware/micro-stepper/micro-stepper-sch.pdf

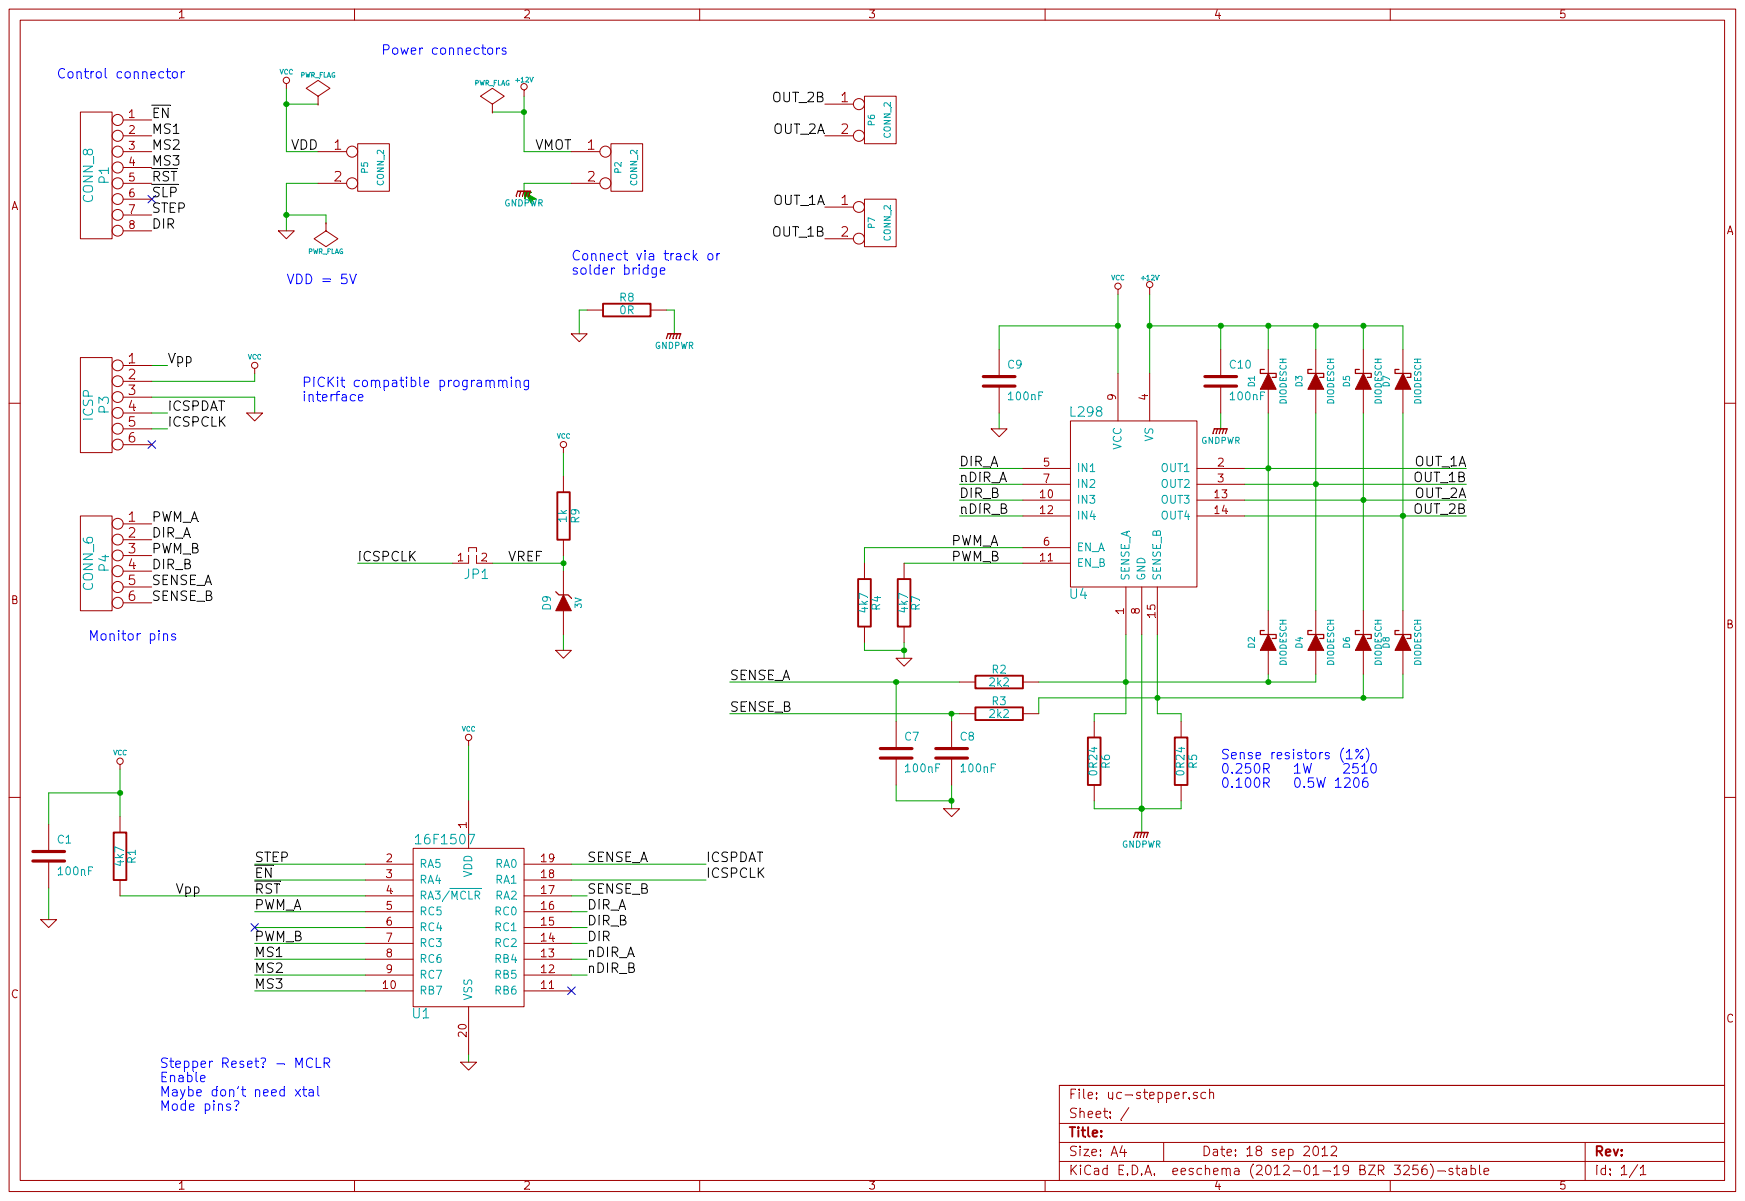
[picture p72: page 1]
