bobc/bobc_hardware/Control Panel/Control Panel-PCB.pdf

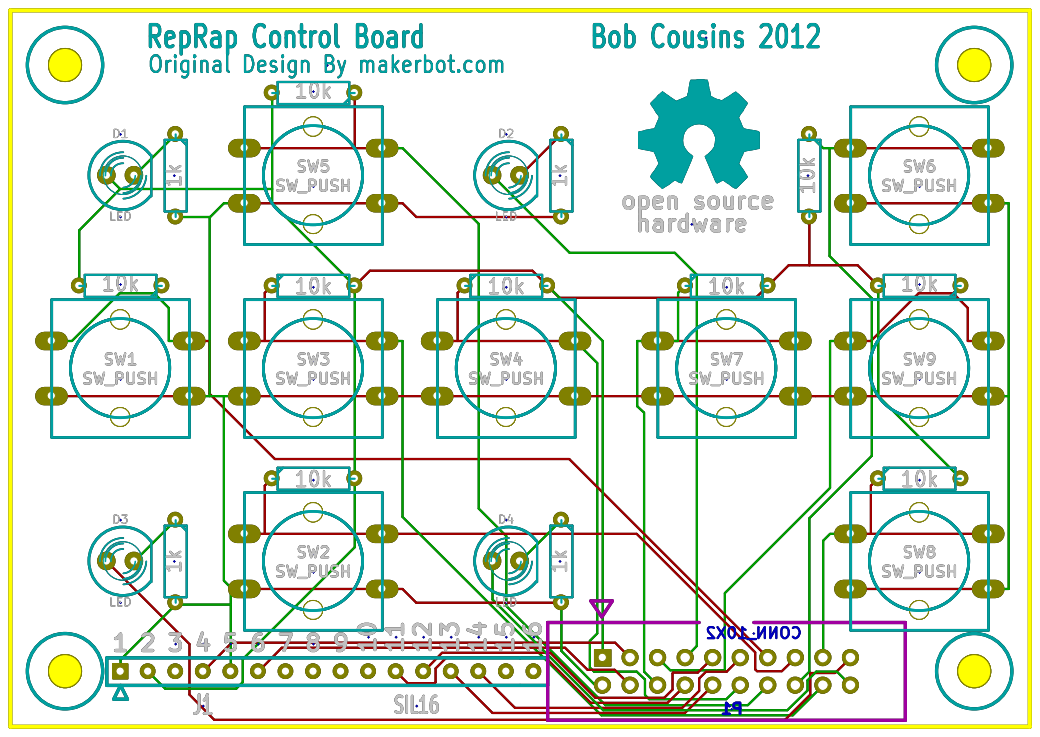
[picture p73: page 1]
