bobc/bobc_hardware/Control Panel/Control Panel-sch.pdf

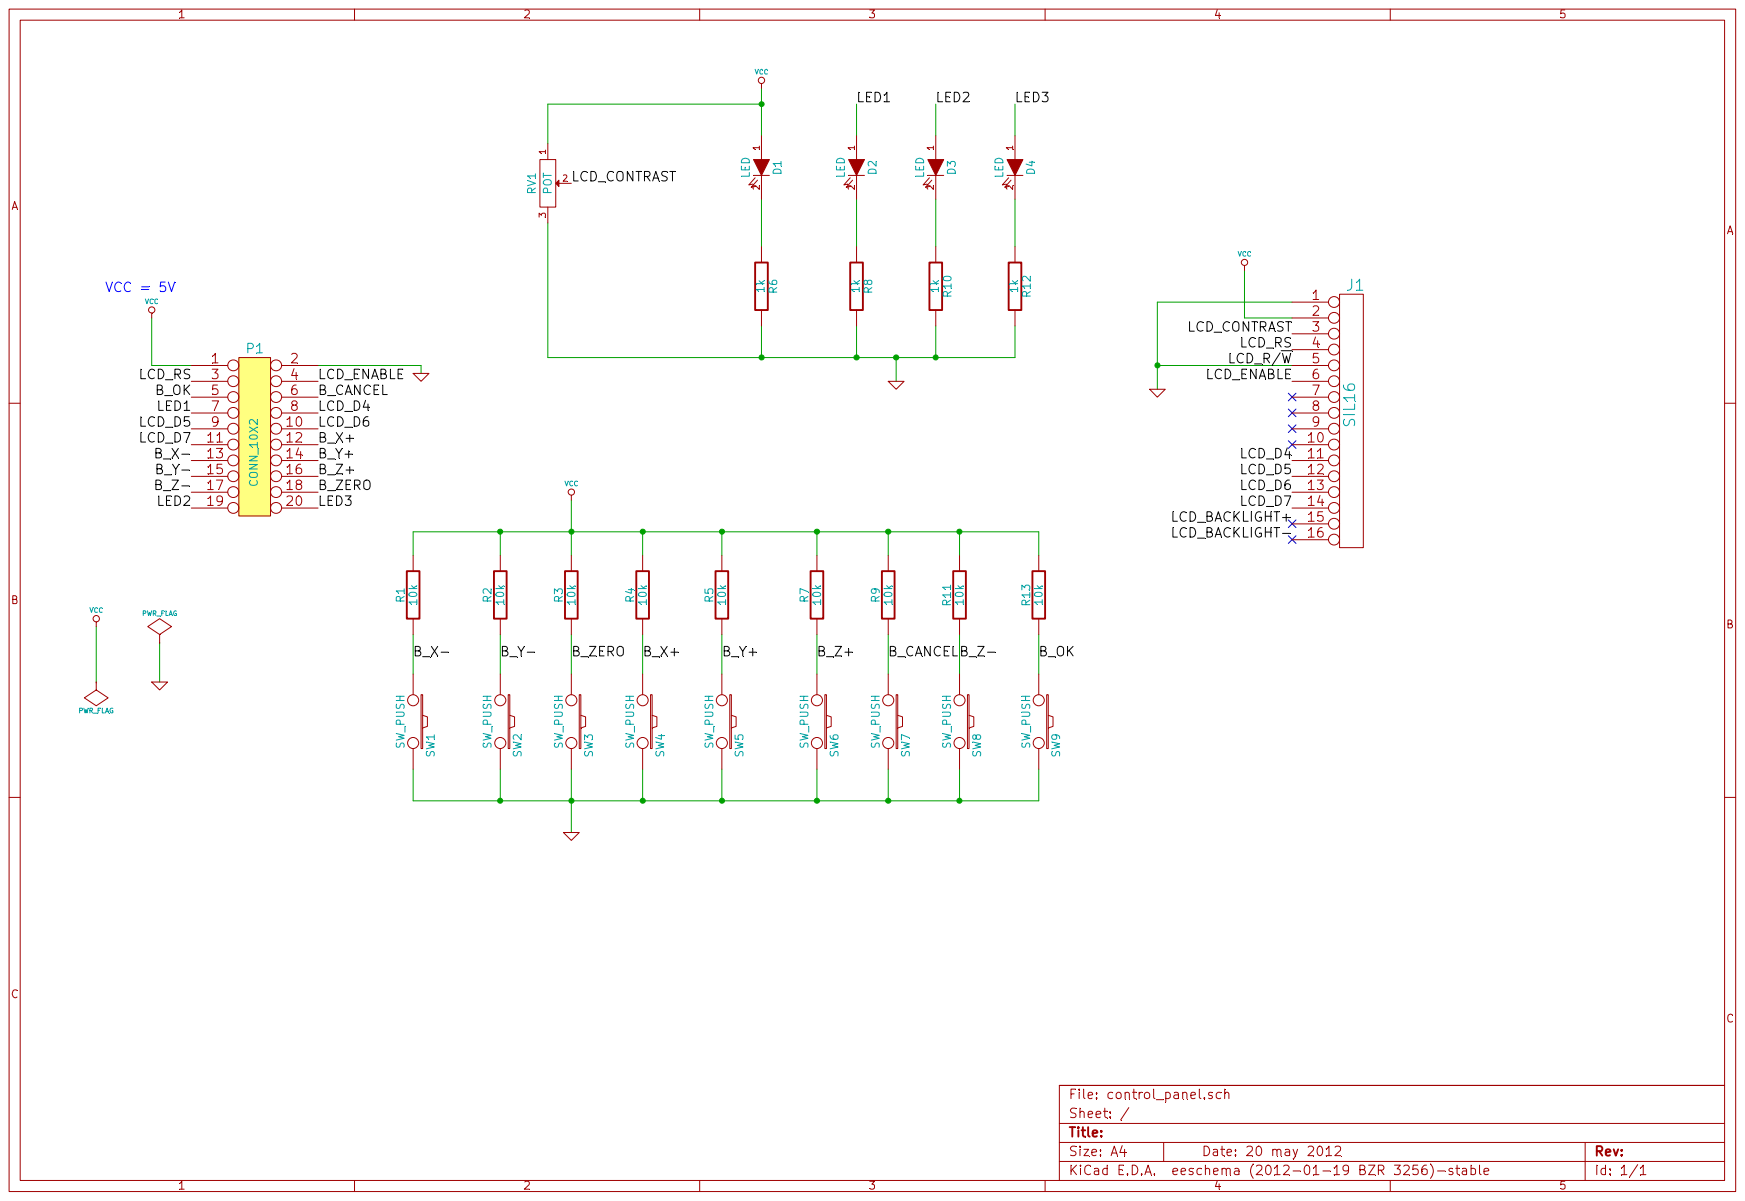
[picture p74: page 1]
