bobc/bobc_hardware/(list of files, drawings)

Other design files:
Due-RIB/RIB.dsn
Lyre_reboot/lyre.dsn
micro-stepper/uc-stepper.dsn
MicropendousX-1343/MicropendousX-1343.dsn
MS-F1/MS-F100.dsn
RAMPS-FD-EXT/RAMPS-FD-EXT.dsn
RAMPS-FD/RAMPS-FD.dsn
sango-bob/sango-bob.dsn
stepstick-bc2/stepstick-bc2.dsn
stepstick-bob/stepstick-bob.dsn
