bobc/bobc_hardware/CoreSam3x/CoreSam3x.sch

## KiCad design CoreSam3x/CoreSam3x.sch (2014-11-02)


Parts:
H1, H2: HOLE_RMC
M1: PCB_GREEN_RMC
M2: LOGO_OSHW; OSHW_logo_2

Notes on the sheet:
Some schematics and library symbols derived from Duet project https://github.com/T3P3/Duet licensed under the CERN OHW Licence v1.2
CoreSam3x
An Arduino® Due compatible SAM3X core board. Design goals - Board is 2 layer 50x50mm max dimension to take advantage of cheap PCB service. - Components are DIY friendly 0603 or larger - Self contained board, so can be programmed and run with just USB cable - Compatible with "Due" board target in Ar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
