bobc/bobc_hardware/Decapede/main.sch

## KiCad design Decapede/main.sch (2014-01-30)


Parts:
H1, H2, H3, H4: HOLE_RMC
J1: I2C
J25: GPIO
M1: PCB_GREEN_RMC
P42: Serial
P44: SPI
SHIELD1: ARDUINO_SHIELD

Connections:
+3.3V: SHIELD1.3V3
+V_LOGIC: J1.1, P44.2
AGND: SHIELD1.GND4 (GND), SHIELD1.GND5 (GND)
ARDUINO_5V: SHIELD1.5V
ARDUINO_VIN: SHIELD1.V_IN
A_axis: SHIELD1.8 (D8)
Aux_output: SHIELD1.13 (D13)
B_axis: SHIELD1.18 (D18-TX1)
C_axis: SHIELD1.19 (D19-RX1)
D_axis: SHIELD1.20 (D20-SDA)
E_axis: SHIELD1.21 (D21-SCL)
FET1: SHIELD1.12 (D12)
FET1_PWM: SHIELD1.6 (D6)
FET2: SHIELD1.11 (D11)
FET2_PWM: SHIELD1.5 (D5)
FET3: SHIELD1.10 (D10)
FET3_PWM: SHIELD1.4 (D4)
FET4: SHIELD1.9 (D9)
FET4_PWM: SHIELD1.3 (D3)
FET5: SHIELD1.7 (D7)
FET5_PWM: SHIELD1.2 (D2)
GND: J1.2, J25.4, P42.2, P42.4, P44.6, SHIELD1.GND
GPIO1: J25.1, P44.5, SHIELD1.45 (D45)
GPIO2: J25.2, SHIELD1.47 (D47)
GPIO3: J25.3, SHIELD1.49 (D49)
MISO: P44.1, SHIELD1.50 (D50-MISO)
MOSI: P44.4, SHIELD1.51 (D51-MOSI)
MotorA_Enable: SHIELD1.31 (D31)
MotorA_dir: SHIELD1.27 (D27)
MotorA_step: SHIELD1.29 (D29)
MotorB_Enable: SHIELD1.32 (D32)
MotorB_dir: SHIELD1.22 (D22)
MotorB_step: SHIELD1.23 (D23)
MotorC_Enable: SHIELD1.30 (D30)
MotorC_dir: SHIELD1.24 (D24)
MotorC_step: SHIELD1.25 (D25)
MotorD_Enable: SHIELD1.28 (D28)
MotorD_dir: SHIELD1.16 (D16-TX2)
MotorD_step: SHIELD1.17 (D17-RX2)
MotorE_Enable: SHIELD1.26 (D26)
MotorE_dir: SHIELD1.14 (D14-TX3)
MotorE_step: SHIELD1.15 (D15-RX3)
MotorV_Enable: SHIELD1.AD0
MotorV_dir: SHIELD1.42 (D42)
MotorV_step: SHIELD1.43 (D43)
MotorW_Enable: SHIELD1.48 (D48)
MotorW_dir: SHIELD1.40 (D40)
MotorW_step: SHIELD1.41 (D41)
MotorX_Enable: SHIELD1.37 (D37)
MotorX_dir: SHIELD1.33 (D33)
MotorX_step: SHIELD1.35 (D35)
MotorY_Enable: SHIELD1.44 (D44)
MotorY_dir: SHIELD1.36 (D36)
MotorY_step: SHIELD1.34 (D34)
MotorZ_Enable: SHIELD1.46 (D46)
MotorZ_dir: SHIELD1.38 (D38)
MotorZ_step: SHIELD1.39 (D39)
Reset: SHIELD1.RST
Rx0: P42.3, SHIELD1.0 (D0-RX0)
SCK: P44.3, SHIELD1.52 (D52-SCK)
SCL1: J1.3, SHIELD1.SCL1
SDA1: J1.4, SHIELD1.SDA1
SS: SHIELD1.53 (D53-SS)
TH1: SHIELD1.AD14 (AD14-CANRX)
TH2: SHIELD1.AD13 (DAC1-AD13)
TH3: SHIELD1.AD12 (DAC0-AD12)
TH4: SHIELD1.AD10
TH5: SHIELD1.AD9
TH6: SHIELD1.AD8
TH7: SHIELD1.AD6
TH8: SHIELD1.AD5
TH9: SHIELD1.AD3
TH10: SHIELD1.AD2
Tx0: P42.1, SHIELD1.1 (D1-TX0)
V_axis: SHIELD1.AD1
W_axis: SHIELD1.AD4
X_axis: SHIELD1.AD15 (AD15-CANTX)
Y_axis: SHIELD1.AD11
Z_axis: SHIELD1.AD7
