bobc/bobc_hardware/Lyre_reboot/lcd.sch

## KiCad design Lyre_reboot/lcd.sch (2015-02-05)

Schematic: lcd.sch

Parts:
P2: LCD 2.4
P3: LCD 2.4 SD
P4: LCD_2.8_INCH
P5: LCD 2.2
P10: LCD_2.4_INCH
Q1: BSS84

Notes on the sheet:
2.2" LCD with SPI i/f
2.4" LCD with SPI i/f and Touch i/f
SD card socket on LCD
2.8" LCD with 8/16 bit i/f and SPI Touch panel, SD card socket
2.4" LCD with 16 bit i/f and SPI Touch panel, SD card socket
http://www.elabpeers.com/2-4-tft-lcd-touch.html
also 2.8" TFT http://imall.iteadstudio.com/im120419010.html
http://www.ebay.co.uk/itm/171551006462?_trksid=p2055119.m1438.l2649&ssPageName=STRK%3AMEBIDX%3AIT
SD card only
Option
