bobc/bobc_hardware/Lyre_reboot/usb.sch

## KiCad design Lyre_reboot/usb.sch (2015-02-05)

Schematic: usb.sch

Parts:
P9: USBCONN-HOSTCAPABLE
R11, R12: 22

Notes on the sheet:
TODO: Host?
