bobc/bobc_hardware/matrix_clock_cc_4digit/digit_row.sch

## KiCad design matrix_clock_cc_4digit/digit_row.sch (2017-06-09)


Parts:
C1: 10uF; C_0805
C2: 100nF; C_0805
DS1, DS2: NFD-5641A; NFD-5641
R1: 28k; R_0805
U1: MAX7219; SOIC-24_7.5x15.4mm_Pitch1.27mm

Connections:
CLK: U1.13 (CLK)
DIN: U1.1 (DIN)
DOUT: U1.24 (DOUT)
GND: C1.2, C2.2, U1.4 (GND), U1.9 (GND)
LOAD: U1.12 (LOAD)
unnamed: DS1.6 (C4), U1.7 (DIG3)
unnamed: DS1.8 (C3), U1.6 (DIG2)
unnamed: DS1.9 (C2), U1.11 (DIG1)
unnamed: DS1.12 (C1), U1.2 (DIG0)
unnamed: DS2.6 (C4), U1.8 (DIG7)
unnamed: DS2.8 (C3), U1.5 (DIG6)
unnamed: DS2.9 (C2), U1.10 (DIG5)
unnamed: DS2.12 (C1), U1.3 (DIG4)
unnamed: R1.2, U1.18 (ISET)
SEG_A: DS1.11 (a), DS2.11 (a), U1.14 (SEG_A)
SEG_B: DS1.7 (b), DS2.7 (b), U1.16 (SEG_B)
SEG_C: DS1.4 (c), DS2.4 (c), U1.20 (SEG_C)
SEG_D: DS1.2 (d), DS2.2 (d), U1.23 (SEG_D)
SEG_DP: DS1.3 (dp), DS2.3 (dp), U1.22 (SEG_DP)
SEG_E: DS1.1 (e), DS2.1 (e), U1.21 (SEG_E)
SEG_F: DS1.10 (f), DS2.10 (f), U1.15 (SEG_F)
SEG_G: DS1.5 (g), DS2.5 (g), U1.17 (SEG_G)
VCC: C1.1, C2.1, R1.1, U1.19 (VCC)
