bobc/bobc_hardware/mbeduinopresso-FD/mbeduinopresso.sch

## KiCad design mbeduinopresso-FD/mbeduinopresso.sch (2013-10-21)

Schematic: mbeduinopresso.sch

Parts:
J101: LPCXPRESSO_1769_HEADER
SHIELD101: ARDUINO_DUE_SHIELD

Notes on the sheet:
mbed: 5V USB output LPCXpresso: not connected
Used for onboard SD connector
Supply to shield
Bootloader/debug
