bobc/bobc_hardware/Firmware/control_panel_v2/projectconfig.h

/**************************************************************************/
/*! 
    @file     projectconfig.h
    @author   Bob Cousins (bobcousins42@googlemail.com)

    @section LICENSE

*/
/**************************************************************************/

#ifndef _PROJECTCONFIG_H_
#define _PROJECTCONFIG_H_

/* microbuilder LPC1343 core files */
#include "core/lpc134x.h"
#include "core/sysdefs.h"

#include "core/cpu/cpu.h"
#include "core/gpio/gpio.h"
#include "core/systick/systick.h"
#include "core/pmu/pmu.h"

/* project specific */
#include "micropendousx-1343.h"

#endif
