bobc/bobc_hardware/(commit log)

2012-05-22 Kicad libraries
2012-05-22 RepRap Control Panel project
    [control_panel.brd, control_panel.dsn, control_panel.sch]
2012-05-22 LPC13xx/11xx Module project based on MicropendousX-1343
    [MicropendousX-1343.brd, MicropendousX-1343.dsn, MicropendousX-1343.sch]
2012-05-22 Add the opendous kicad libraries
2012-05-22 Add some pdfs, PCB images
    [control_panel.csv, control_panel.sch]
2012-08-11 Template project for R2C2 shield
    [R2C2_shield_template.brd, R2C2_shield_template.sch]
2012-09-23 Microcontroller stepper driver
    [dualhbridge.sch, uc-stepper - Copy.brd, uc-stepper - Copy.sch, uc-stepper.brd, uc-stepper.csv, uc-stepper.dsn, uc-stepper.sch]
2012-09-24 Update schematic, PCB
    [dualhbridge.sch, uc-stepper.brd, uc-stepper.dsn, uc-stepper.sch]
2012-09-24 Sanguino inspired stepper controller
    [sango-bob.brd, sango-bob.csv, sango-bob.dsn, sango-bob.sch, sango-bom.ods, sango-conn.sch, sango-cpu.sch, sango-power.sch]
2012-09-24 A "stepstick" for Allegro A4982/A4985 chips
    [stepstick-bc2.brd, stepstick-bc2.csv, stepstick-bc2.dsn, stepstick-bc2.sch]
2012-09-25 Update gate drive on P-FETS; remove external diodes
    [dualhbridge.sch, uc-stepper.sch]
2012-09-26 Update micro-stepper project
    [dualhbridge.sch, uc-stepper.brd, uc-stepper.dsn, uc-stepper.sch]
2012-09-30 Version 0.1
    [stepstick-bc2.brd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]
2012-10-02 Sango-bc printer controller version 0.1
    [p1merge.cfg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]
2012-10-23 Module for STM32F10x micros
    [MS-F100.brd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]
2012-10-31 Add schematic pdf
2013-01-03 Sango-bc v0.2
    [sango-bob.brd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]
2013-01-03 stepstick-bc2 v2
    [p1merge.cfg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]
2013-01-17 Update Kicad libraries
2013-01-22 Updates to symbols and fix some ERC errors
    [sango-bob.sch, sango-conn.sch, sango-cpu.sch, sango-power.sch, sango-steppers.sch, stepper-e1.sch, stepper-x.sch, stepper-y.sch]
2013-02-02 Update Kicad libs
2013-02-02 New project RAMPS-FD and RIB
    [RAMPS-FD.brd, RAMPS-FD.sch, RIB.brd, RIB.dsn, RIB.sch, RIB_interface.sch, con_inputs.sch, con_outputs.sch]
2013-02-03 Move walter Kicad libraries
2013-02-03 Update all walter Kicad libraries to latest version
2013-03-24 Clone of stepstick A4988
    [stepstick-bob.brd, stepstick-bob.dsn, stepstick-bob.sch]
2013-03-24 RAMPS-FD update
    [RAMPS-FD.brd, RAMPS-FD.dsn, RAMPS-FD.sch, con_inputs.sch, con_outputs.sch, steppers.sch]
2013-06-25 Update libraries for Kicad
2013-06-25 First version of RAMPS-FD, RIB
    [RAMPS-FD-v3.brd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]
2013-09-19 Move RAMPS-RIB files to new folder Due-RIB
    [RIB.brd, RIB.dsn, RIB.sch, RIB_interface.sch]
2013-09-19 Move the RIB gerbers
    [RIB-Back.gbl, RIB-Front.gtl, RIB-Mask_Back.gbs, RIB-Mask_Front.gts, RIB-PCB_Edges.gbr, RIB-SilkS_Back.gbo, RIB-SilkS_Front.gto, RIB.drl]
2013-09-22 Update part libraries NB requires "new" KiCad format BZR4004 or later
2013-09-22 RAMPS-FD extension board
    [Mosfets.sch, RAMPS-FD-EXT.brd, RAMPS-FD-EXT.dsn, RAMPS-FD-EXT.sch, Steppers.sch, Thermistors.sch]
2013-09-22 Updates to RAMPS-FD
    [Power.sch, RAMPS-FD.brd, RAMPS-FD.dsn, RAMPS-FD.sch, con_inputs.sch, con_misc.sch, con_outputs.sch, e-stop.sch]
2013-09-22 RAMPS-FS: add schematic for extra mosfets
    [Extra_Mosfets.sch]
2013-09-24 RAMPS-FS latest updates
    [Extra_Mosfets.sch, Power.sch, RAMPS-FD.brd, RAMPS-FD.dsn, RAMPS-FD.sch, con_inputs.sch, con_misc.sch, con_outputs.sch]
2013-09-24 RAMPS-FD latest updates
    [Extra_Mosfets.sch, Power.sch, RAMPS-FD.brd, RAMPS-FD.dsn, RAMPS-FD.sch, con_inputs.sch, con_misc.sch, con_outputs.sch]
2013-09-25 RAMPS-FD: latest update
    [Extra_Mosfets.sch, Power.sch, RAMPS-FD.brd, RAMPS-FD.dsn, RAMPS-FD.sch, con_inputs.sch, con_misc.sch, con_outputs.sch]
2013-09-27 EXT4: update schematic, layout
    [Mosfets.sch, RAMPS-FD-EXT.brd, RAMPS-FD-EXT.dsn, RAMPS-FD-EXT.sch, Steppers.sch, Thermistors.sch]
2013-09-27 RAMPS-FD: update schematic, layout
    [Extra_Mosfets.sch, Power.sch, RAMPS-FD.brd, RAMPS-FD.dsn, RAMPS-FD.sch, con_inputs.sch, con_misc.sch, con_outputs.sch]
2013-09-27 RRP-LCD-Panel: New projects for RepRap LCD Panel and adapters
    [LCD-panel-adapter-lvc.kicad_pcb, LCD-panel-adapter-lvc.sch, LCD-panel-adapter.sch, LCD-panel.kicad_pcb, LCD-panel.sch]
2013-09-27 AMX-1769: new project, Mbed compatible core in Arduino form factor
    [AMX-1769.brd, AMX-1769.sch, Connectors.sch, Ethernet.sch, Power.sch]
2013-09-28 RAMPS-FD-EXT; routing and gerbers
    [RAMPS-FD-EXT.brd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]
2013-09-28 LCD Panel adapter: use 74HC07
    [LCD-panel-adapter-lvc.kicad_pcb, LCD-panel-adapter-lvc.sch]
2013-09-28 Move LCD-panel-adapter-lvc to new folder
    [LCD-panel-adapter-lvc.kicad_pcb, LCD-panel-adapter-lvc.sch]
2013-09-29 LCD-Panel-adapter: routing, gerbers
    [LCD-panel-adapter-lvc-B_Cu.gbl, LCD-panel-adapter-lvc-B_Mask.gbs, LCD-panel-adapter-lvc-B_SilkS.gbo, LCD-panel-adapter-lvc-Edge_Cuts.gbr, LCD-panel-adapter-lvc-F_Cu.gtl, LCD-panel-adapter-lvc-F_Mask.gts, LCD-panel-adapter-lvc-F_SilkS.gto, LCD-panel-adapter-lvc.drl]
2013-10-02 RAMPS-FD: remove old gerbers
    [RAMPS-FD-v3-Back.gbl, RAMPS-FD-v3-Front.gtl, RAMPS-FD-v3-Mask_Back.gbs, RAMPS-FD-v3-Mask_Front.gts, RAMPS-FD-v3-PCB_Edges.gbr, RAMPS-FD-v3-SilkS_Back.gbo, RAMPS-FD-v3-SilkS_Front.gto, RAMPS-FD-v3.drl]
2013-10-03 RAMPS-FD: version 1 Rev A
    [Extra_Mosfets.sch, Power.sch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]
2013-10-07 Update Arduino Mega/Due footprints
2013-10-07 LCD-Panel-adapter-FD: update and add gerbers
    [LCD-panel-adapter-lvc-B_Cu.gbl, LCD-panel-adapter-lvc-B_Mask.gbs, LCD-panel-adapter-lvc-B_SilkS.gbo, LCD-panel-adapter-lvc-Edge_Cuts.gbr, LCD-panel-adapter-lvc-F_Cu.gtl, LCD-panel-adapter-lvc-F_Mask.gts, LCD-panel-adapter-lvc-F_SilkS.gto, LCD-panel-adapter-lvc.drl]
2013-10-07 RAMPS-FD-EXT: update, schematic, routing and gerbers
    [Mosfets.sch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]
2013-10-07 RAMPS-FD: Rev A revised
    [Extra_Mosfets.sch, Power.sch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]
2013-10-07 RRP-LCD-Panel: update schematics, add PDFS
    [LCD-panel-adapter.sch, LCD-panel.sch]
2013-10-10 RAMPS-FD: new version with 6 extruders
    [Mosfets.sch, Mosfets2.sch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]
2013-10-14 Preliminary BOM
    [RAMPS-FD_BOM.ods]
2013-10-21 New project: Arduino compatible baseboard for LPCXpresso
    [Power.sch, comms.sch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]
2013-10-22 Board size limit 100mm
    [mbeduinopresso.kicad_pcb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]
2013-12-10 Update silkscreen LED-0805-RED
2013-12-10 RAMPS-FD: update silkscreen
    [RAMPS-FD.brd, RAMPS-FD_BOM.ods]
2013-12-11 Moving ESTOP connector (Bug #9) Moved the ESTOP connector nearer centre of board. Moved MOT-GND and +5V lines in this area to allow for this change.
    [RAMPS-FD.brd]
2013-12-13 Change tracks around Resistor Packs (Bug #13) Fixed track oddness around RP801, RP802, RP2 and RP3. Also increased the text size around RP1, RP2, RP3, RP802 and RP803 to improve silkscreen printing.
    [RAMPS-FD.brd]
2013-12-13 Renable zone fill (Bug #13)
    [RAMPS-FD.brd]
2013-12-14 Top left corner cleanup. Prep-work for moving Q201 (Bug #8), as it affects placements of tracks in/around P403. Lots of tracks and components moved - All related to P210, P902, P901, P218, P405, P403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
    [RAMPS-FD.brd]
2013-12-14 Rearrange components around P404, P403. Includes movement of Q201 (Bug #8) and C101 (Bug #6). Lots of track changes, including top layer copper zones around F101 and Q201.
    [RAMPS-FD.brd]
2013-12-14 Major cleanup around C301, C302, C303, C501. This is prep work for Bug #3 and Bug #5. Also managed to re-route Y_EN_BUF away from between C301, R301, C504 and R504.
    [RAMPS-FD.brd]
2013-12-15 Lots of general track clean-up. Includes trackwork to address Bug #16. Includes a lot of general clean-up that has increased the overall copper ground-plane size.
    [RAMPS-FD.brd]
2013-12-18 RAMPS-FD schematic changes: #3 replace C301, C302, C303 and C501 with ceramic 0805; #4 change endstop connectors to 6x1 and 6x2 to allow key position #9 change E-STOP connector to KK type; #18 add 10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
    [Extra_Mosfets.sch, Power.sch, RAMPS-FD.sch, con_inputs.sch, con_misc.sch, con_outputs.sch, e-stop.sch, steppers.sch]
2013-12-18 RAMPS-FD schematic: remove some redundant pulldowns; add some explanatory notes; update PDF
    [con_inputs.sch, con_outputs.sch, e-stop.sch]
2013-12-20 RAMPS-FD schematic: flip the endstop connector P802 for easier layout
    [Extra_Mosfets.sch, Power.sch, RAMPS-FD.sch, con_inputs.sch, con_misc.sch, con_outputs.sch, e-stop.sch, steppers.sch]
2013-12-22 Major layout changes to add extra components. Addresses bug #20, bug #19, and bug #18. Notable U1 relocation (adds room for Thermistor protection, less FET drive impedance). Notable orientation chang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
    [RAMPS-FD.brd]
2013-12-23 Extensive copper thickening (Bug #23). Most of smaller thickness +V_LOGIC, MOT_GND and +5V doubled in thickness. Note: There are a few small places where the tracks should be thicker but will require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
    [RAMPS-FD.brd]
2014-01-01 library update, TL431 symbol and TO92 footprints
2014-01-01 RAMPS-FS schematic update: improve thermistor input protection (WIP); allow external 5V input; use 220R gate drive resistors on all MOSFETs
    [Extra_Mosfets.sch, Power.sch, RAMPS-FD.sch, con_inputs.sch, con_misc.sch, con_outputs.sch, e-stop.sch, steppers.sch]
2014-01-02 Libraries: update with TL431 SOT23; RAMPS-FD schematic: finish up thermistor protection design; update footprint assignments
    [Extra_Mosfets.sch, Power.sch, RAMPS-FD.sch, con_inputs.sch, con_misc.sch, con_outputs.sch, e-stop.sch, steppers.sch]
2014-01-03 RAMPS-FD: update board layout with new thermistor protection (#3, #5); locking conenctor for EM-STOP (#9); add external 5V connector (#11)
    [RAMPS-FD.brd, e-stop.sch]
2014-01-08 Library update: add ground pins for Arduino-Mega-Due-Shield; add footprint for SureStepper type drivers
2014-01-08 RAMPS-FD: add seperate ground for thermistors and improve layout
    [Extra_Mosfets.sch, Power.sch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]
2014-01-12 Libraries: add dual diode
2014-01-12 RAMPS-FD: replace 1N4004 with 10A part; add mosfet for LED; use AREF for thermistor reference voltage; improve power trace and copper fill
    [Extra_Mosfets.sch, Power.sch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]
2014-01-12 RAMPS-FD: improvements to ground fill
    [RAMPS-FD.brd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]
2014-01-19 New project: Decapede. Recaptured in Kicad from original by Armani Creations.
    [Decapede.sch, Endstops.sch, FET Drivers 2.sch, FET_Drivers.sch, FET_PWM_Drivers.sch, Power.sch, SD_Card.sch, Stepstick.sch]
2014-01-27 Add some footprints for fuses, connectors etc
2014-01-27 Updates for Decapede project.
    [Decapede-B_Cu.gbl, Decapede-B_Mask.gbs, Decapede-B_Paste.gbp, Decapede-B_SilkS.gbo, Decapede-Dwgs_User.gbr, Decapede-Edge_Cuts.gbr, Decapede-F_Cu.gtl, Decapede-F_Mask.gts]
2014-01-30 Decapede update: add fuses for each main section; change endstops to use 0V instead of 5V; more space for stepper drivers to allow latching connectors
    [DecapadeExpansion-V1R1.GTL, DecapadeExpansion-V1R1.GTO, DecapadeExpansion-V1R1.GTP, DecapadeExpansion-V1R1.GTS, Decapede-B_Cu.gbl, Decapede-B_Mask.gbs, Decapede-B_Paste.gbp, Decapede-B_SilkS.gbo]
2014-01-30 Library update: add Keystone fuse holders
2014-02-18 Control Panel: update to makerbot spec
    [control_panel.dsn, control_panel.kicad_pcb, control_panel.sch]
2014-02-18 Control Panel: remove old files
    [control_panel.brd, control_panel.dsn]
2014-02-18 New project, R2C2_cp_shield: a R2C2 shield for connecting LCD control panel
    [R2C2_shield_template.brd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]
2014-02-18 R2C2_cp_shield: add some notes to schematic
    [R2C2_shield_template.sch]
2014-02-27 RAMPS-FD V2.A
    [Extra_Mosfets.sch, Mosfets.sch, Mosfets2.sch, Power.sch, RAMPS-FD-EXT.brd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]
2014-11-01 New project: CoreSam3x
    [CoreSam3x.kicad_pcb, CoreSam3x.sch, Power.sch, Processor.sch]
2014-11-01 CoreSam3x : add gerbers
    [CoreSam3x-B_Cu.gbl, CoreSam3x-B_Mask.gbs, CoreSam3x-B_SilkS.gbo, CoreSam3x-Edge_Cuts.gbr, CoreSam3x-F_Cu.gtl, CoreSam3x-F_Mask.gts, CoreSam3x-F_SilkS.gto, CoreSam3x.drl]
2014-11-02 CoreSam3x: improvements to layout, component selection
    [CoreSam3x-B_Cu.gbl, CoreSam3x-B_Mask.gbs, CoreSam3x-B_SilkS.gbo, CoreSam3x-Edge_Cuts.gbr, CoreSam3x-F_Cu.gtl, CoreSam3x-F_Mask.gts, CoreSam3x-F_SilkS.gto, CoreSam3x.drl]
2014-11-02 CoreSam3x : add BOM, finalise layout
    [CoreSam3x.kicad_pcb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]
2014-11-02 CoreSam3x: update pdf/pcb images
2014-11-02 CoreSam3x : pcb image
2014-11-30 New project: Lyre music player reboot
    [User.sch, audio.sch, cpu.sch, lcd.sch, lyre.dsn, lyre.kicad_pcb, lyre.sch, power.sch]
2014-12-02 Lyre updates
    [User.sch, audio.sch, cpu.sch, lcd.sch, lyre.sch, power.sch, sdcard.sch, usb.sch]
2015-01-04 Update MS-F1 project (STM32F1xx module) to be Maple Mini compatible
    [MS-F100-B_Mask.gbs, MS-F100-B_SilkS.gbo, MS-F100-Back.gbl, MS-F100-Edge_Cuts.gbr, MS-F100-F_Mask.gts, MS-F100-F_SilkS.gto, MS-F100-Front.gtl, MS-F100.drl]
2015-02-05 MS-F1 : update
    [MS-F100-B_Mask.gbs, MS-F100-B_SilkS.gbo, MS-F100-Back.gbl, MS-F100-F_Mask.gts, MS-F100-F_SilkS.gto, MS-F100-Front.gtl, MS-F100-Mask_Back.gbs, MS-F100-Mask_Front.gts]
2015-02-05 Lyre_reboot: Update
    [Arduino_conn.sch, User.sch, audio.sch, cpu.sch, lcd.sch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]
2015-02-05 MS-F1: update BOM
    [MS-F100.csv]
2015-02-05 MS-F1: update schematic pdf
2016-02-03 Mini LED clock
    [Thermistor Lookup Table.ods, led_array.sch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]
2016-02-03 LED Clock with Arduino Mini
    [led_clock-B_Cu.gbl, led_clock-B_Mask.gbs, led_clock-B_SilkS.gbo, led_clock-Edge_Cuts.gbr, led_clock-F_Cu.gtl, led_clock-F_Mask.gts, led_clock-F_SilkS.gto, led_clock-Outline.gko]
2016-03-21 RAMPS-FD tidy up
    [Extra_Mosfets.sch, Power.sch, RAMPS-FD.brd, RAMPS-FD.sch, con_inputs.sch, con_misc.sch, con_outputs.sch, e-stop.sch]
2016-04-20 Updated RAMPS-FD V2.B schematic
2016-04-22 RAMPS-FD v2.1 bugfix. Fix problem with unconnected analog reference.
    [Extra_Mosfets.sch, Power.sch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]
2017-06-09 7 segment display panel
    [digit_row.sch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]
