bobc/bobc_hardware/(notices)

Notices in the files:
MS-F1/MS-F100.kicad_pcb:
Copyright Under the Creative Commons Attribution License
MicropendousX-1343/MicropendousX-1343.sch:
http://creativecommons.org/licenses/by/3.0
MS-F1/MS-F100.sch:
CC-BY-SA
Mini_LED_Clock/mini_led_clock.sch:
Licensed under GPL v2
